alperbasarn/QNOB/ScreenBase_V2/Renders/side.png

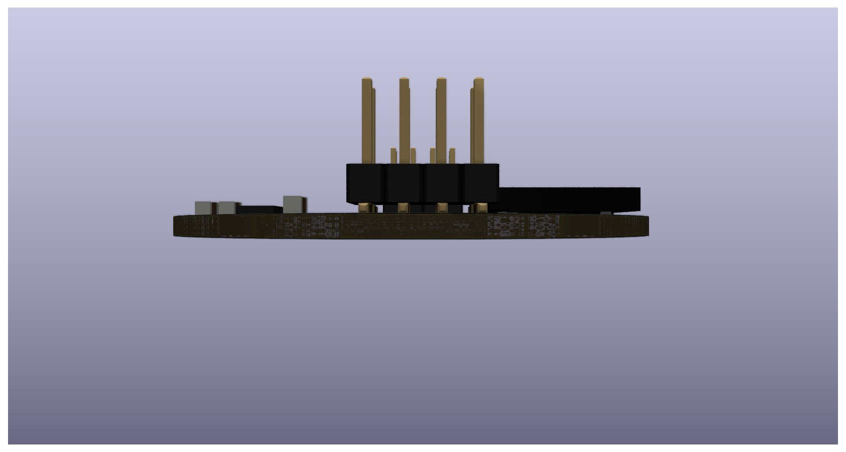
ScreenBase_V2/Renders/side.png
