alperbasarn/QNOB/DRV8313-breakout/V1/DRV8313-breakout/Doc/Top.png

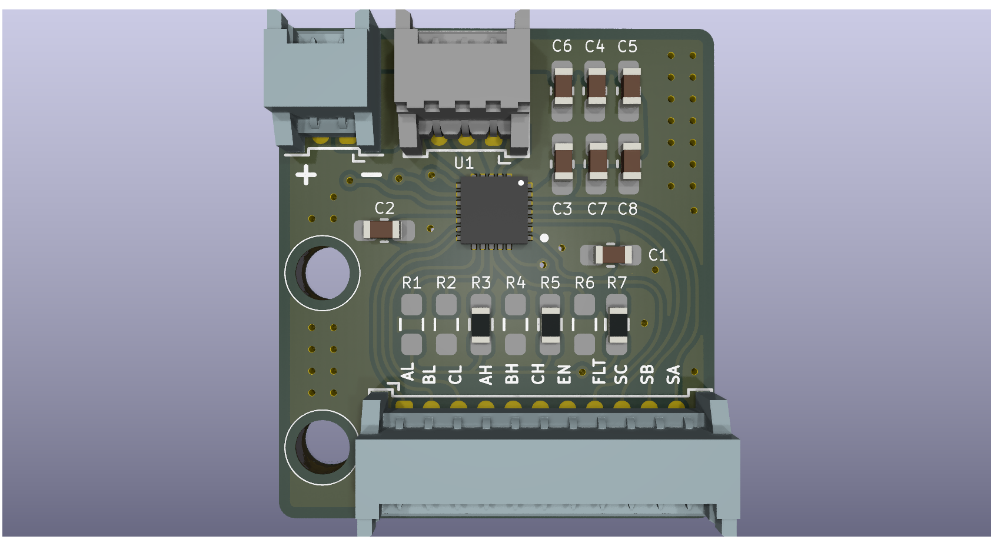
DRV8313-breakout/V1/DRV8313-breakout/Doc/Top.png
