alperbasarn/QNOB/V11/V11_report.txt

PCB statistics report
=====================
- Date: 14/01/2026 09:56:32
- Project: V11
- Board name: V11

Board
-----
- Width: 47,8708 mm
- Height: 47,4310 mm
- Area: 1745,9295 mm²

Pads
----
- Through hole: 36
- SMD: 88
- Connector: 0
- NPTH: 0

Vias
----
- Through vias: 74
- Blind/buried: 0
- Micro vias: 0

Components
----------

| | Front Side | Back Side | Total |
|---|---|---|---|
|THT: | 0 | 4 | 4 |
|SMD: | 24 | 0 | 24 |
|Unspecified:  | 4 | 0 | 4 |
|Total: | 28 | 4 | 32 |

Drill holes
-----------

| Count | Shape | X Size | Y Size | Plated | Via/Pad | Start Layer | Stop Layer |
|---|---|---|---|---|---|---|---|
| 74 | Round | 0,4000 mm | 0,4000 mm | PTH | Via | F.Cu | B.Cu |
| 16 | Round | 1,2700 mm | 1,2700 mm | PTH | Pad | F.Cu | B.Cu |
| 9 | Round | 0,2000 mm | 0,2000 mm | PTH | Pad | F.Cu | B.Cu |
| 7 | Round | 0,5000 mm | 0,5000 mm | PTH | Pad | F.Cu | B.Cu |
| 4 | Round | 1,0000 mm | 1,0000 mm | PTH | Pad | F.Cu | B.Cu |
