alperbasarn/QNOB/PCB/V6/QNOB_V6/Datasheets/LM66100-3v3.png

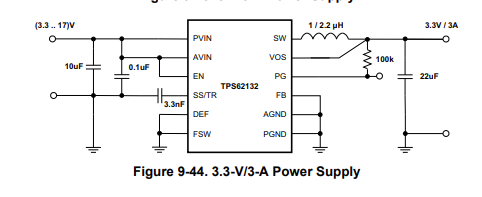
PCB/V6/QNOB_V6/Datasheets/LM66100-3v3.png
