alperbasarn/QNOB/ScreenBase_V2/Renders/bottom.png

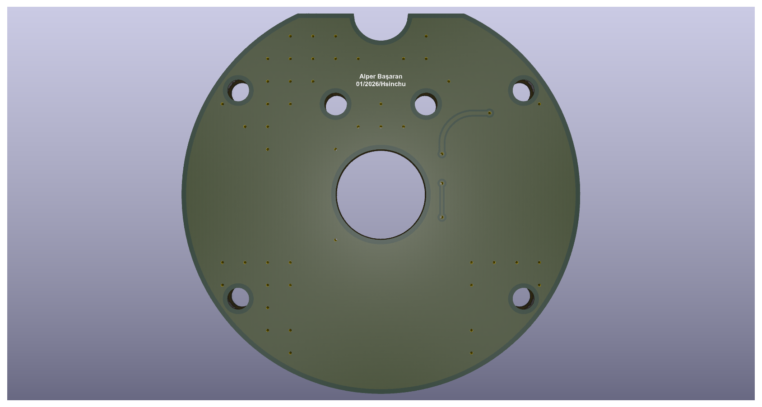
ScreenBase_V2/Renders/bottom.png
