alperbasarn/QNOB/ScreenBase_V2/Renders/iso.png

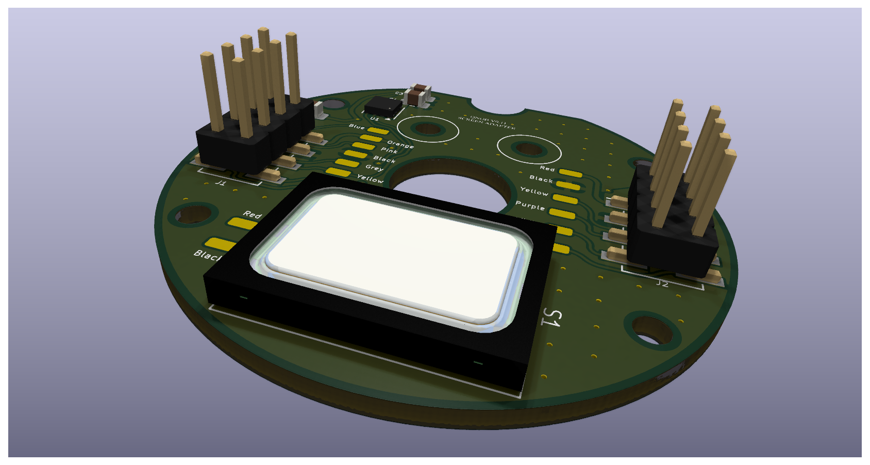
ScreenBase_V2/Renders/iso.png
