alperbasarn/QNOB/ScreenBase_V2/Renders/top.png

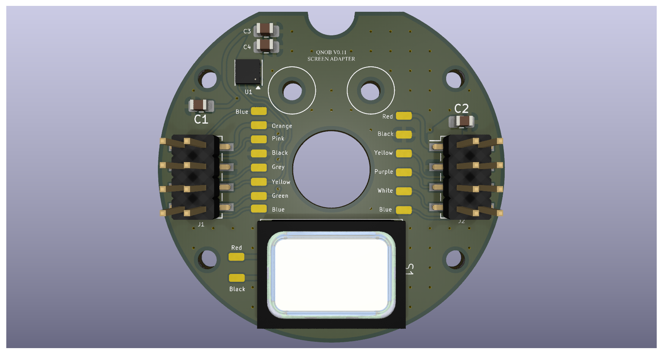
ScreenBase_V2/Renders/top.png
