alperbasarn/QNOB/V11/Fabrication/BOM.xlsx

Comment | Designator | Footprint | JLCPCB Part #（optional）
100n | C1,C3,C5,C7,C9 | 603 | C14663
4.7u | C2 | 603 | C19666
10u | C4,C6,C8 | 603 | C96446
0 | R3,R5 | 603 | C21189
4.7k | R7,R8,R9 | 603 | C23162
DRV8311HRWR | U1 | WQFN-24(3x3) | C5218862
MT6701QT | U3 | QFN-16-1EP_3x3mm_P0.5mm_EP1.7x1.7mm | C2913974
