alperbasarn/QNOB/PCB/V6/QNOB_V6/QNOB_V6/Fabrication/BOM.xlsx

Comment | Designator | Footprint | LCSC Part #（optional）
4.7u | C1 | 603 | C19666
10u | C2 | 603 | C96446
10u | C3 | 603 | C96446
100n | C4 | 603 | C14663
100n | C5 | 603 | C14663
100n | C6 | 603 | C14663
100n | C7 | 603 | C14663
100n/0402 | C8 | 402 | C1525
100n/0402 | C10 | 402 | C1525
100n/0402 | C11 | 402 | C1525
100n/0402 | C12 | 402 | C1525
100n/0402 | C13 | 402 | C1525
100n/0402 | C14 | 402 | C1525
100n/0402 | C15 | 402 | C1525
100n/0402 | C16 | 402 | C1525
100n/0402 | C17 | 402 | C1525
100n/0402 | C18 | 402 | C1525
100n/0402 | C19 | 402 | C1525
100n/0402 | C20 | 402 | C1525
100n/0402 | C21 | 402 | C1525
100n/0402 | C22 | 402 | C1525
100n/0402 | C23 | 402 | C1525
100n/0402 | C24 | 402 | C1525
100n/0402 | C25 | 402 | C1525
100n/0402 | C26 | 402 | C1525
100n/0402 | C27 | 402 | C1525
100n/0402 | C28 | 402 | C1525
100n/0402 | C29 | 402 | C1525
100n/0402 | C30 | 402 | C1525
100n/0402 | C31 | 402 | C1525
100n/0402 | C32 | 402 | C1525
100n/0402 | C33 | 402 | C1525
100n/0402 | C34 | 402 | C1525
100n/0402 | C35 | 402 | C1525
100n/0402 | C36 | 402 | C1525
100n/0402 | C37 | 402 | C1525
100n/0402 | C38 | 402 | C1525
100n/0402 | C39 | 402 | C1525
100n/0402 | C40 | 402 | C1525
100n/0402 | C41 | 402 | C1525
100n/0402 | C42 | 402 | C1525
100n/0402 | C43 | 402 | C1525
100n/0402 | C44 | 402 | C1525
100n/0402 | C45 | 402 | C1525
100n/0402 | C46 | 402 | C1525
100n/0402 | C47 | 402 | C1525
100n/0402 | C48 | 402 | C1525
100n/0402 | C49 | 402 | C1525
100n/0402 | C50 | 402 | C1525
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
Adressable RGB LED | U51 | 606 | C2890035
Adressable RGB LED | U52 | 606 | C2890035
Adressable RGB LED | U53 | 606 | C2890035
RTC | U54 | 606 | C26858
Environment sensor | U55 | SMT | C3664478
Lux sensor | U57 | SMT | C511034
32768 crystal | Y1 | 3215-2p | C32346
