alperbasarn/QNOB/3D/Design/Big/KNOB_Basic.stl

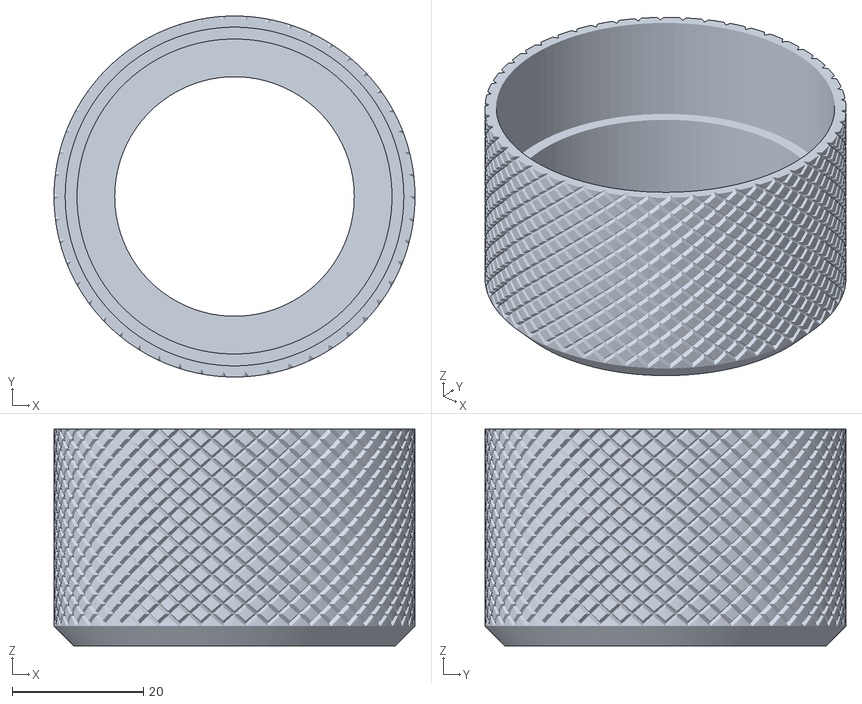
[picture p9: CAD file, 2026-02-01]
3D/Design/Big/KNOB_Basic.stl
55.0 x 55.0 x 33.0
