alperbasarn/QNOB/screen/CAD/ESP32-C6-Touch-AMOLED-1.43-3dFile/ESP32-C6-Touch-AMOLED-1.43-20250704/ESP32-C6-Touch-AMOLED-1_43-20250704.stp

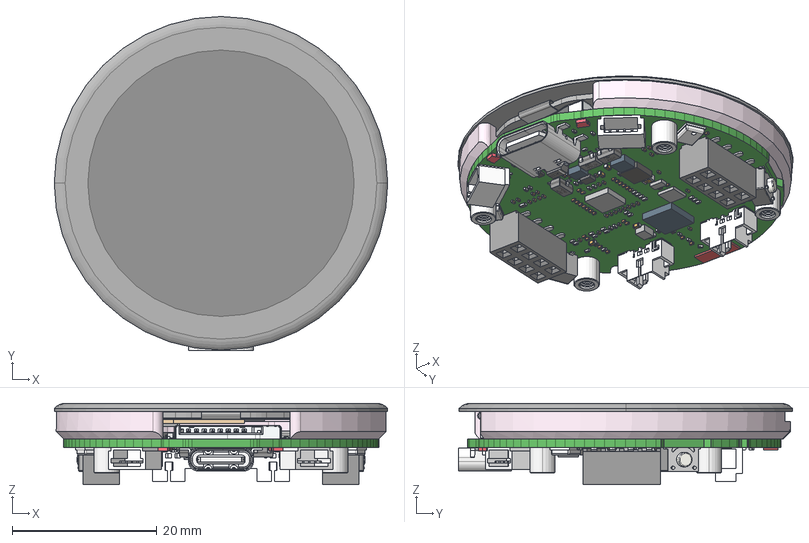
[picture p10: CAD file, 2026-02-01]
screen/CAD/ESP32-C6-Touch-AMOLED-1.43-3dFile/ESP32-C6-Touch-AMOLED-1.43-20250704/ESP32-C6-Touch-AMOLED-1_43-20250704.stp
46.0 x 46.1 x 11.2 mm
BOARD
USER_LIBRARY-0201_0603M__CAP_1 x 103
USER_LIBRARY-0201_0603M__CAP_2 x 103
USER_LIBRARY-0201_0603M__CAP_3 x 103
USER_LIBRARY-RES_0603-0201_1 x 66
USER_LIBRARY-RES_0603-0201_2 x 66
USER_LIBRARY-RES_0603-0201_3 x 66
USER_LIBRARY-RES_0603-0201_4 x 66
EXTRUDED-33499
EXTRUDED-49664
EXTRUDED-50059
EXTRUDED-50454
USER_LIBRARY-WQFN-20
EXTRUDED-70543
EXTRUDED-70938
PIN5TO8_SOP8 x 8
SOP8_BODY
EXTRUDED-76596
EXTRUDED-77015 x 6
EXTRUDED-77412
EXTRUDED-77807
SSOP-16-0_635
5_1_2_A x 7
_7_AF0 x 7
SOT-23 x 3
EXTRUDED-285074
EXTRUDED-285921
EXTRUDED-286316
SWITCHER-4_5X3_3XH3_4 x 2
PITCH1MM-4PIN-SMT-HORIZONTAL x 2
EXTRUDED-300107
EXTRUDED-300502
SOD123F
3_1_A x 7
3_1_2_A x 2
EXTRUDED-388418
TYPE-C_SMT-9X3X7_3
SOD523 x 2
SMTSO-M2-3_5ET x 4
HEADER-SMD-F-2_54-2X4P-H5 x 2
HP1_25MM-2P-SMT-VERTICAL x 2
MIC-4X3X1MM
MIC_2
DO0143FMST02_TP
DO0143FMST14-00
ESP32-C6-TOUCH-1_43-PMMA
