alperbasarn/QNOB/CAD/.STEP/bracketWithScrew v17.step

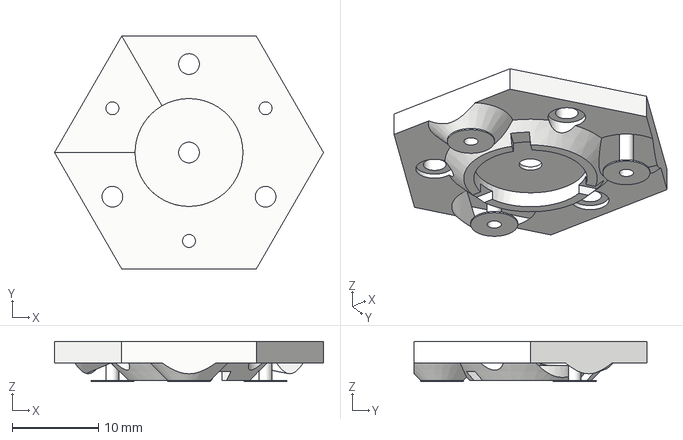
[picture p12: CAD file, 2025-05-01]
CAD/.STEP/bracketWithScrew v17.step
31.2 x 27.0 x 4.65 mm
