alperbasarn/QNOB/PCB/V3/QNOB_V5/3D printed parts/3mf/spacer_new v15.3mf

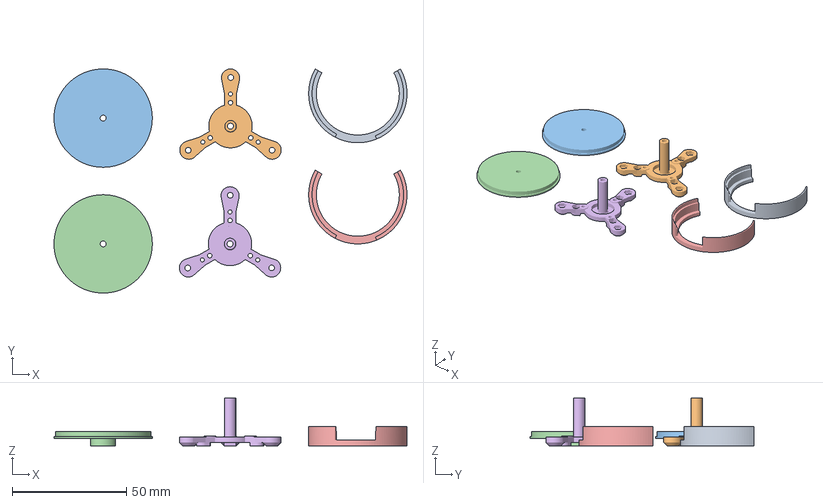
[picture p13: CAD file, 2025-05-01, an earlier design]
PCB/V3/QNOB_V5/3D printed parts/3mf/spacer_new v15.3mf
154.4 x 98.0 x 20.9 mm
screenInterface v17.stl x 2
spacer_new v18.stl x 2
screenHolder v3.stl x 2
