alperbasarn/QNOB/PCB/V3/QNOB_V5/3D printed parts/BaseCap v17.stl

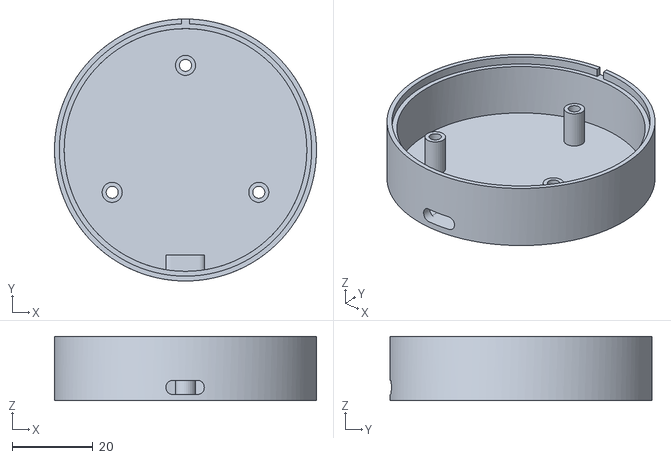
[picture p14: CAD file, 2025-05-01, an earlier design]
PCB/V3/QNOB_V5/3D printed parts/BaseCap v17.stl
65.0 x 65.0 x 16.0
