alperbasarn/QNOB/ScreenBase_V2/Documents/ScreenBase_V2.step

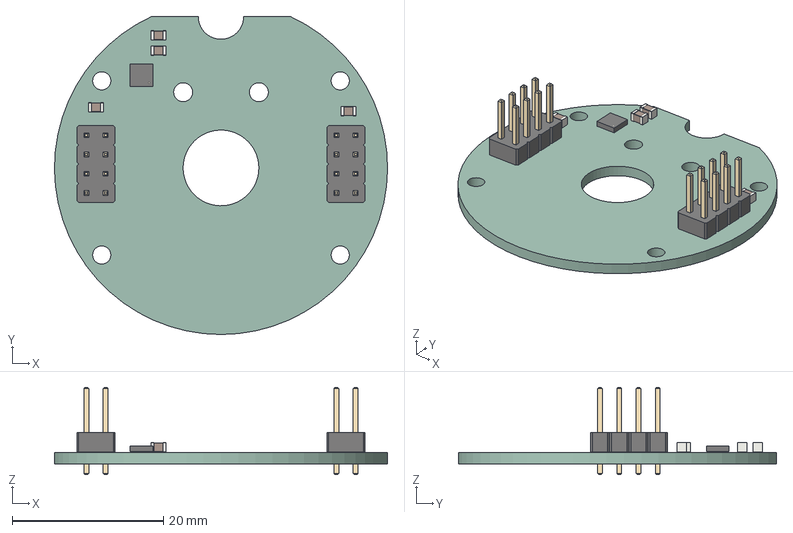
[picture p15: CAD file, 2026-02-01, an earlier design]
ScreenBase_V2/Documents/ScreenBase_V2.step
44.0 x 42.0 x 11.5 mm
C_0805_2012Metric x 4
Bosch_LGA-8_3x3mm_P0.8mm_ClockwisePinNumbering
PinHeader_2x04_P2.54mm_Vertical x 2
ScreenBase_V2_PCB
