alperbasarn/QNOB/PCB/V3/QNOB_V5/3D printed parts/base_cover v7.stl

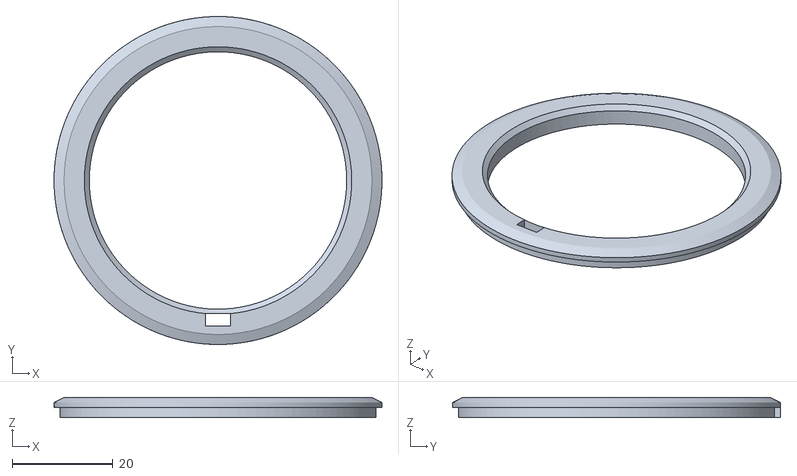
[picture p16: CAD file, 2025-05-01, an earlier design]
PCB/V3/QNOB_V5/3D printed parts/base_cover v7.stl
65.0 x 65.0 x 4.00
