alperbasarn/QNOB/PCB/V3/QNOB_V5/3D printed parts/knob_rev.stl

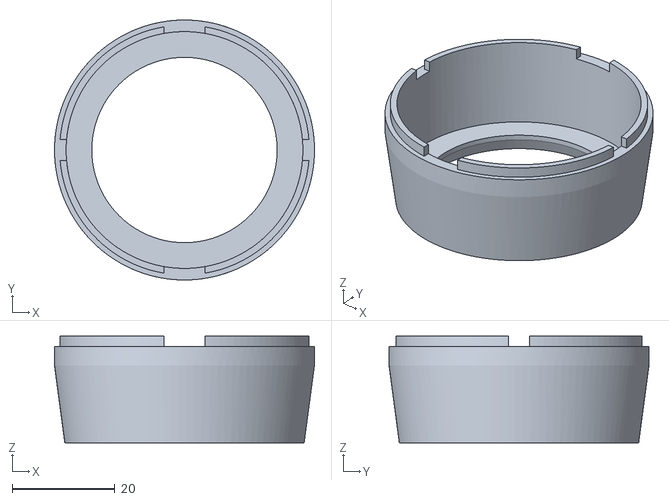
[picture p17: CAD file, 2025-05-01, an earlier design]
PCB/V3/QNOB_V5/3D printed parts/knob_rev.stl
50.5 x 50.5 x 20.8
