alperbasarn/QNOB/PCB/V3/QNOB_V5/3D printed parts/knobFlangeRev v5.3mf

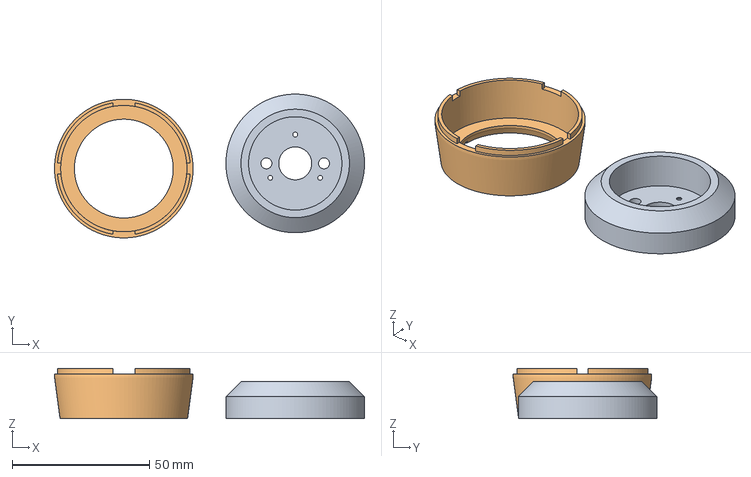
[picture p18: CAD file, 2025-05-01, an earlier design]
PCB/V3/QNOB_V5/3D printed parts/knobFlangeRev v5.3mf
112.9 x 52.4 x 18.2 mm
knobFlangeRev v5.stl
knob_rev v26.stl
