alperbasarn/QNOB/PCB/V3/QNOB_V5/3D printed parts/screenInterface v17.stl

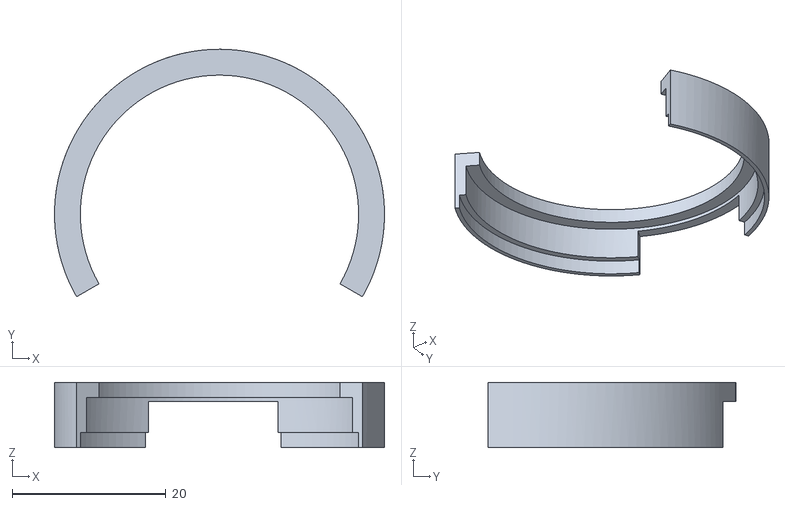
[picture p19: CAD file, 2025-05-01, an earlier design]
PCB/V3/QNOB_V5/3D printed parts/screenInterface v17.stl
43.0 x 32.2 x 8.50
