alperbasarn/QNOB/PCB/V3/QNOB_V5/3D printed parts/knob_flange.stl

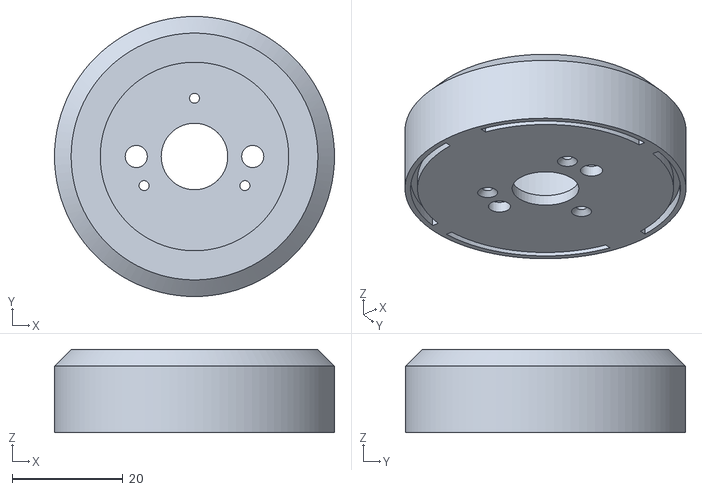
[picture p20: CAD file, 2025-05-01, an earlier design]
PCB/V3/QNOB_V5/3D printed parts/knob_flange.stl
50.5 x 50.5 x 15.0
