alperbasarn/QNOB/PCB/V3/QNOB_V5/3D printed parts/screenHolder v3.stl

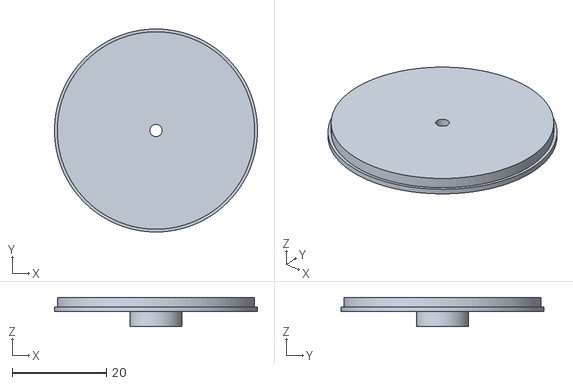
[picture p21: CAD file, 2025-05-01, an earlier design]
PCB/V3/QNOB_V5/3D printed parts/screenHolder v3.stl
43.0 x 43.0 x 6.20
