alperbasarn/QNOB/PCB/V3/QNOB_V5/3D printed parts/base_enclosure.3mf

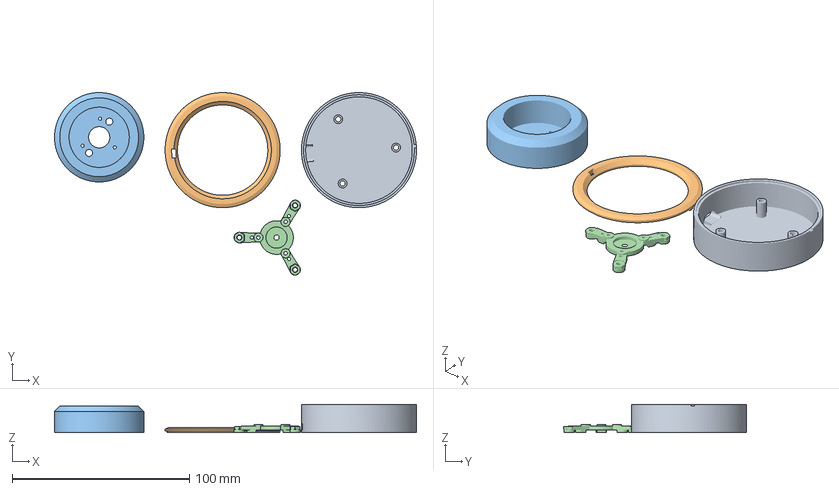
[picture p22: CAD file, 2025-05-01, an earlier design]
PCB/V3/QNOB_V5/3D printed parts/base_enclosure.3mf
204.5 x 103.3 x 16.0 mm
base_enclosure.stl
base_cover.stl
knob_flange.stl
spacer.stl
