alperbasarn/QNOB/PCB/V3/QNOB_V5/3D printed parts/base_cover.stl

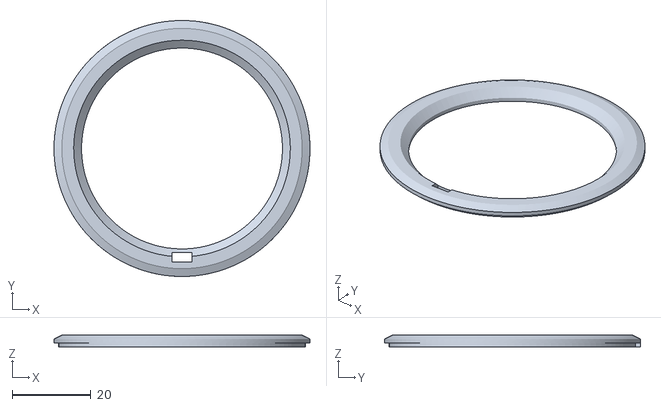
[picture p23: CAD file, 2025-05-01, an earlier design]
PCB/V3/QNOB_V5/3D printed parts/base_cover.stl
65.0 x 65.0 x 3.00
