alperbasarn/QNOB/PCB/V3/QNOB_V5/3D printed parts/spacer_new v17.stl

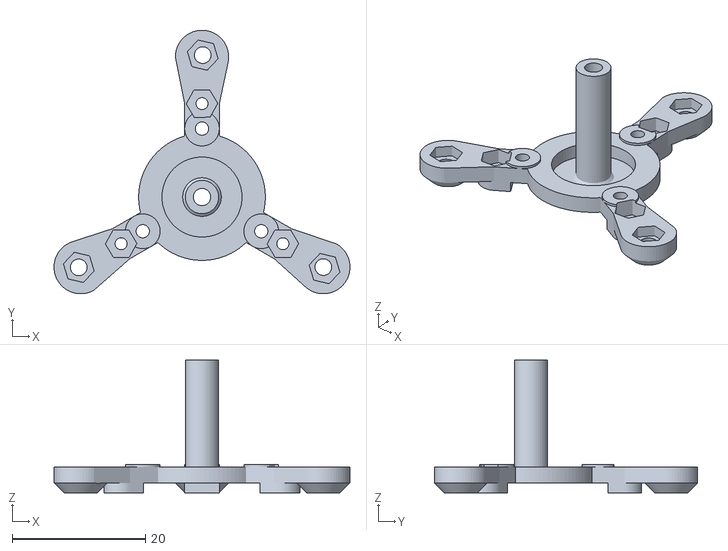
[picture p24: CAD file, 2025-05-01, an earlier design]
PCB/V3/QNOB_V5/3D printed parts/spacer_new v17.stl
44.4 x 39.5 x 19.9
