alperbasarn/QNOB/(list of files, cad)

Other CAD files:
screen/CAD/ESP32-C6-Touch-AMOLED-1.43-3dFile/ESP32-C6-Touch-AMOLED-1.43-20250704/ESP32-C6-Touch-AMOLED-1.43-20250704.dwg
ScreenBase_V2/Documents/ScreenBase_V4.step
PCB/V3/QNOB_V5/3D printed parts/base_enclosure.stl
PCB/V3/QNOB_V5/3D printed parts/knobFlangeRev v5.f3d
PCB/V3/QNOB_V5/3D printed parts/knobFlangeRev v5.stl
PCB/V3/QNOB_V5/3D printed parts/knob_rev v26.stl
PCB/V3/QNOB_V5/3D printed parts/spacer_new v15.stl
PCB/V3/QNOB_V5/3D printed parts/spacer_new v17.f3d
PCB/V3/QNOB_V5/3D printed parts/spacer_new v18.stl
