alperbasarn/QNOB/ScreenBase_V2/Documents/Schematic.pdf

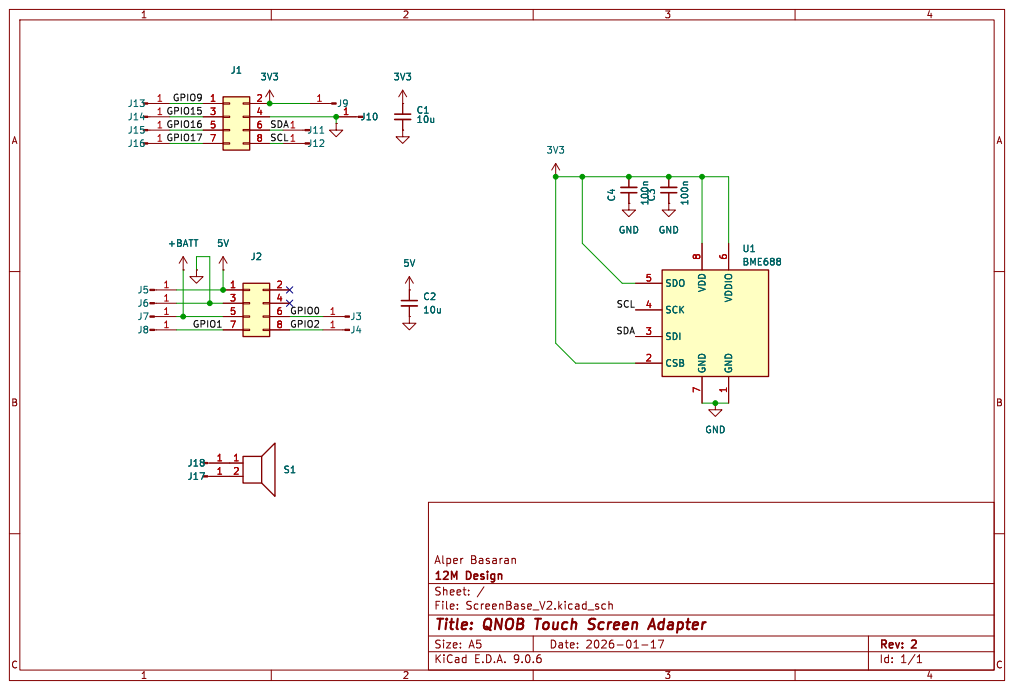
[picture p25: page 1]

7 SDO 5 SCK 4 SDI 3 CSB 2 U1BME688 GND

7 SDO 5 SCK 4 SDI 3 CSB 2
