alperbasarn/QNOB/PCB/V6/QNOB_V6/Documentation/Schematics.pdf

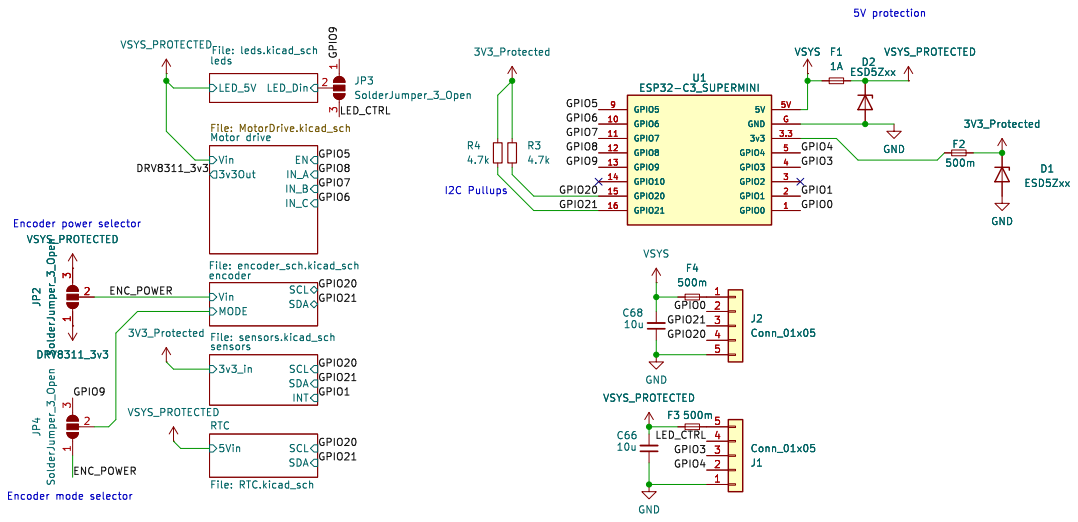
[picture p26: page 1]

3v3Out Motor drive File: MotorDrive.kicad_sch

I2C Pullups Encoder mode selector

SCL Vin MODE
sensors File: sensors.kicad_sch SDA

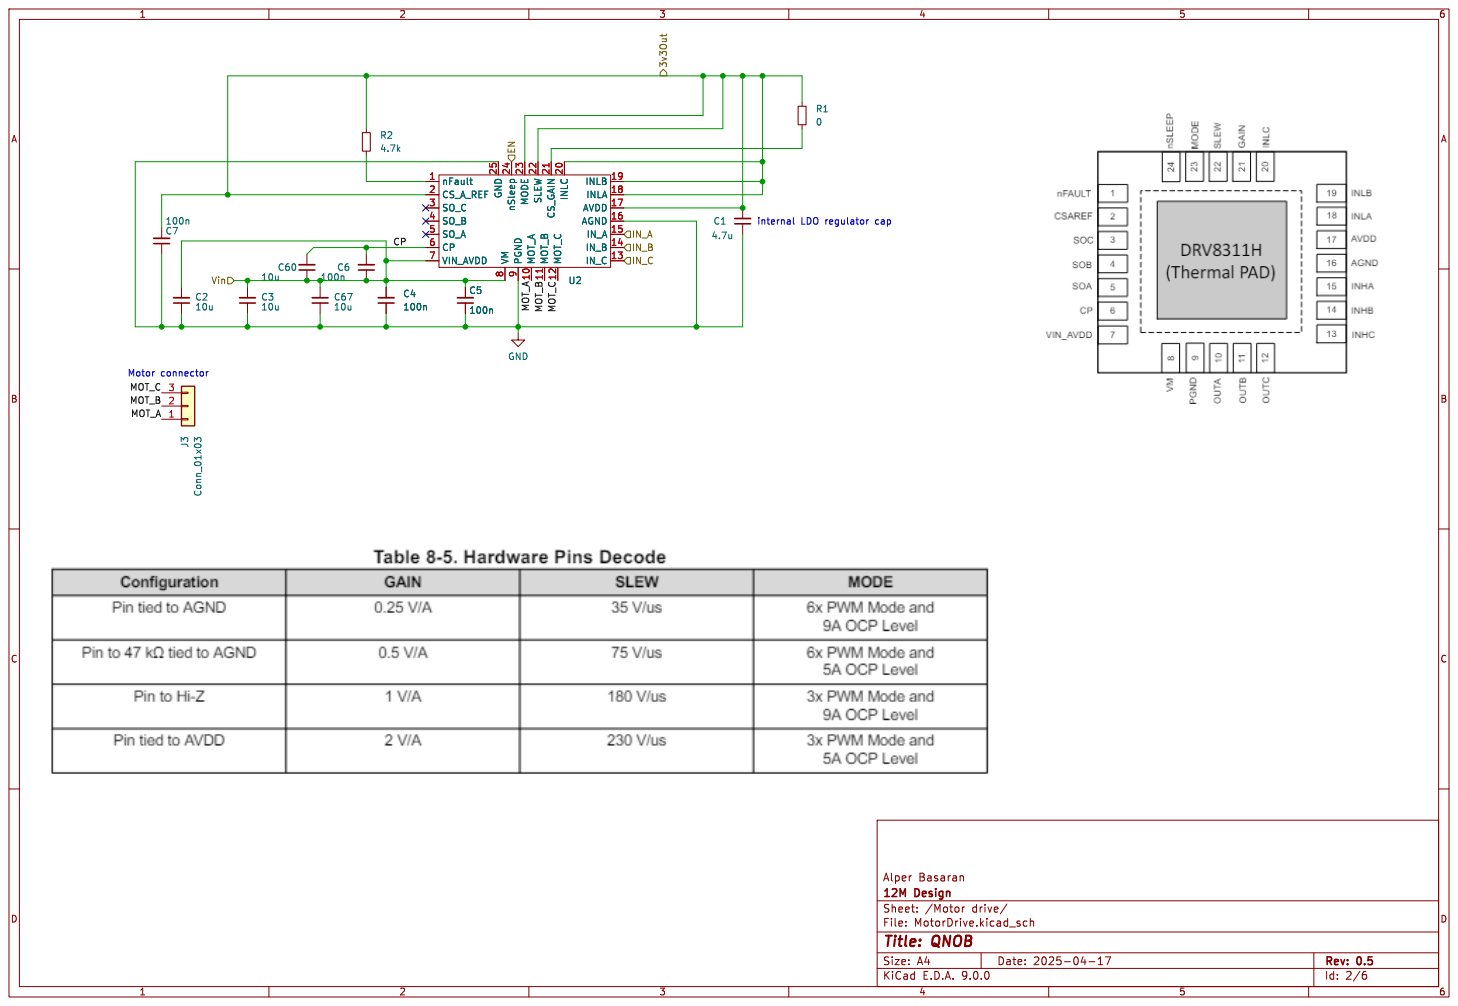
[picture p27: page 2]

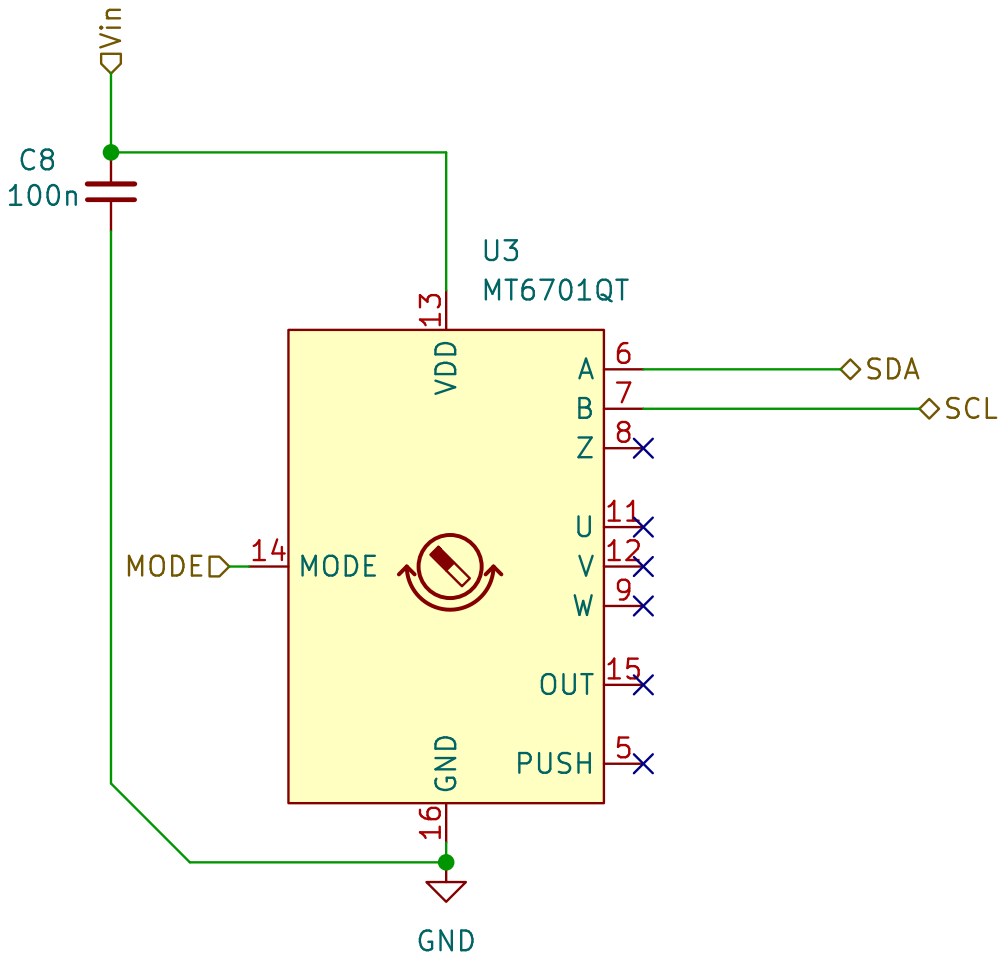
[picture p28: page 3]

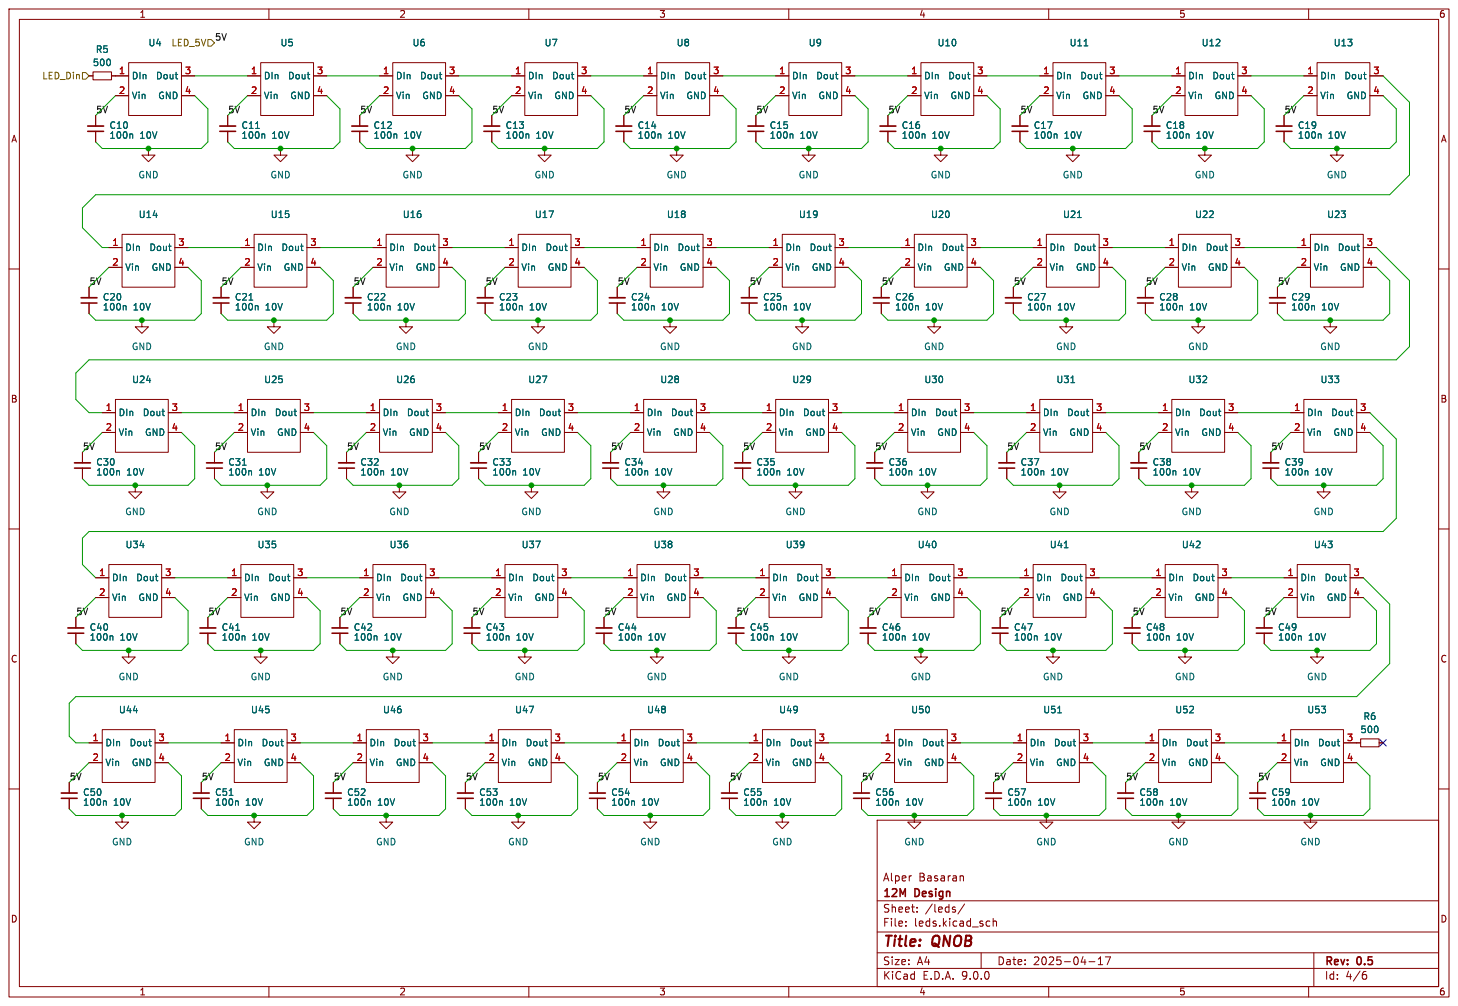
[picture p29: page 4]

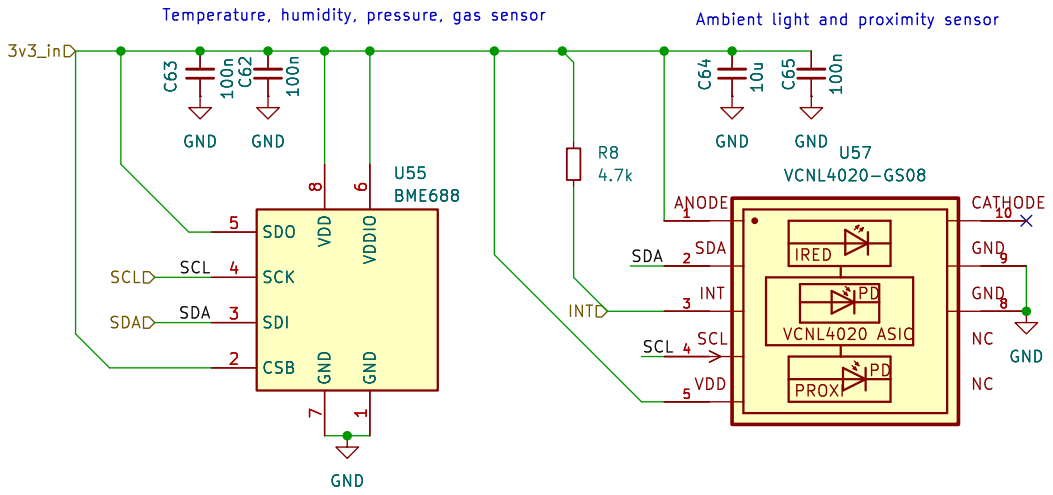
[picture p30: page 5]

7 SDO 5 SCK 4 SDI 3 CSB 2 GND GND C63 100n C62 100n

7 SDO 5 SCK 4 SDI 3 CSB 2 U55 BME688 R8

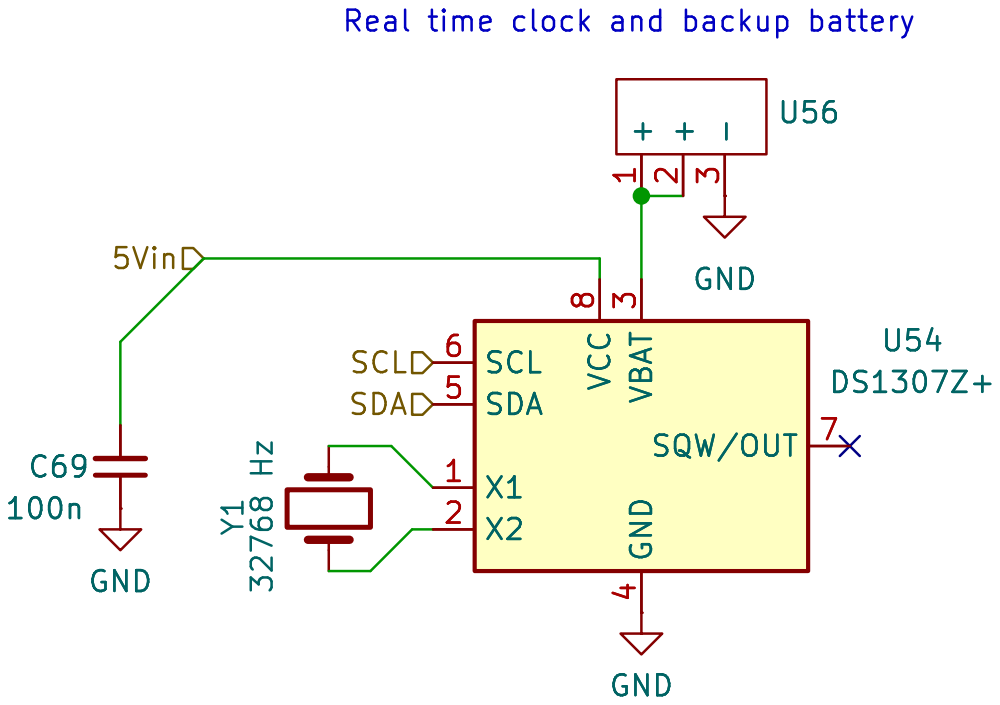
[picture p31: page 6]
