alperbasarn/QNOB/ScreenBase_V2/Documents/PCB_Layers.pdf

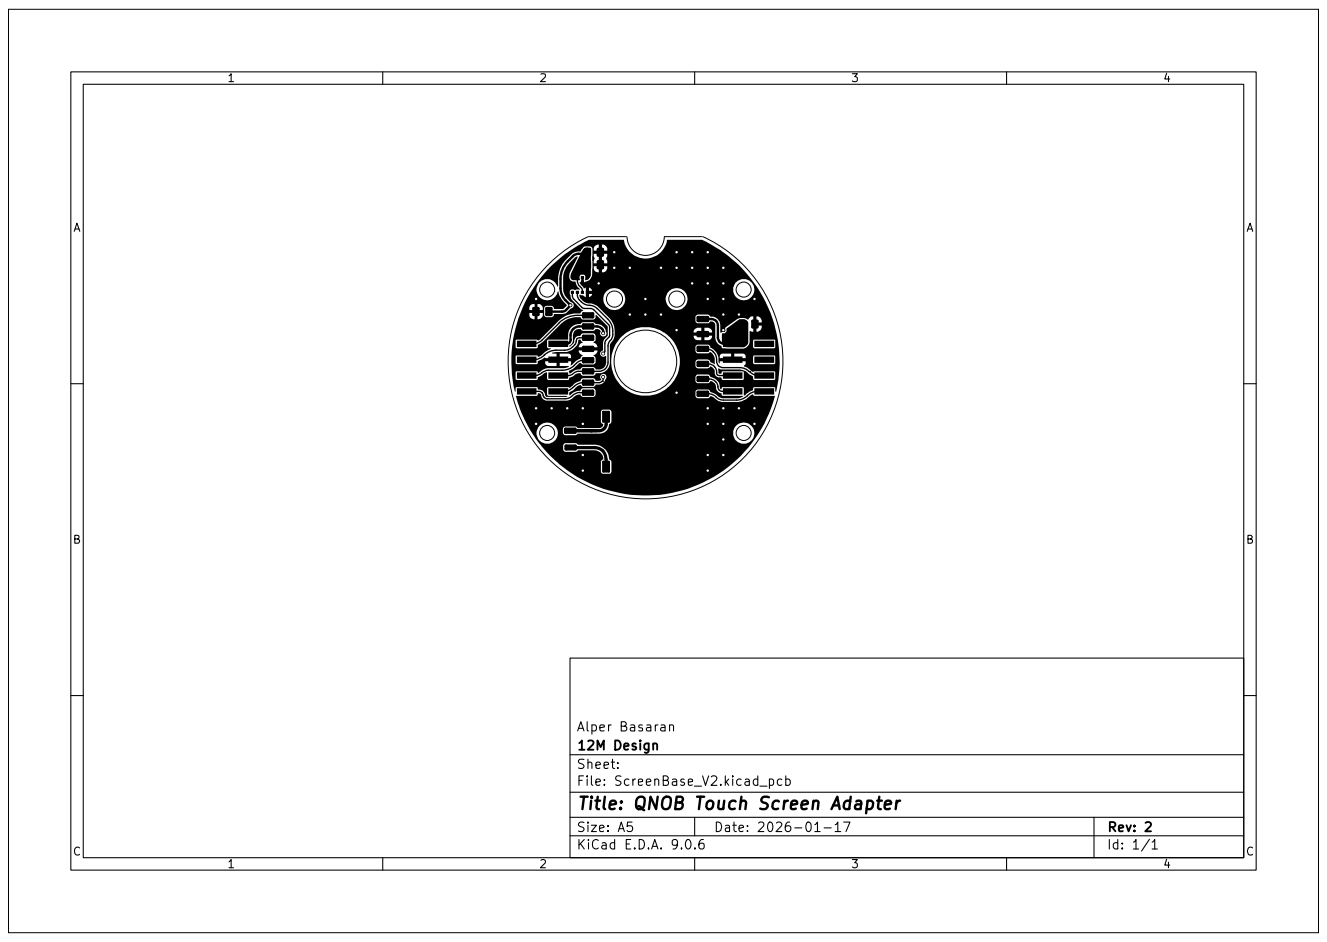
[picture p32: page 1]

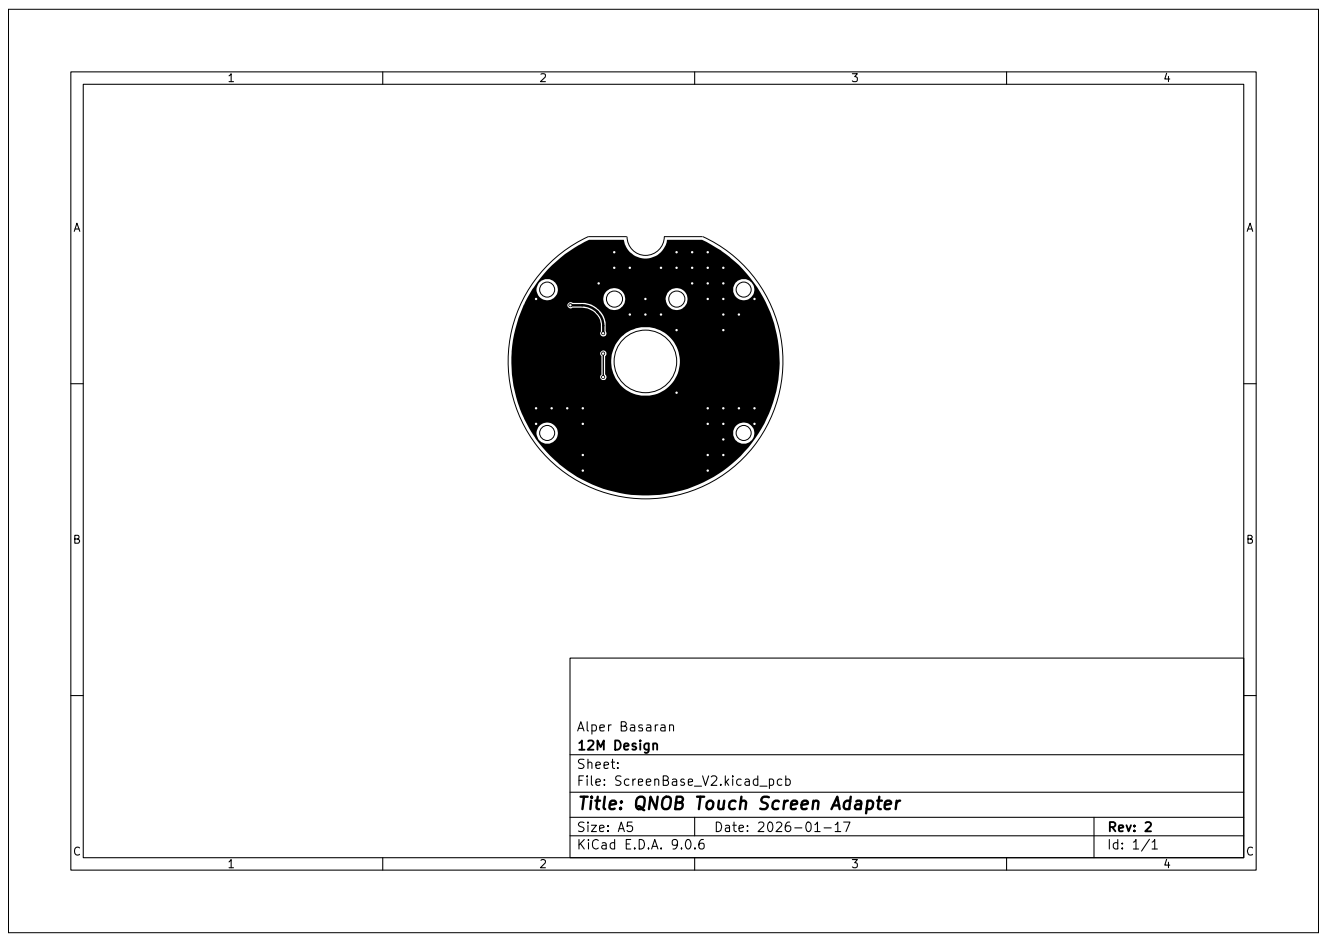
[picture p33: page 2]

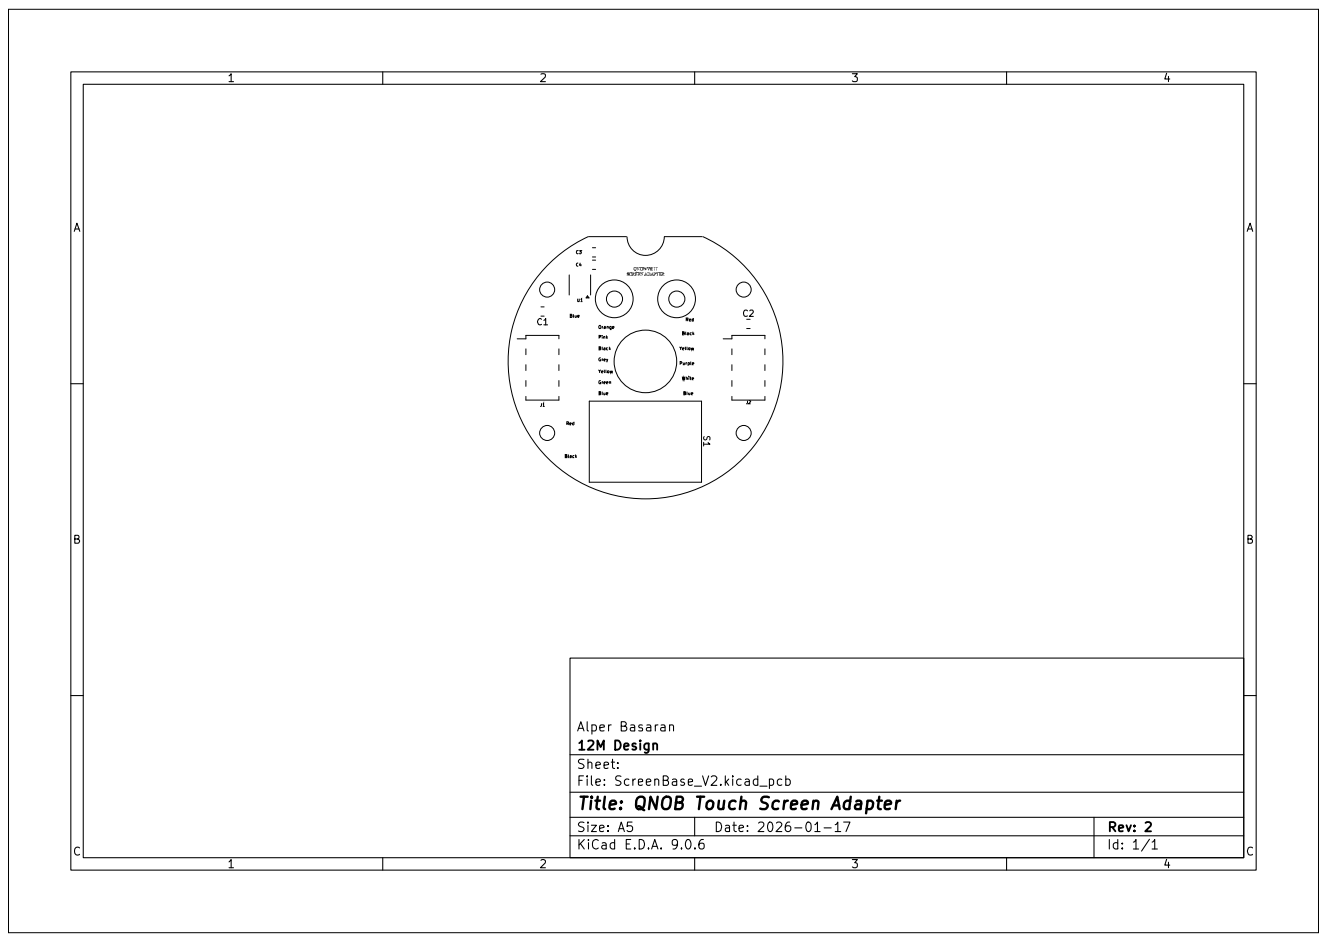
[picture p34: page 3]

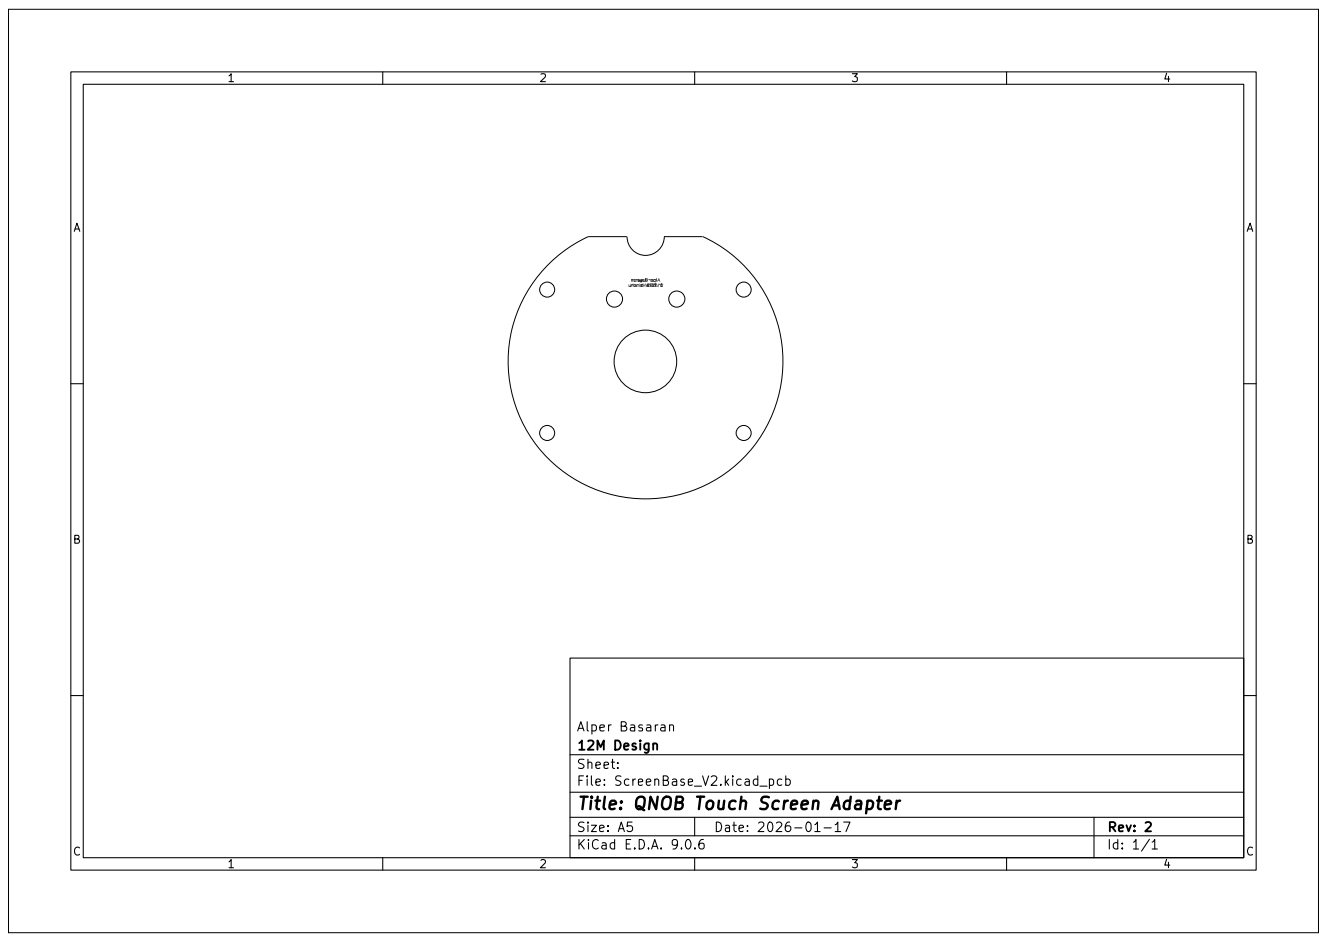
[picture p35: page 4]

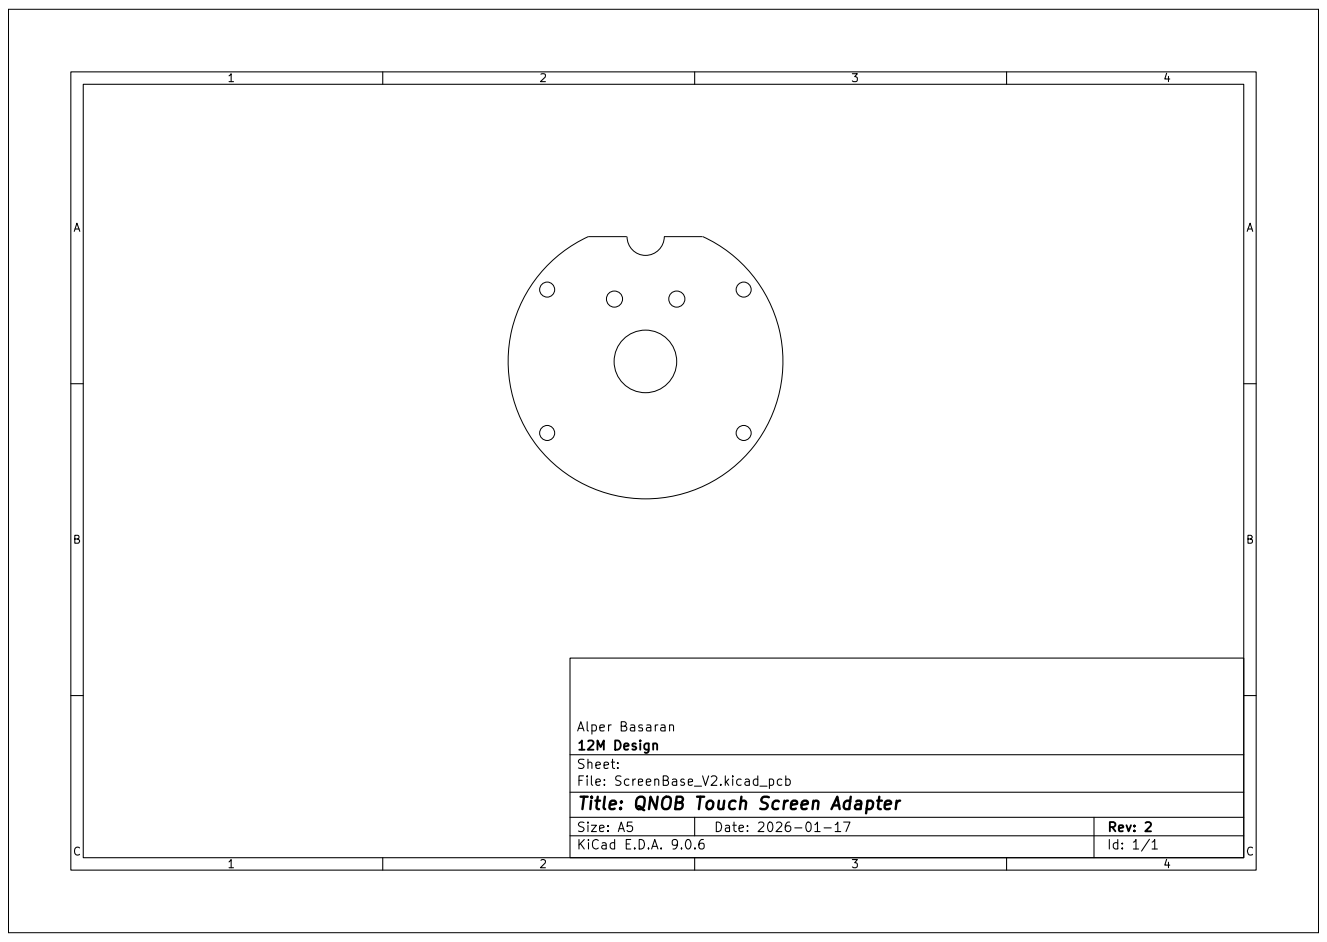
[picture p36: page 5]
