alperbasarn/QNOB/screen/CAD/ESP32-C6-Touch-AMOLED-1.43-3dFile/ESP32-C6-Touch-AMOLED-1.43-20250704/ESP32-C6-Touch-AMOLED-1.43-20250704.pdf

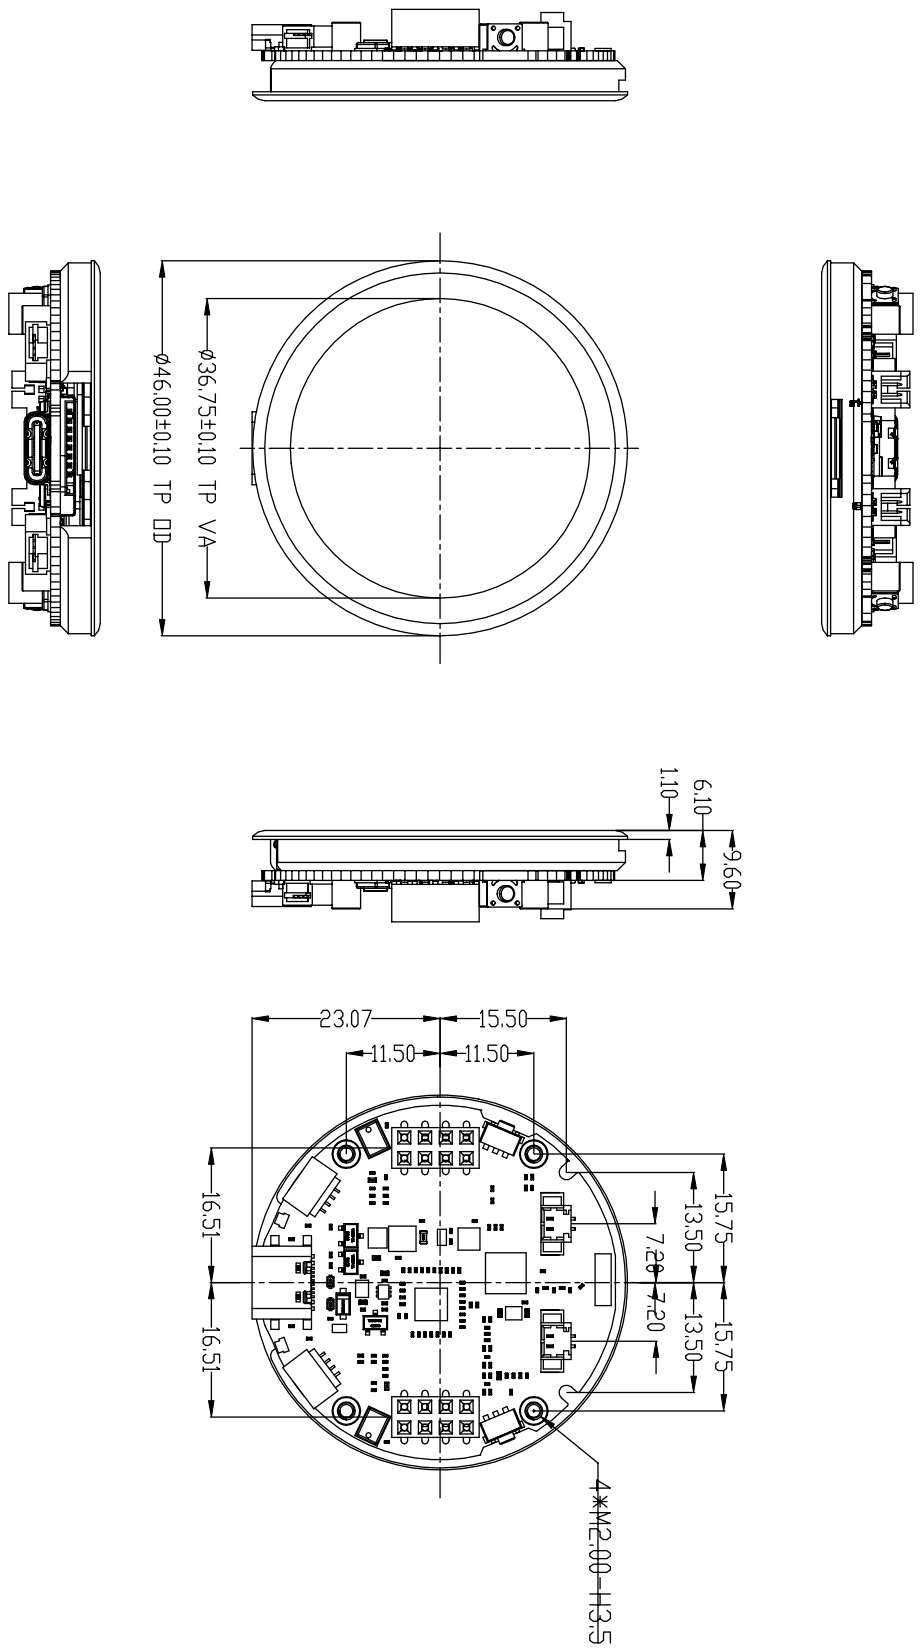
[picture p37: page 1]
