alperbasarn/QNOB/DRV8313-breakout/V1/DRV8313-breakout/Doc/DRV8313-breakout.pdf

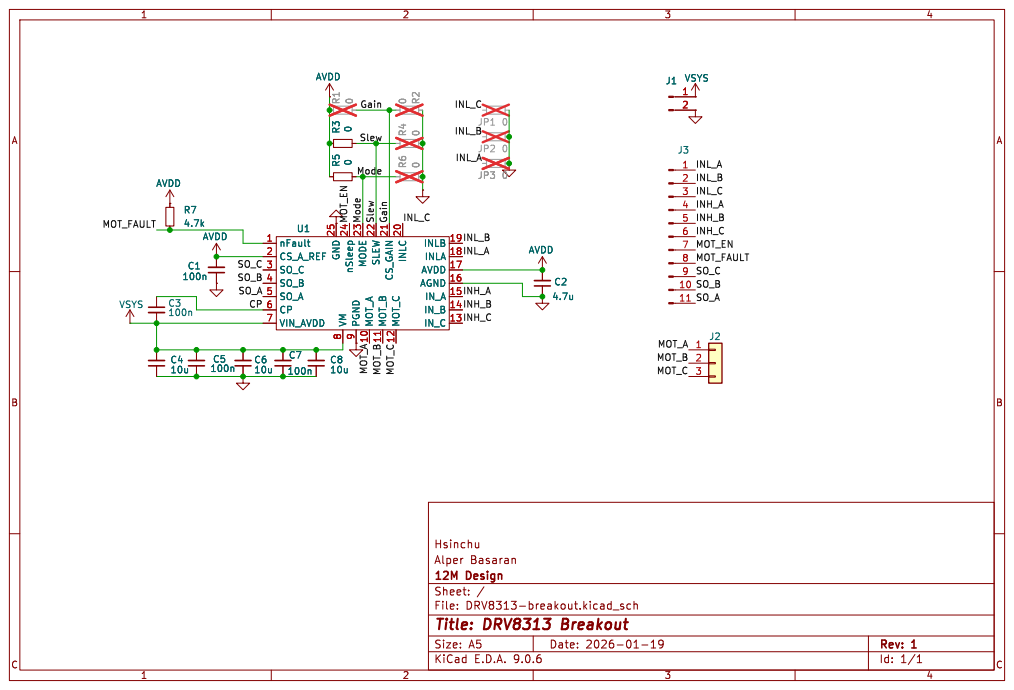
[picture p38: page 1]

Alper Basaran Hsinchu AVDD
