alperbasarn/QNOB/DRV8313-breakout/V1/DRV8313-breakout/Doc/PCB Layers.pdf

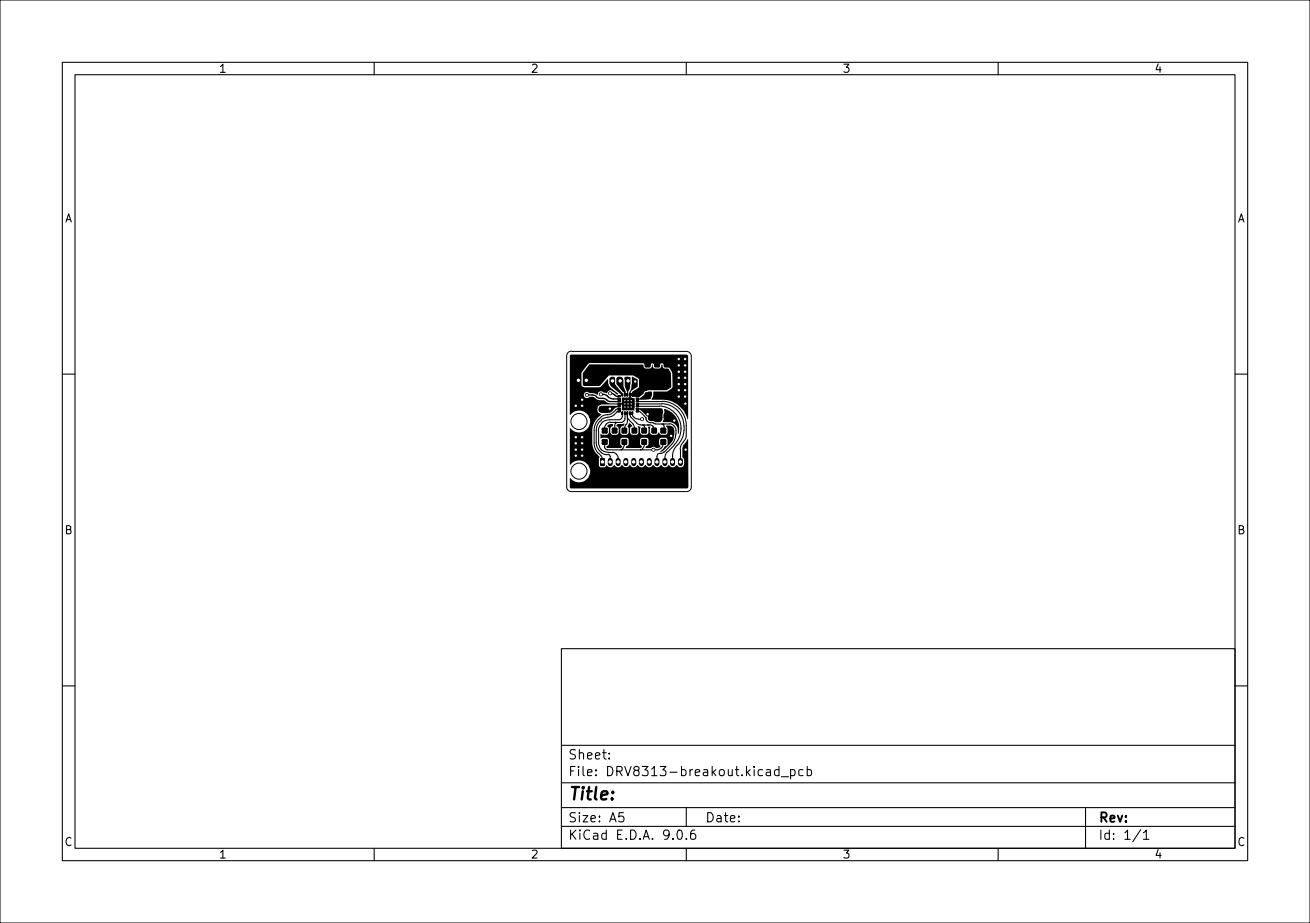
[picture p39: page 1]

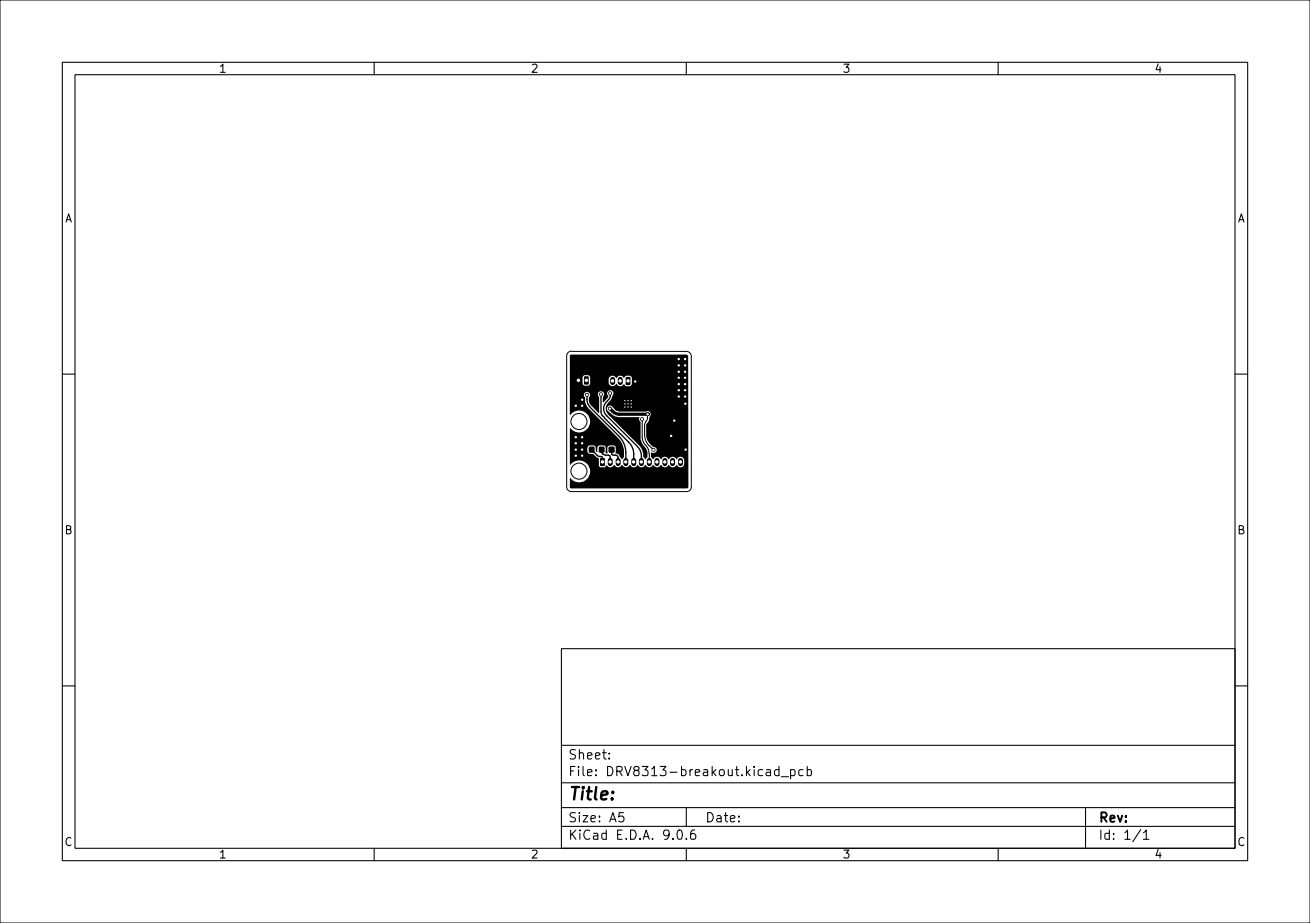
[picture p40: page 2]

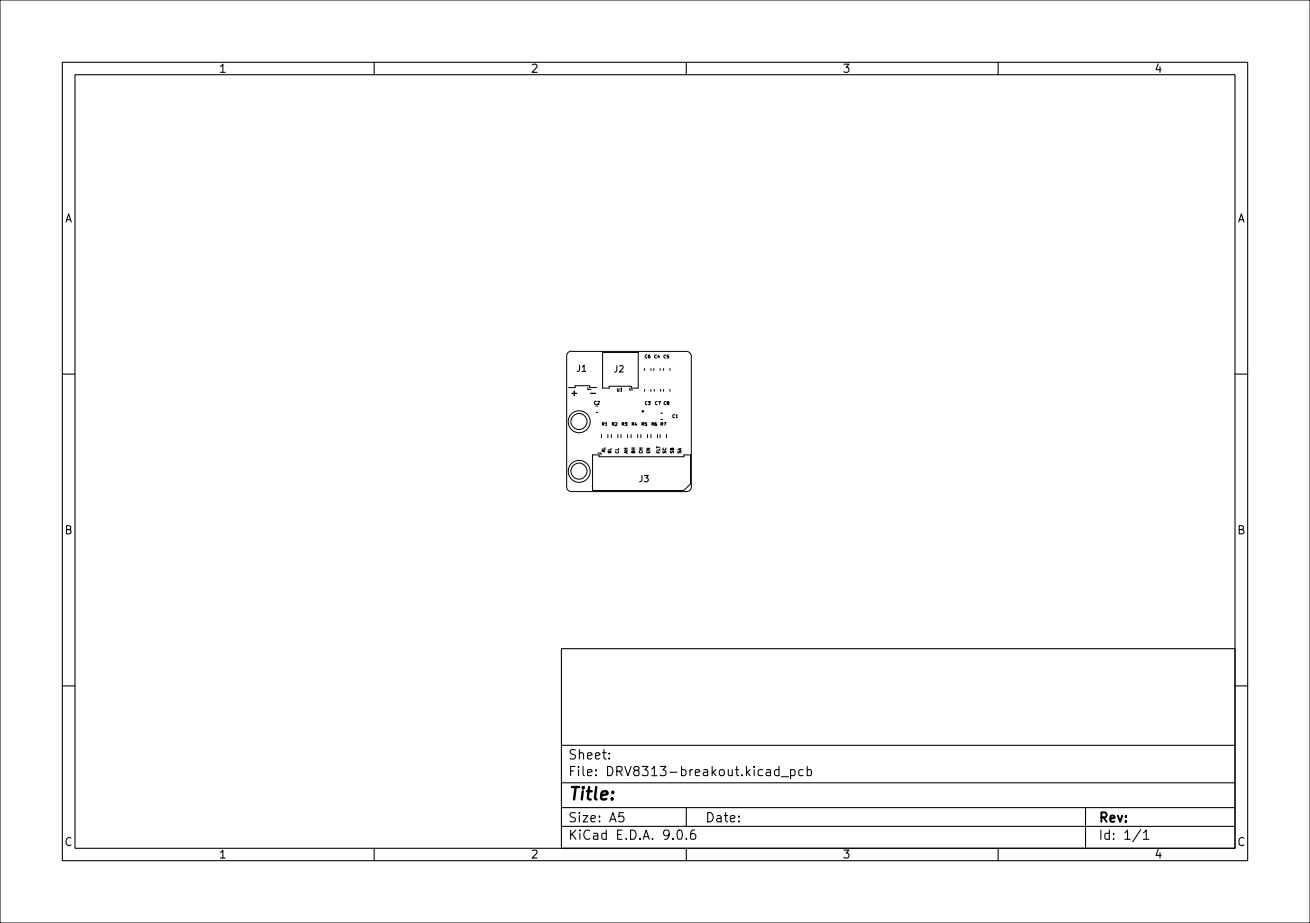
[picture p41: page 3]

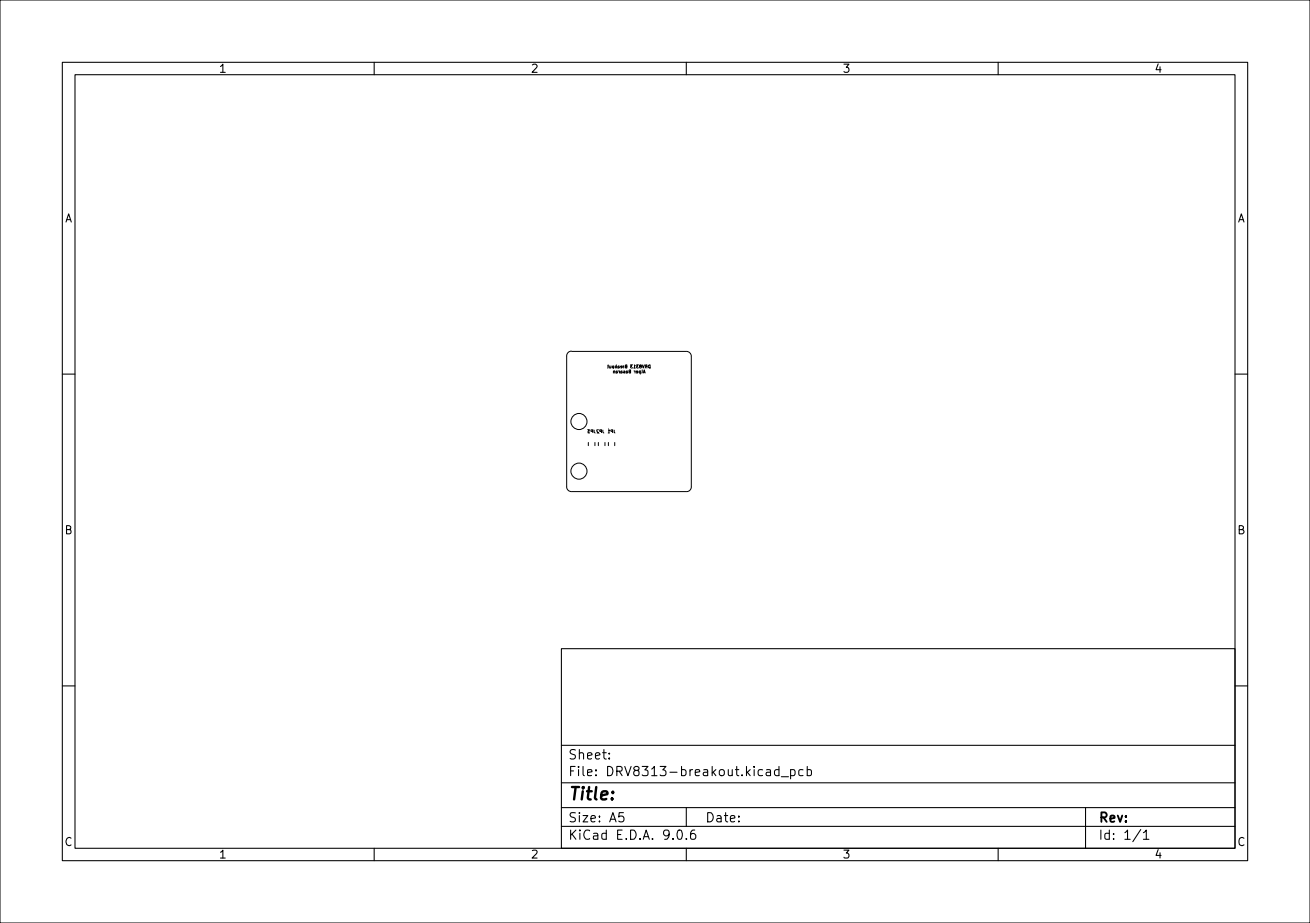
[picture p42: page 4]

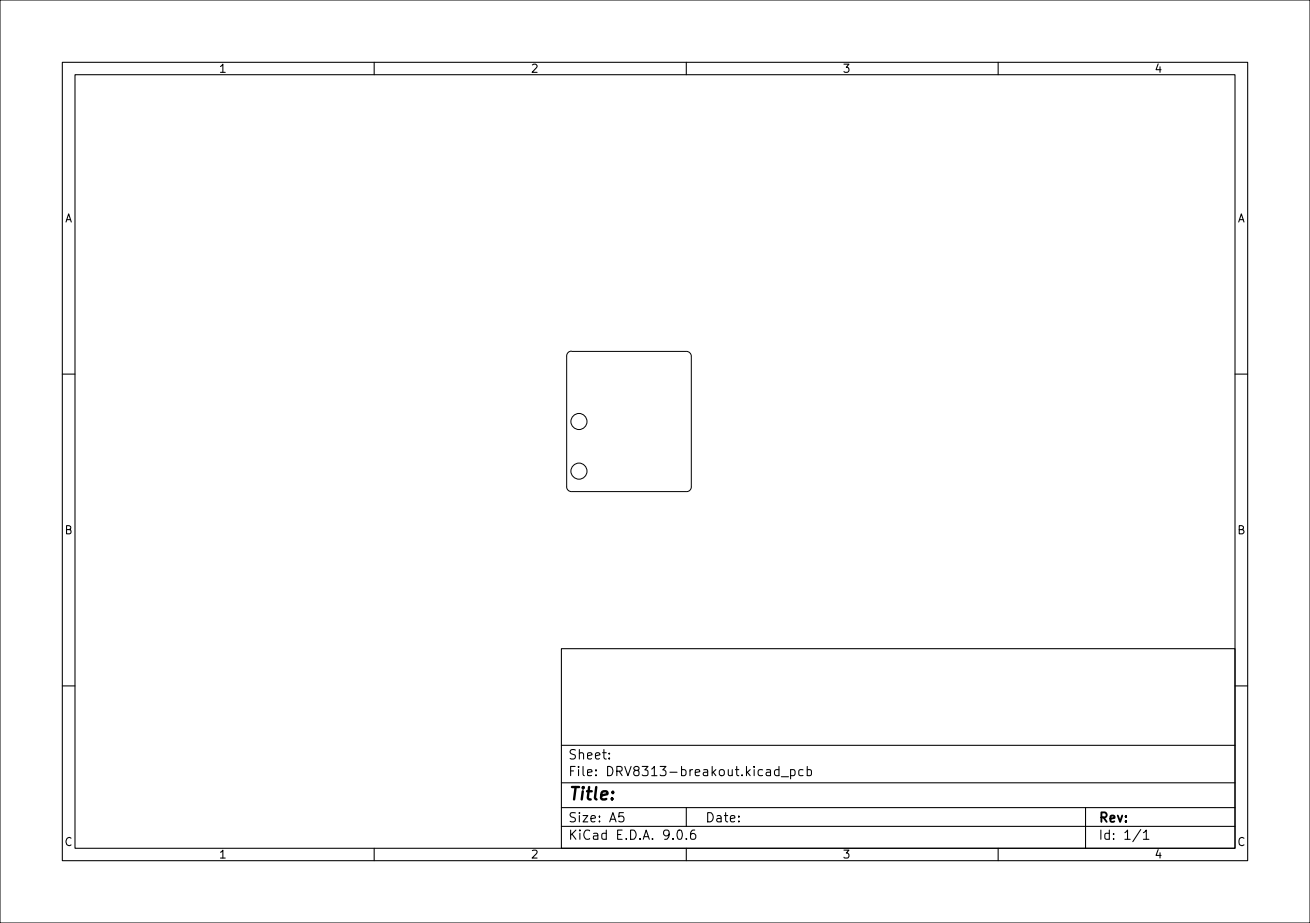
[picture p43: page 5]
