alperbasarn/QNOB/PCB/V3/QNOB_V5/Documentation/Gerber_print.pdf

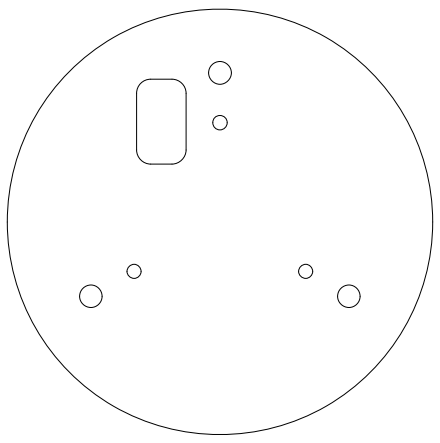
[picture p44: figure]
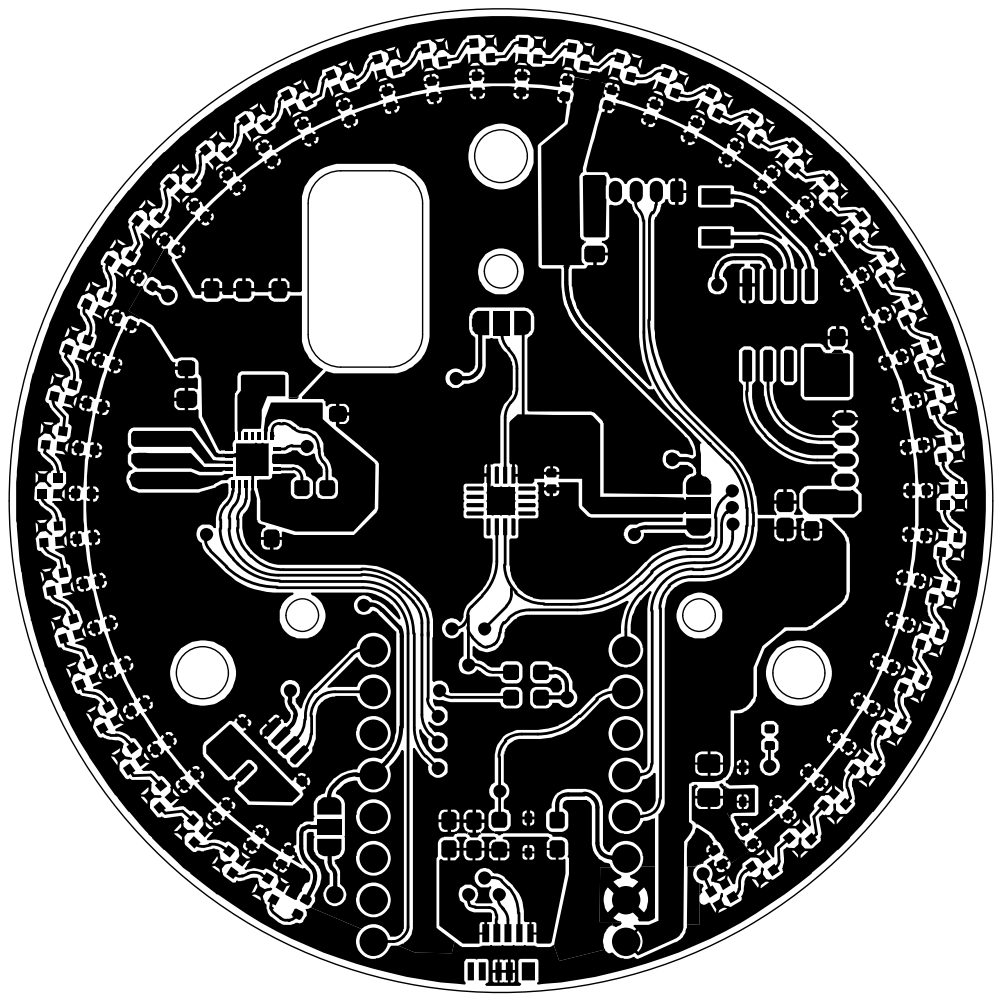
[picture p45: page 2]

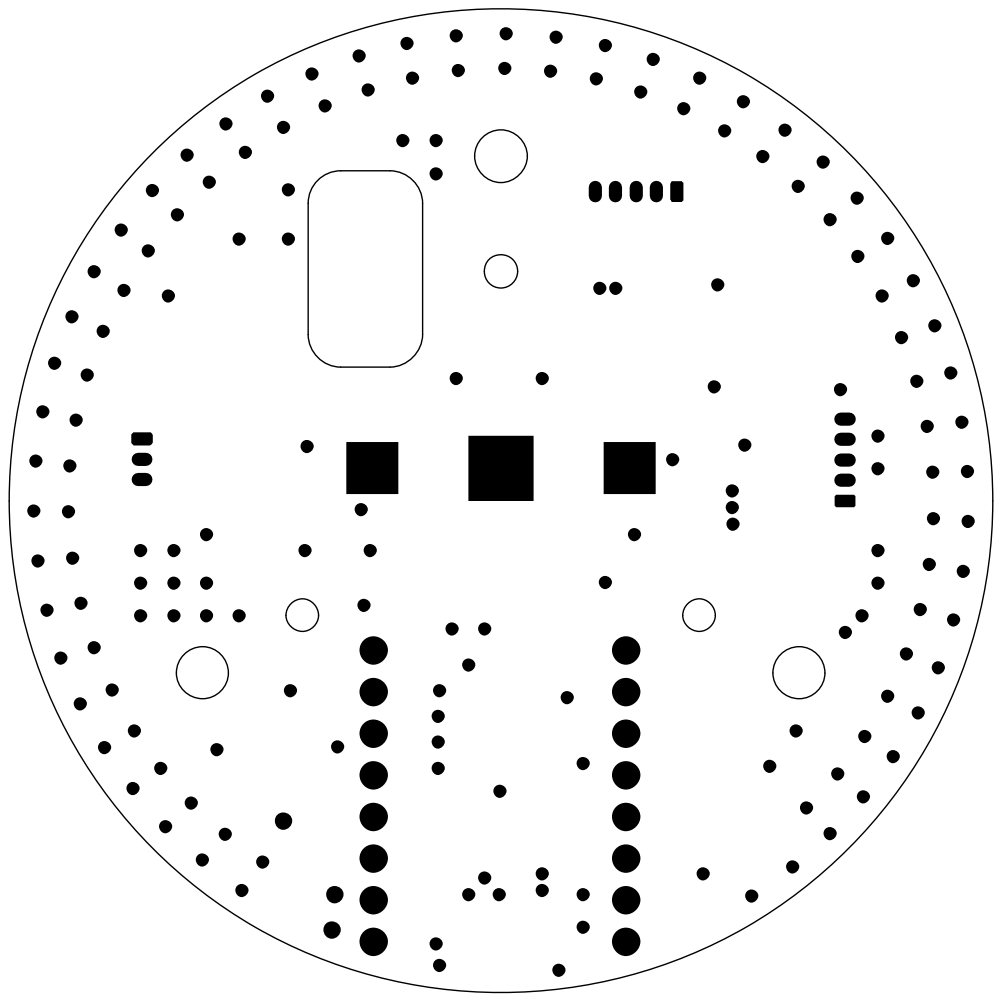
[picture p46: page 3]

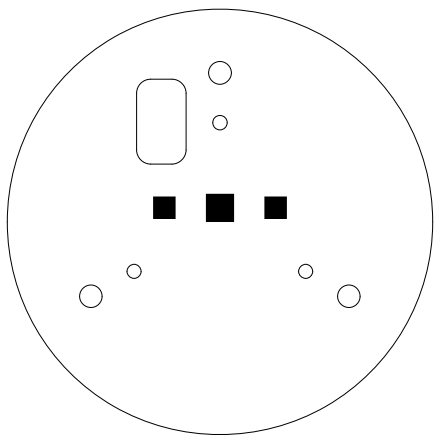
[picture p47: figure]

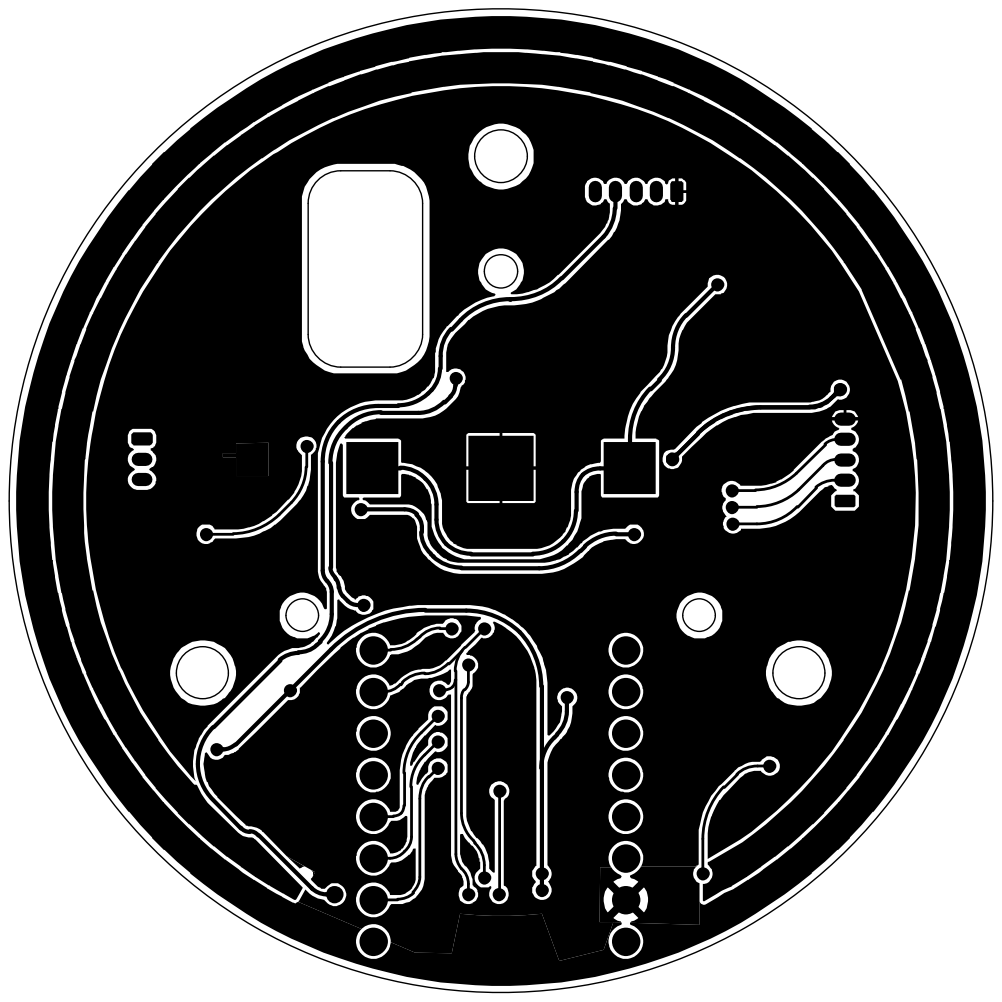
[picture p48: page 6]

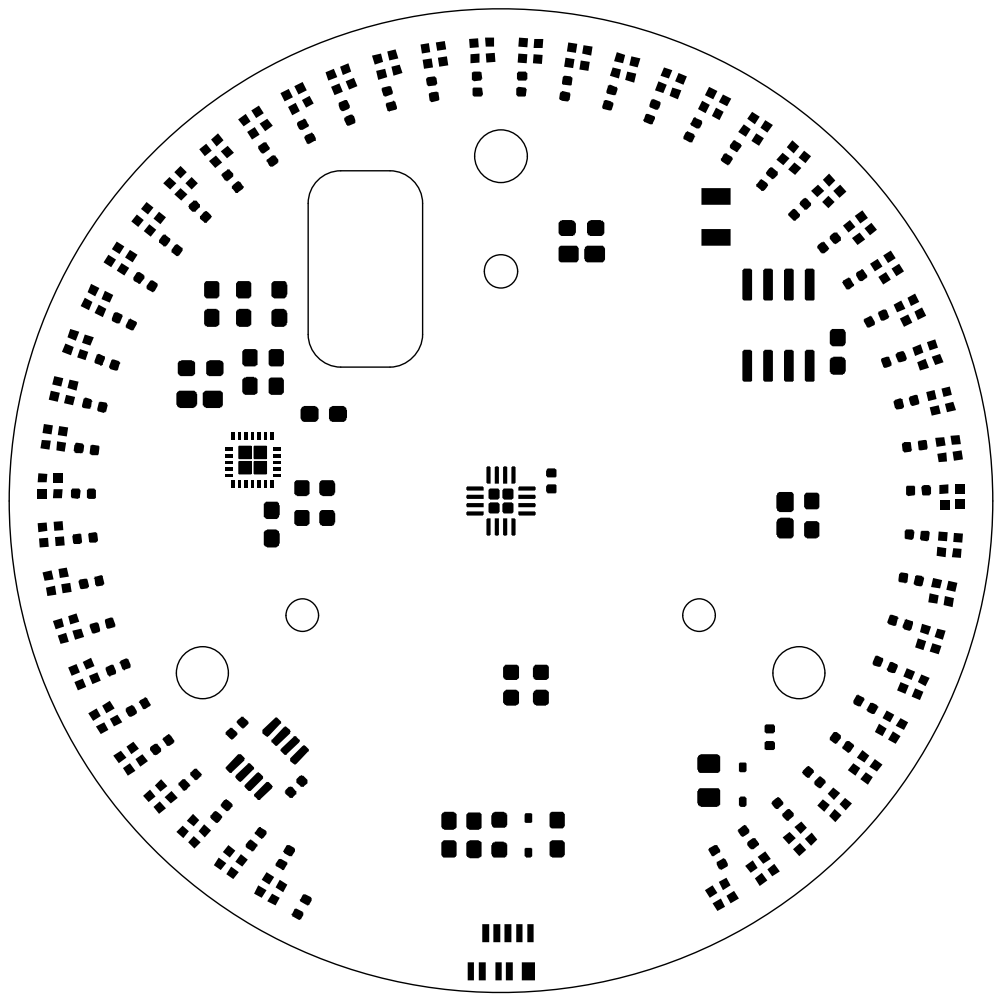
[picture p49: page 8]

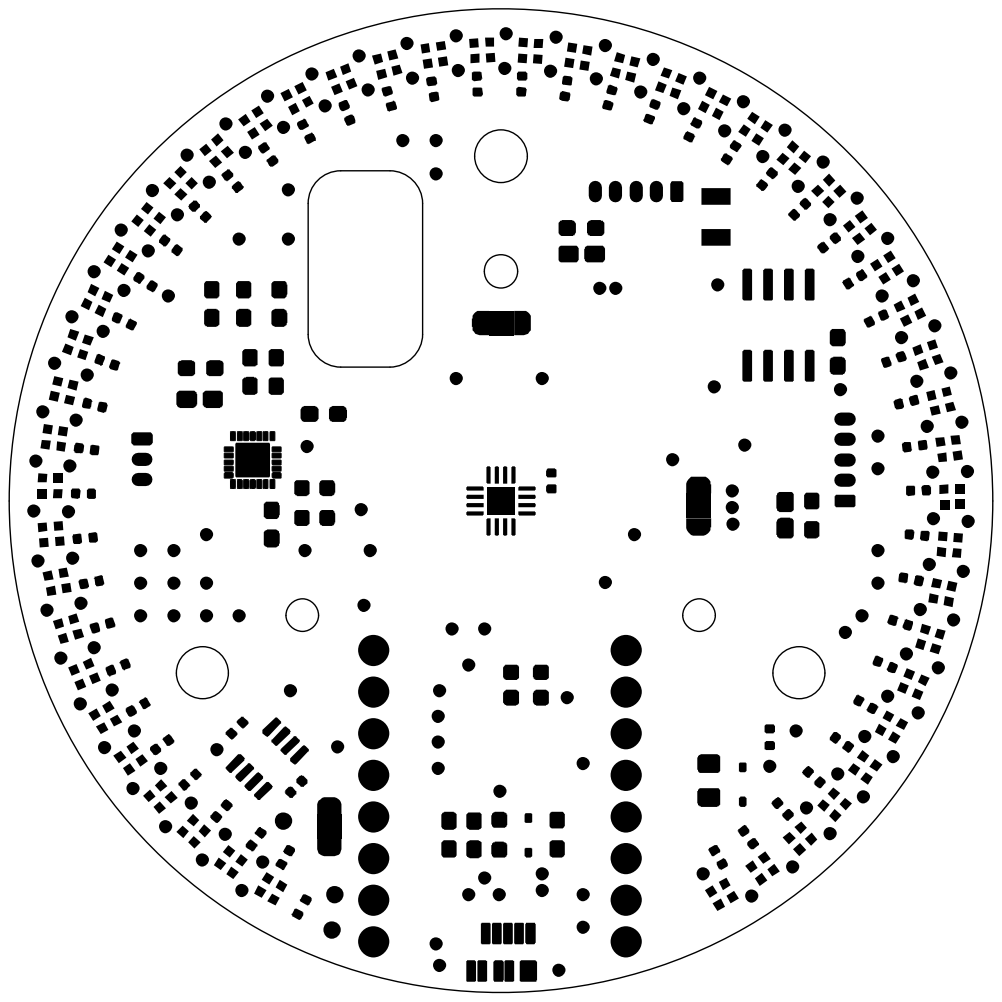
[picture p50: page 9]
