alperbasarn/QNOB/ScreenBase_V2/ScreenBase_V2.kicad_pcb

## KiCad design ScreenBase_V2/ScreenBase_V2.kicad_pcb (2026-02-01)

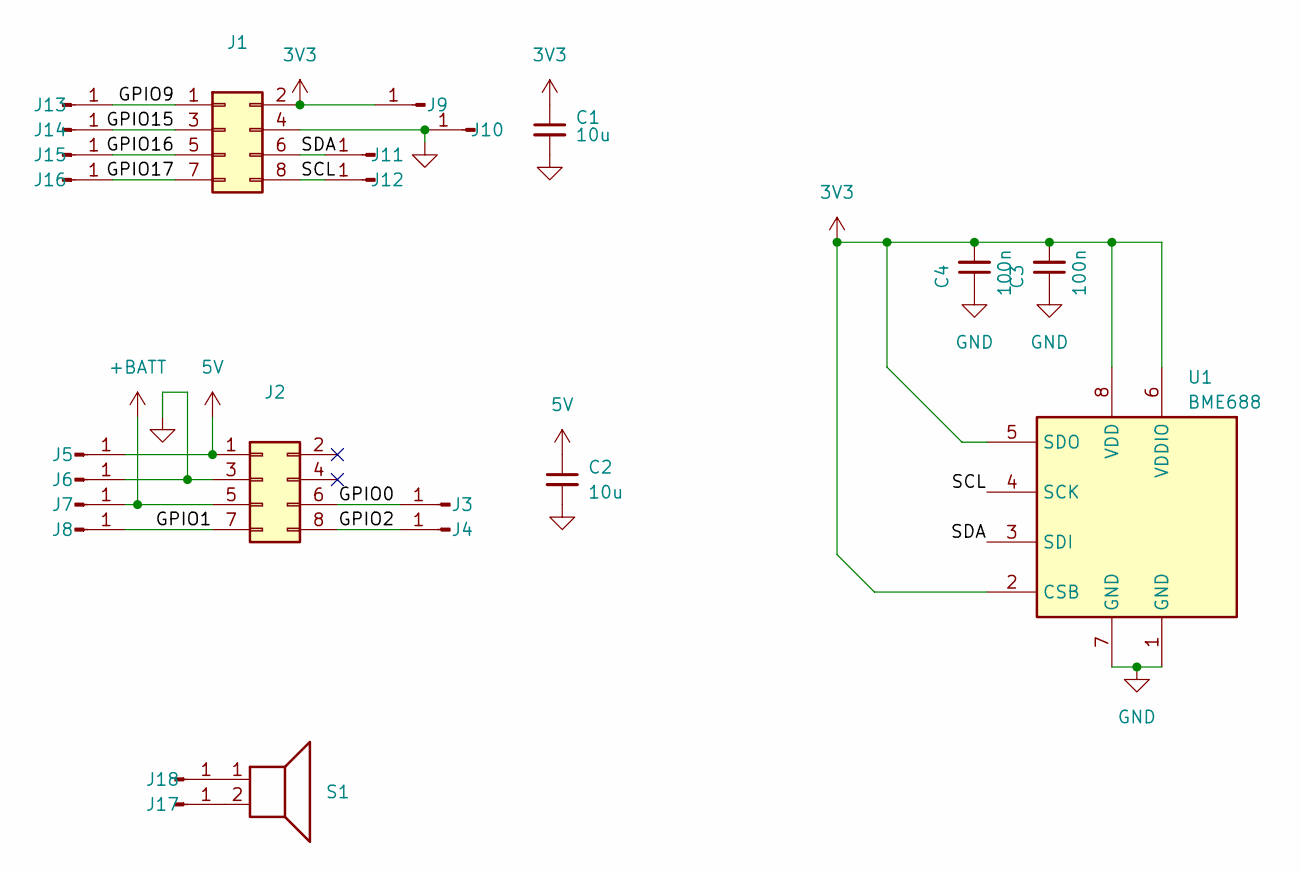
[picture p51: schematic ScreenBase_V2.kicad_sch, QNOB Touch Screen Adapter]

Parts:
C1, C2: 10u; C_0805_2012Metric_Pad1.18x1.45mm_HandSolder
C3, C4: 100n; C_0805_2012Metric_Pad1.18x1.45mm_HandSolder
J1, J2: Connector_PinHeader_2.54mm:PinHeader_2x04_P2.54mm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; PinHeader_2x04_P2.54mm_Vertical
J3, J4, J5, J6, J7, J8, J9, J10, J11, J12, J13, J14, J15, J16, J17, J18: Conn_01x01_Pin; SolderWirePad_1x01_SMD_1x2mm
S1: Speaker; speaker_custom
U1: BME688; Bosch_LGA-8_3x3mm_P0.8mm_ClockwisePinNumbering

Connections:
3V3: C1.1, C3.2, C4.2, J1.2, J9.1, U1.2 (CSB), U1.5 (SDO), U1.6 (VDDIO), U1.8 (VDD)
5V: C2.1, J2.1, J5.1
+BATT: J2.5, J7.1
/GPIO0: J2.6, J3.1
/GPIO1: J2.7, J8.1
/GPIO2: J2.8, J4.1
/GPIO9: J1.1, J13.1
/GPIO15: J1.3, J14.1
/GPIO16: J1.5, J15.1
/GPIO17: J1.7, J16.1
/SCL: J1.8, J12.1, U1.4 (SCK)
/SDA: J1.6, J11.1, U1.3 (SDI)
GND: C1.2, C2.2, C3.1, C4.1, J1.4, J2.3, J6.1, J10.1, U1.1 (GND), U1.7 (GND)
unnamed: J17.1, S1.2
unnamed: J18.1, S1.1

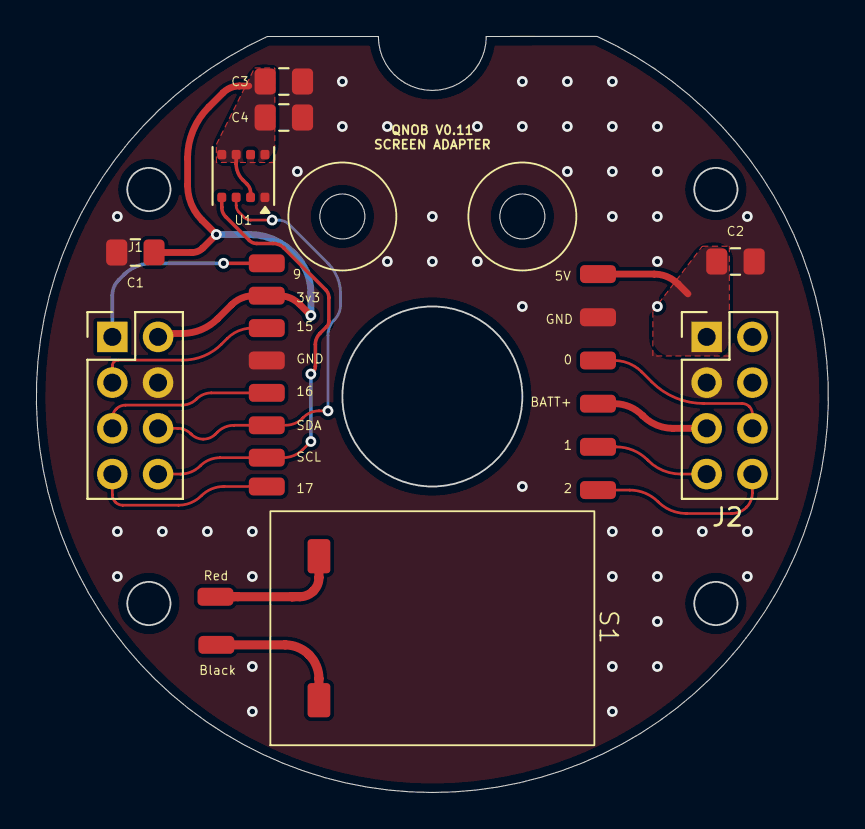
[picture p52: board ScreenBase_V2.kicad_pcb from above]

Board: 2 copper layers, 44.0 x 42.0 mm, 24 parts (0 on the bottom side), 15 nets.
