alperbasarn/QNOB/V11/V11.kicad_pcb

## KiCad design V11/V11.kicad_pcb (2026-02-01)

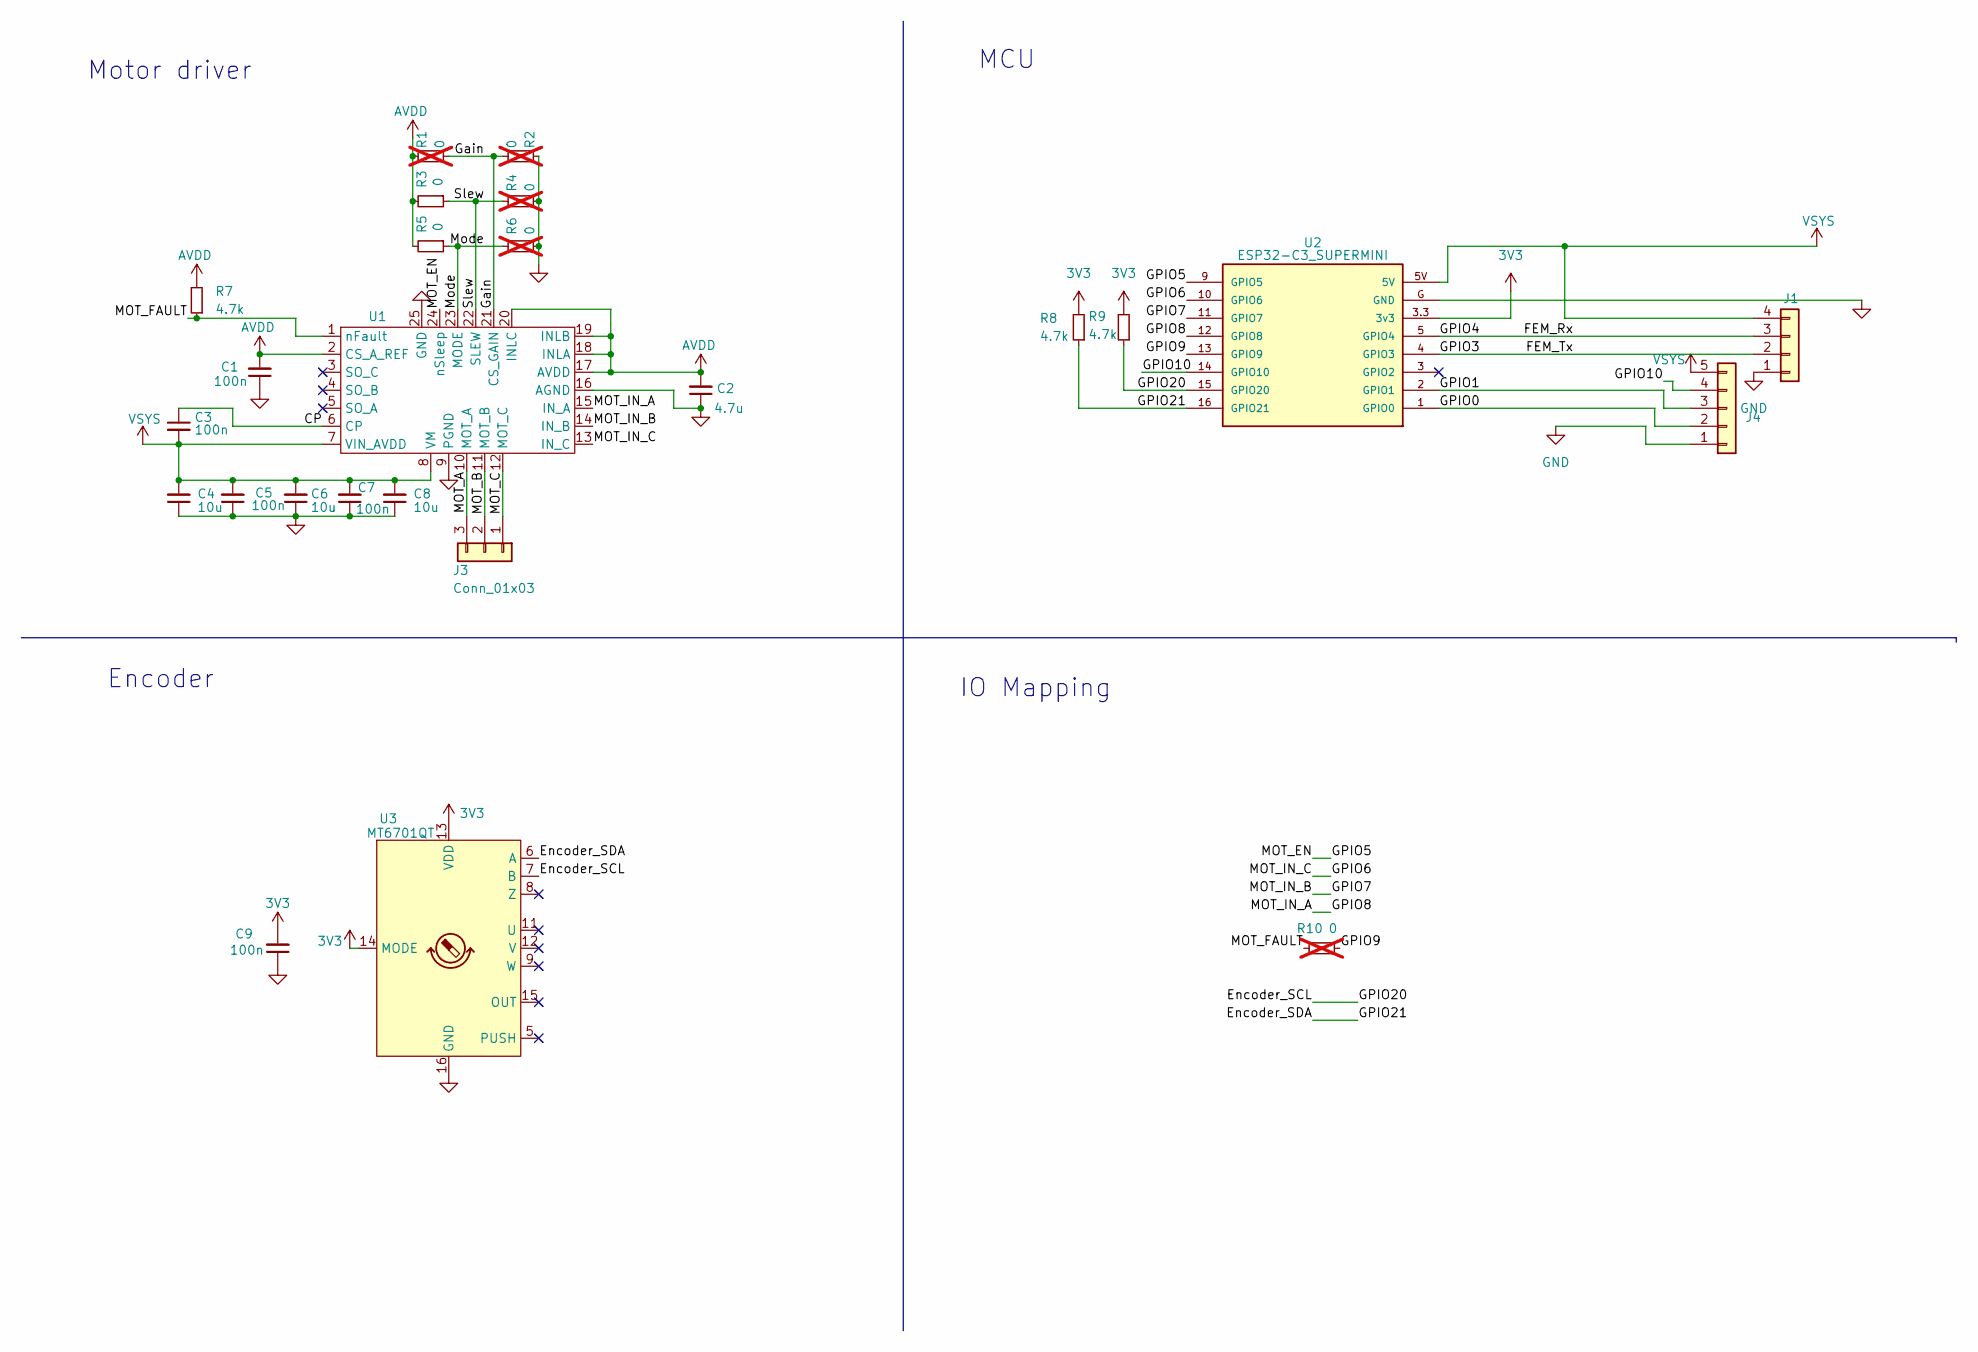
[picture p53: schematic V11.kicad_sch, QNOB]

Parts:
C1, C3, C5, C7, C9: 100n; C_0603_1608Metric_Pad1.08x0.95mm_HandSolder
C2: 4.7u; C_0603_1608Metric_Pad1.08x0.95mm_HandSolder
C4, C6, C8: 10u; C_0603_1608Metric_Pad1.08x0.95mm_HandSolder
J1: Conn_01x04; Molex_PicoBlade_53048-0410_1x04_P1.25mm_Horizontal
J3: Conn_01x03; Molex_PicoBlade_53048-0310_1x03_P1.25mm_Horizontal
J4: Conn_01x05; PinHeader_1x05_P2.54mm_Vertical
R1, R2, R4, R6, R10: 0; R_0603_1608Metric_Pad0.98x0.95mm_HandSolder; not fitted
R3, R5: 0; R_0603_1608Metric_Pad0.98x0.95mm_HandSolder
R7, R8, R9: 4.7k; R_0603_1608Metric_Pad0.98x0.95mm_HandSolder
U1: IC_DRV8311HRRWR
U2: ESP32-C3_SUPERMINI; MODULE_ESP32-C3_SUPERMINI
U3: MT6701QT; QFN-16-1EP_3x3mm_P0.5mm_EP1.7x1.7mm

Connections:
3V3: C9.2, R8.2, R9.2, U2.3.3 (3v3), U3.13 (VDD), U3.14 (MODE); also elsewhere on the board
/CP: C3.1, U1.6 (CP)
/CS_A: U1.5 (SO_A)
/CS_B: U1.4 (SO_B)
/CS_C: U1.3 (SO_C)
/Encoder_SCL: R9.1, U2.15 (GPIO20), U3.7 (B)
/Encoder_SDA: R8.1, U2.16 (GPIO21), U3.6 (A)
/FEM_Rx: J1.3, U2.5 (GPIO4)
/FEM_Tx: J1.2, U2.4 (GPIO3)
/GPIO0: J4.2, U2.1 (GPIO0)
/GPIO1: J4.3, U2.2 (GPIO1)
/GPIO5: U1.24 (nSleep), U2.9 (GPIO5)
/GPIO6: U1.13 (IN_C), U2.10 (GPIO6)
/GPIO7: U1.14 (IN_B), U2.11 (GPIO7)
/GPIO8: U1.15 (IN_A), U2.12 (GPIO8)
/GPIO9: R10.1, U2.13 (GPIO9)
/GPIO10: J4.4, U2.14 (GPIO10)
/Gain: R1.1, R2.1, U1.21 (CS_GAIN)
/MOT_A: J3.3, U1.10 (MOT_A)
/MOT_B: J3.2, U1.11 (MOT_B)
/MOT_C: J3.1, U1.12 (MOT_C)
/MOT_FAULT: R7.1, R10.2, U1.1 (nFault)
/Mode: R5.1, R6.2, U1.23 (MODE)
/Slew: R3.1, R4.2, U1.22 (SLEW)
AVDD: C1.2, C2.2, R1.2, R3.2, R5.2, R7.2, U1.2 (CS_A_REF), U1.17 (AVDD), U1.18 (INLA), U1.19 (INLB), U1.20 (INLC)
GND: C1.1, C2.1, C4.1, C5.1, C6.1, C7.1, C8.1, C9.1, J1.1, J4.1, R2.2, R4.1, R6.1, U1.9 (PGND), U1.16 (AGND), U1.25 (GND), U2.G (GND), U3.16 (GND), U3.17 (GND); also elsewhere on the board
VSYS: C3.2, C4.2, C5.2, C6.2, C7.2, C8.2, J1.4, J4.5, U1.7 (VIN_AVDD), U1.8 (VM), U2.5V; also elsewhere on the board

Notes on the sheet:
Encoder
Motor driver
IO Mapping
MCU

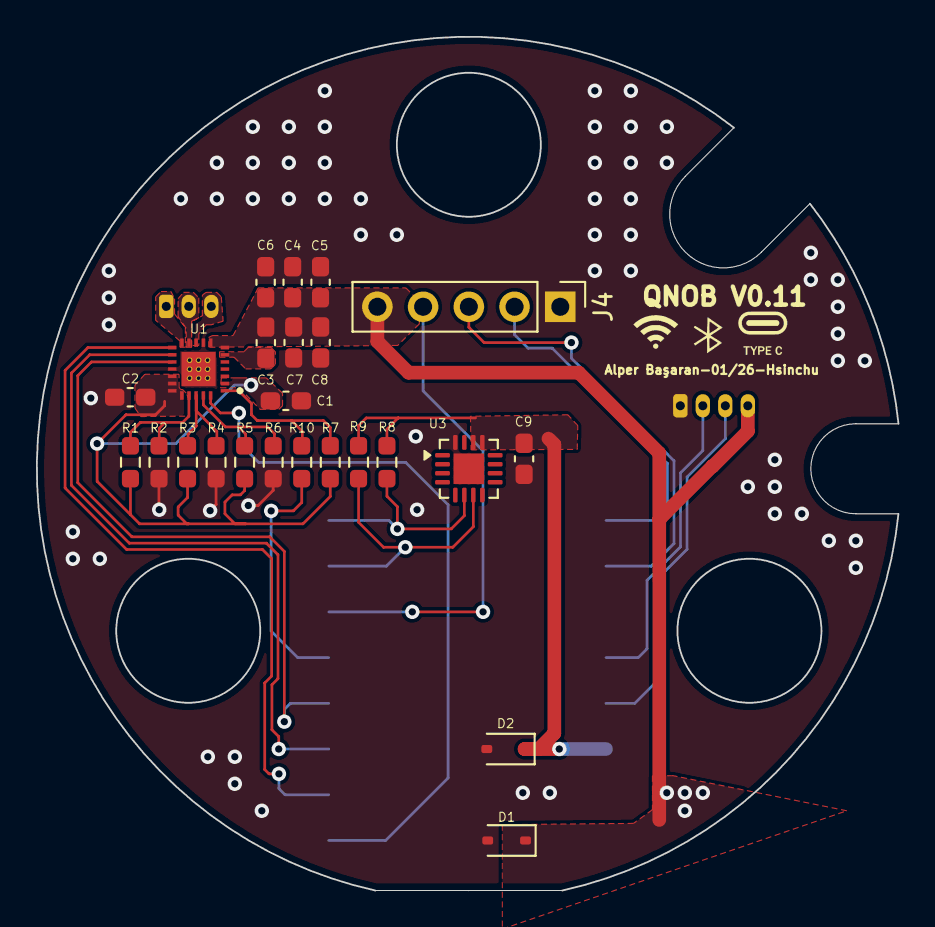
[picture p54: board V11.kicad_pcb from above]

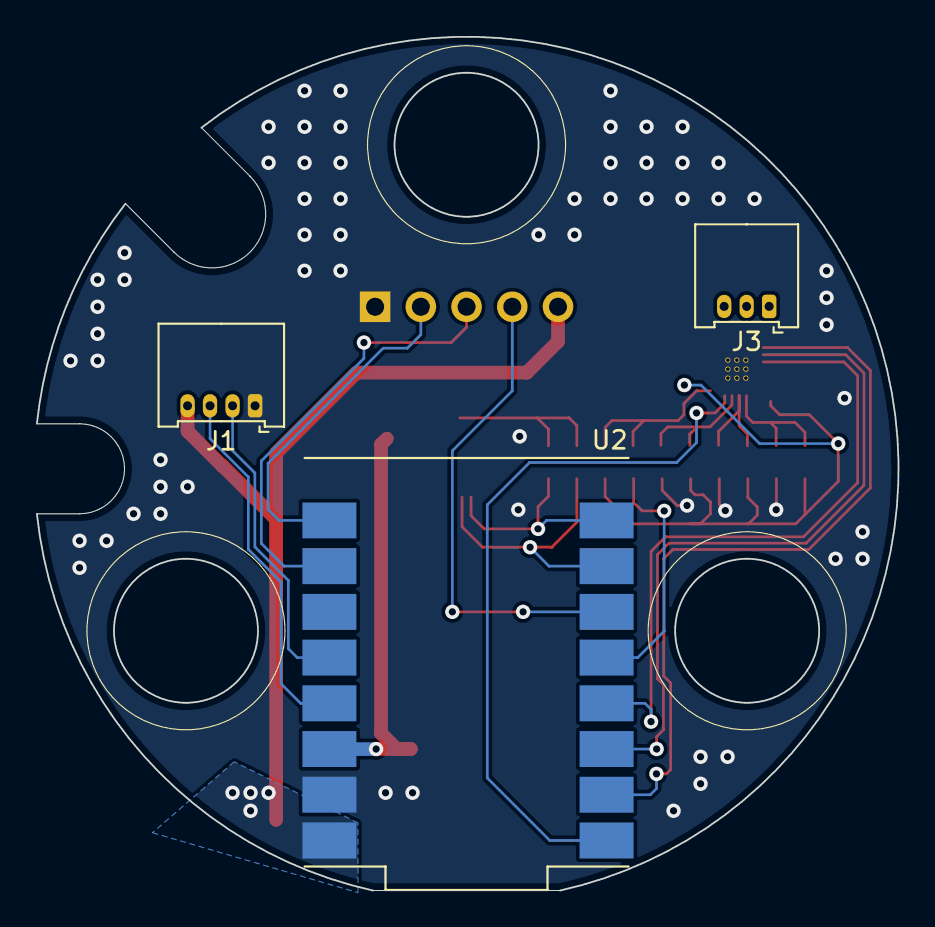
[picture p55: board V11.kicad_pcb from below]

Board: 2 copper layers, 47.9 x 47.4 mm, 27 parts (3 on the bottom side), 24 nets.

Other parts of the board:
D1, D2: ESD5Zxx; D_SOD-323

Their connections:
3V3: D2.1 (K); also elsewhere on the board
GND: D1.2 (A), D2.2 (A); also elsewhere on the board
VSYS: D1.1 (K); also elsewhere on the board
