alperbasarn/QNOB/MA732-breakout/MA732-Breakout/MA732-Breakout.kicad_pcb

## KiCad design MA732-breakout/MA732-Breakout/MA732-Breakout.kicad_pcb (2026-01-24)

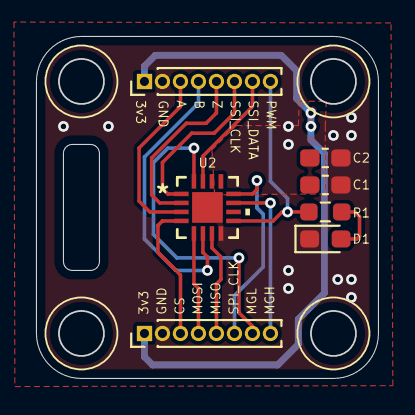
[picture p56: board MA732-Breakout.kicad_pcb from above]

Board: 2 copper layers, 19.0 x 19.0 mm, 7 parts (0 on the bottom side), 15 nets.

Parts:
C1: 10u; C_0603_1608Metric_Pad1.08x0.95mm_HandSolder
C2: 100n; C_0603_1608Metric_Pad1.08x0.95mm_HandSolder
D1: white; LED_0603_1608Metric_Pad1.05x0.95mm_HandSolder
J1, J2: Conn_01x08_Pin; PinHeader_1x08_P1.00mm_Vertical
R1: 1k; R_0603_1608Metric_Pad0.98x0.95mm_HandSolder
U2: MA732GQ-Z; QFN-16_MA732

Connections:
3v3: C1.2, C2.2, J1.1, J2.1, U2.13 (VDD)
/A: J2.5, U2.2 (A)
/B: J2.4, U2.6 (B)
/CS: J1.4, U2.5 (CS)
/MGH: J1.7, U2.16 (MGH)
/MGL: J1.8, U2.11 (MGL)
/MISO: J1.5, U2.7 (MISO)
/MOSI: J1.3, U2.4 (MOSI)
/PWM: J2.8, R1.1, U2.9 (PWM)
/SPI_CLK: J1.6, U2.12 (SCLK)
/SSI_CLK: J2.7, U2.15 (SSCK)
/SSI_Data: J2.6, U2.1 (SSD)
/Z: J2.3, U2.3 (Z)
GND: C1.1, C2.1, D1.1 (K), J1.2, J2.2, U2.8 (GND), U2.17 (PAD)
unnamed: D1.2 (A), R1.2
