alperbasarn/QNOB/DRV8313-breakout/V1/DRV8313-breakout/DRV8313-breakout.kicad_pcb

## KiCad design DRV8313-breakout/V1/DRV8313-breakout/DRV8313-breakout.kicad_pcb (2026-01-24)

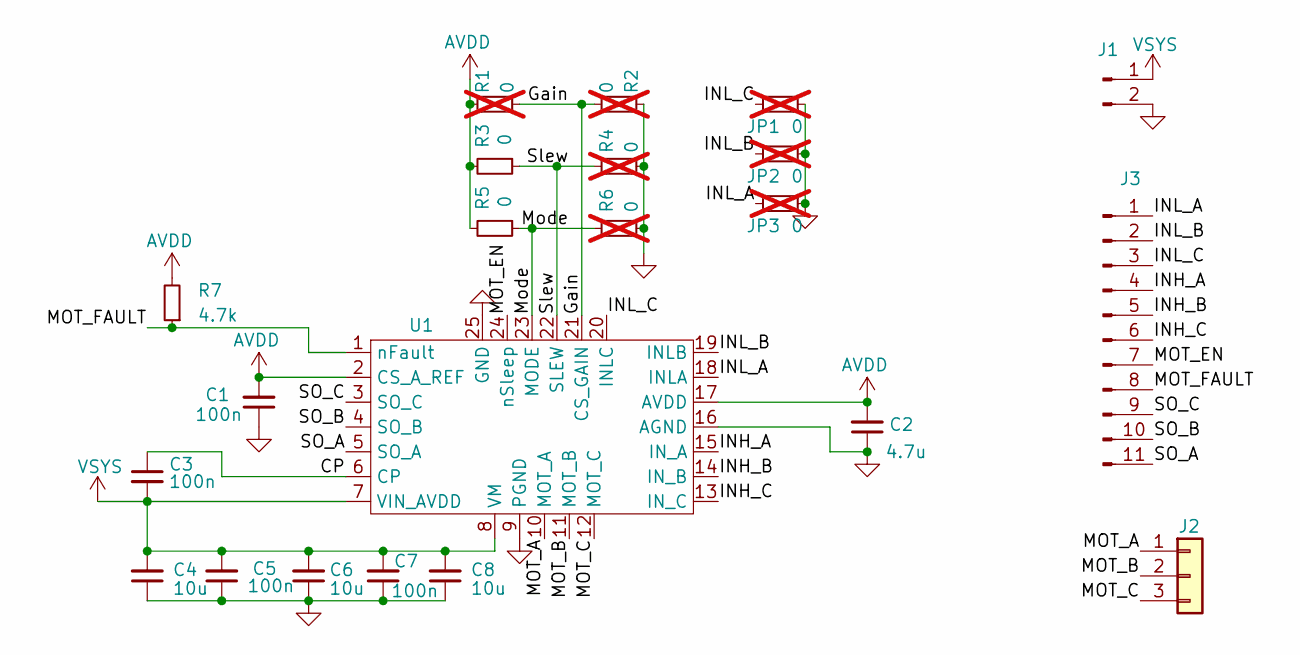
[picture p57: schematic DRV8313-breakout.kicad_sch, DRV8313 Breakout]

Parts:
C1, C3, C5, C7: 100n; C_0603_1608Metric_Pad1.08x0.95mm_HandSolder
C2: 4.7u; C_0603_1608Metric_Pad1.08x0.95mm_HandSolder
C4, C6, C8: 10u; C_0603_1608Metric_Pad1.08x0.95mm_HandSolder
J1: Conn_01x02_Pin; Molex_PicoBlade_53048-0210_1x02_P1.25mm_Horizontal
J2: Conn_01x03; Molex_PicoBlade_53048-0310_1x03_P1.25mm_Horizontal
J3: Conn_01x11_Pin; Molex_PicoBlade_53048-1110_1x11_P1.25mm_Horizontal
JP1, JP2, JP3: 0; R_0603_1608Metric_Pad0.98x0.95mm_HandSolder; not fitted
R1, R2, R4, R6: 0; R_0603_1608Metric_Pad0.98x0.95mm_HandSolder; not fitted
R3, R5: 0; R_0603_1608Metric_Pad0.98x0.95mm_HandSolder
R7: 4.7k; R_0603_1608Metric_Pad0.98x0.95mm_HandSolder
U1: IC_DRV8311HRRWR

Connections:
/CP: C3.1, U1.6 (CP)
/Gain: R1.1, R2.1, U1.21 (CS_GAIN)
/INH_A: J3.4, U1.15 (IN_A)
/INH_B: J3.5, U1.14 (IN_B)
/INH_C: J3.6, U1.13 (IN_C)
/INL_A: J3.1, JP3.1, U1.18 (INLA)
/INL_B: J3.2, JP2.1, U1.19 (INLB)
/INL_C: J3.3, JP1.1, U1.20 (INLC)
/MOT_A: J2.1, U1.10 (MOT_A)
/MOT_B: J2.2, U1.11 (MOT_B)
/MOT_C: J2.3, U1.12 (MOT_C)
/MOT_EN: J3.7, U1.24 (nSleep)
/MOT_FAULT: J3.8, R7.1, U1.1 (nFault)
/Mode: R5.1, R6.2, U1.23 (MODE)
/SO_A: J3.11, U1.5 (SO_A)
/SO_B: J3.10, U1.4 (SO_B)
/SO_C: J3.9, U1.3 (SO_C)
/Slew: R3.1, R4.2, U1.22 (SLEW)
AVDD: C1.2, C2.2, R1.2, R3.2, R5.2, R7.2, U1.2 (CS_A_REF), U1.17 (AVDD)
GND: C1.1, C2.1, C4.1, C5.1, C6.1, C7.1, C8.1, J1.2, JP1.2, JP2.2, JP3.2, R2.2, R4.1, R6.1, U1.9 (PGND), U1.16 (AGND), U1.25 (GND)
VSYS: C3.2, C4.2, C5.2, C6.2, C7.2, C8.2, J1.1, U1.7 (VIN_AVDD), U1.8 (VM)

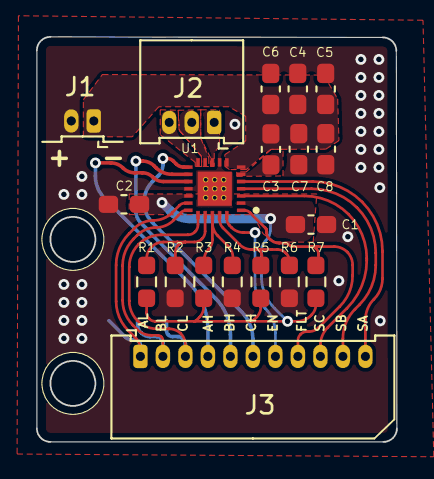
[picture p58: board DRV8313-breakout.kicad_pcb from above]

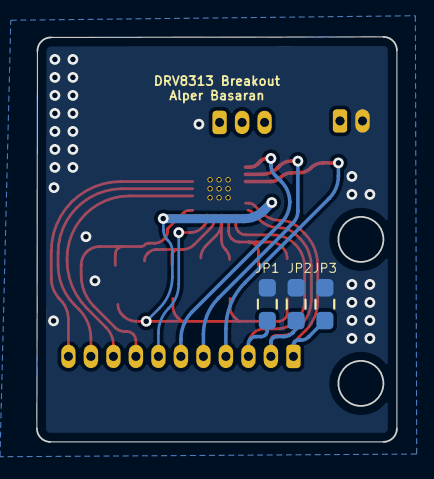
[picture p59: board DRV8313-breakout.kicad_pcb from below]

Board: 2 copper layers, 20.0 x 22.5 mm, 22 parts (3 on the bottom side), 21 nets.
