alperbasarn/QNOB/PCB/V6/QNOB_V6/QNOB_V6/QNOB_V6.kicad_pcb

## KiCad design PCB/V6/QNOB_V6/QNOB_V6/QNOB_V6.kicad_pcb (2025-05-13)

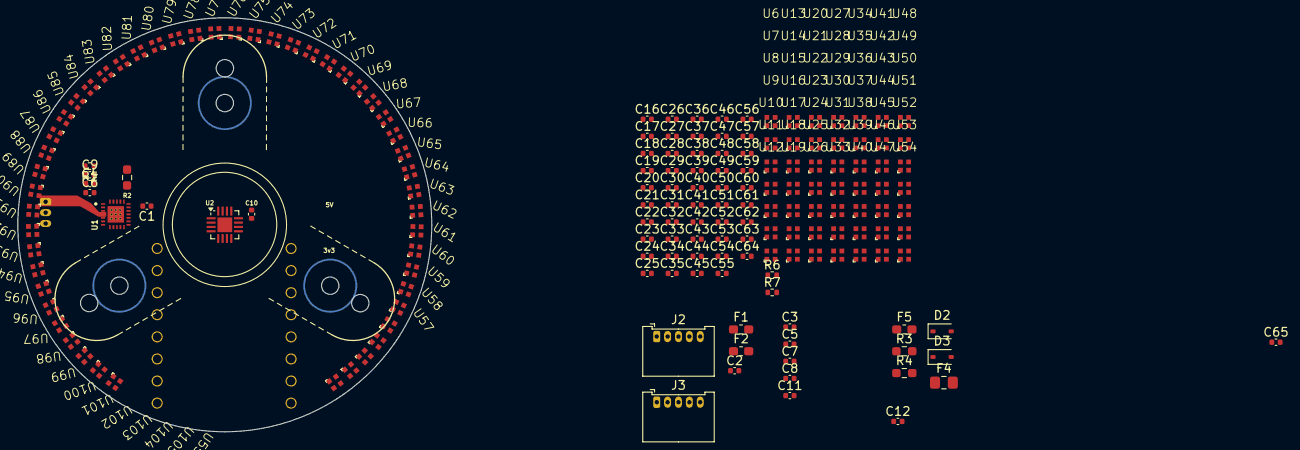
[picture p60: board QNOB_V6.kicad_pcb from above]

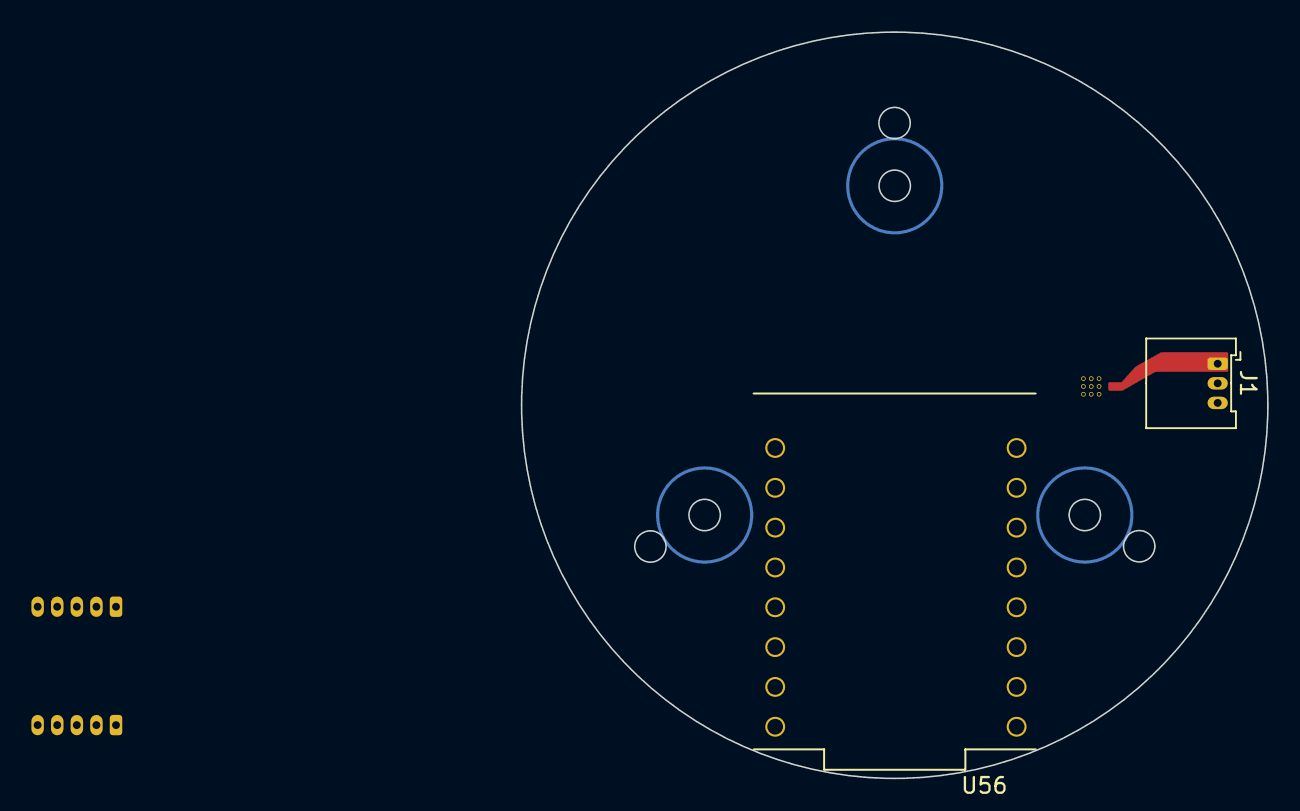
[picture p61: board QNOB_V6.kicad_pcb from below]

Board: 2 copper layers, 47.6 x 47.6 mm, 179 parts (2 on the bottom side), 70 nets, no tracks yet.

Parts:
C1, C2, C4, C5, C6, C7: 10u; C_0402_1005Metric
C3, C8, C9, C10, C12: 100n; C_0402_1005Metric
C11: 4.7u; C_0402_1005Metric
C16, C17, C18, C19, C20, C21, C22, C23, C24, C25, C26, C27, C28, C29, C30, C31, C32, C33, C34, C35, C36, C37, C38, C39, C40, C41, C42, C43, C44, C45, C46, C47, C48, C49, C50, C51, C52, C53, C54, C55, C56, C57, C58, C59, C60, C61, C62, C63, C64, C65: 100n 10V; C_0402_1005Metric
D2, D3: ESD5Zxx; D_SOD-323
F1, F2, F5: 500m; Fuse_0603_1608Metric_Pad1.05x0.95mm_HandSolder
F4: 1A; Fuse_0805_2012Metric_Pad1.15x1.40mm_HandSolder
J1: Conn_01x03; Molex_PicoBlade_53048-0310_1x03_P1.25mm_Horizontal
J2, J3: Conn_01x05; Molex_PicoBlade_53048-0510_1x05_P1.25mm_Horizontal
R1: 4.7k; R_0402_1005Metric
R2: 0; R_0603_1608Metric_Pad0.98x0.95mm_HandSolder
R3, R4: 4.7k; R_0603_1608Metric_Pad0.98x0.95mm_HandSolder
R6, R7: 500; R_0402_1005Metric
U1: IC_DRV8311HRRWR
U2: MT6701QT; QFN-16-1EP_3x3mm_P0.5mm_EP1.7x1.7mm
U6, U7, U8, U9, U10, U11, U12, U13, U14, U15, U16, U17, U18, U19, U20, U21, U22, U23, U24, U25, U26, U27, U28, U29, U30, U31, U32, U33, U34, U35, U36, U37, U38, U39, U40, U41, U42, U43, U44, U45, U46, U47, U48, U49, U50, U51, U52, U53, U54, U55, U57, U58, U59, U60, U61, U62, U63, U64, U65, U66, U67, U68, U69, U70, U71, U72, U73, U74, U75, U76, U77, U78, U79, U80, U81, U82, U83, U84, U85, U86, U87, U88, U89, U90, U91, U92, U93, U94, U95, U96, U97, U98, U99, U100, U101, U102, U103, U104, U105: SK6805-EC15
U56: ESP32-C3_SUPERMINI; MODULE_ESP32-C3_SUPERMINI

Connections:
3.3V: F5.1, U56.3.3 (3V3)
3.3V_Protected: C12.2, D3.1 (K), F5.2, R3.2, R4.2, U2.13 (VDD), U2.14 (MODE)
5V: C1.2, C2.2, F1.1, F2.1, F4.1, U56.5V
5V_Protected: C4.2, C5.2, C6.1, C7.2, C8.1, C9.2, C10.2, C16.2, C17.2, C18.2, C19.2, C20.2, C21.2, C22.2, C23.2, C24.2, C25.2, C26.2, C27.2, C28.2, C29.2, C30.2, C31.2, C32.2, C33.2, C34.2, C35.2, C36.2, C37.2, C38.2, C39.2, C40.2, C41.2, C42.2, C43.2, C44.2, C45.2, C46.2, C47.2, C48.2, C49.2, C50.2, C51.2, C52.2, C53.2, C54.2, C55.2, C56.2, C57.2, C58.2, C59.2, C60.2, C61.2, C62.2, C63.2, C64.2, C65.2, D2.1 (K), F4.2, U1.7 (VIN_AVDD), U1.8 (VM), U6.2 (Vin), U7.2 (Vin), U8.2 (Vin), U9.2 (Vin), U10.2 (Vin), U11.2 (Vin), U12.2 (Vin), U13.2 (Vin), U14.2 (Vin), U15.2 (Vin), U16.2 (Vin), U17.2 (Vin), U18.2 (Vin), U19.2 (Vin), U20.2 (Vin), U21.2 (Vin), U22.2 (Vin), U23.2 (Vin), U24.2 (Vin), U25.2 (Vin), U26.2 (Vin), U27.2 (Vin), U28.2 (Vin), U29.2 (Vin), U30.2 (Vin), U31.2 (Vin), U32.2 (Vin), U33.2 (Vin), U34.2 (Vin), U35.2 (Vin), U36.2 (Vin), U37.2 (Vin), U38.2 (Vin), U39.2 (Vin), U40.2 (Vin), U41.2 (Vin), U42.2 (Vin), U43.2 (Vin), U44.2 (Vin), U45.2 (Vin), U46.2 (Vin), U47.2 (Vin), U48.2 (Vin), U49.2 (Vin), U50.2 (Vin), U51.2 (Vin), U52.2 (Vin), U53.2 (Vin), U54.2 (Vin), U55.2 (Vin), U57.2 (Vin), U58.2 (Vin), U59.2 (Vin), U60.2 (Vin), U61.2 (Vin), U62.2 (Vin), U63.2 (Vin), U64.2 (Vin), U65.2 (Vin), U66.2 (Vin), U67.2 (Vin), U68.2 (Vin), U69.2 (Vin), U70.2 (Vin), U71.2 (Vin), U72.2 (Vin), U73.2 (Vin), U74.2 (Vin), U75.2 (Vin), U76.2 (Vin), U77.2 (Vin), U78.2 (Vin), U79.2 (Vin), U80.2 (Vin), U81.2 (Vin), U82.2 (Vin), U83.2 (Vin), U84.2 (Vin), U85.2 (Vin), U86.2 (Vin), U87.2 (Vin), U88.2 (Vin), U89.2 (Vin), U90.2 (Vin), U91.2 (Vin), U92.2 (Vin), U93.2 (Vin), U94.2 (Vin), U95.2 (Vin), U96.2 (Vin), U97.2 (Vin), U98.2 (Vin), U99.2 (Vin), U100.2 (Vin), U101.2 (Vin), U102.2 (Vin), U103.2 (Vin), U104.2 (Vin), U105.2 (Vin)
/GPIO3: J3.3, U56.4 (GPIO4)
/GPIO4: J3.2, U56.3 (GPIO3)
/GPIO5: U1.24 (nSleep), U56.5 (GPIO5)
/GPIO20: J2.4, R3.1, U2.7 (B)
/GPIO21: J2.3, R4.1, U2.6 (A)
/Motor drive/CP: C6.2, C8.2, U1.6 (CP)
/Motor drive/MOT_A: J1.1, U1.10 (MOT_A)
/Motor drive/MOT_B: J1.2, U1.11 (MOT_B)
/Motor drive/MOT_C: J1.3, U1.12 (MOT_C)
GND: C1.1, C2.1, C3.1, C4.1, C5.1, C7.1, C9.1, C10.1, C11.1, C12.1, C16.1, C17.1, C18.1, C19.1, C20.1, C21.1, C22.1, C23.1, C24.1, C25.1, C26.1, C27.1, C28.1, C29.1, C30.1, C31.1, C32.1, C33.1, C34.1, C35.1, C36.1, C37.1, C38.1, C39.1, C40.1, C41.1, C42.1, C43.1, C44.1, C45.1, C46.1, C47.1, C48.1, C49.1, C50.1, C51.1, C52.1, C53.1, C54.1, C55.1, C56.1, C57.1, C58.1, C59.1, C60.1, C61.1, C62.1, C63.1, C64.1, C65.1, D2.2 (A), D3.2 (A), J2.5, J3.1, U1.9 (PGND), U1.16 (AGND), U1.25 (GND), U2.16 (GND), U2.17 (GND), U6.4 (GND), U7.4 (GND), U8.4 (GND), U9.4 (GND), U10.4 (GND), U11.4 (GND), U12.4 (GND), U13.4 (GND), U14.4 (GND), U15.4 (GND), U16.4 (GND), U17.4 (GND), U18.4 (GND), U19.4 (GND), U20.4 (GND), U21.4 (GND), U22.4 (GND), U23.4 (GND), U24.4 (GND), U25.4 (GND), U26.4 (GND), U27.4 (GND), U28.4 (GND), U29.4 (GND), U30.4 (GND), U31.4 (GND), U32.4 (GND), U33.4 (GND), U34.4 (GND), U35.4 (GND), U36.4 (GND), U37.4 (GND), U38.4 (GND), U39.4 (GND), U40.4 (GND), U41.4 (GND), U42.4 (GND), U43.4 (GND), U44.4 (GND), U45.4 (GND), U46.4 (GND), U47.4 (GND), U48.4 (GND), U49.4 (GND), U50.4 (GND), U51.4 (GND), U52.4 (GND), U53.4 (GND), U54.4 (GND), U55.4 (GND), U56.G (GND), U57.4 (GND), U58.4 (GND), U59.4 (GND), U60.4 (GND), U61.4 (GND), U62.4 (GND), U63.4 (GND), U64.4 (GND), U65.4 (GND), U66.4 (GND), U67.4 (GND), U68.4 (GND), U69.4 (GND), U70.4 (GND), U71.4 (GND), U72.4 (GND), U73.4 (GND), U74.4 (GND), U75.4 (GND), U76.4 (GND), U77.4 (GND), U78.4 (GND), U79.4 (GND), U80.4 (GND), U81.4 (GND), U82.4 (GND), U83.4 (GND), U84.4 (GND), U85.4 (GND), U86.4 (GND), U87.4 (GND), U88.4 (GND), U89.4 (GND), U90.4 (GND), U91.4 (GND), U92.4 (GND), U93.4 (GND), U94.4 (GND), U95.4 (GND), U96.4 (GND), U97.4 (GND), U98.4 (GND), U99.4 (GND), U100.4 (GND), U101.4 (GND), U102.4 (GND), U103.4 (GND), U104.4 (GND), U105.4 (GND)
unnamed: F1.2, J2.1
unnamed: F2.2, J3.5
unnamed: C3.2, C11.2, R1.2, R2.2, U1.2 (CS_A_REF), U1.17 (AVDD), U1.18 (INLA), U1.19 (INLB), U1.20 (INLC), U1.22 (SLEW), U1.23 (MODE)
unnamed: R2.1, U1.21 (CS_GAIN)
unnamed: R1.1, U1.1 (nFault)
unnamed: R6.1, U10.1 (DIn)
unnamed: U10.3 (Dout), U15.1 (DIn)
unnamed: U6.3 (Dout), U11.1 (DIn)
unnamed: U11.3 (Dout), U16.1 (DIn)
unnamed: U7.3 (Dout), U12.1 (DIn)
unnamed: U12.3 (Dout), U17.1 (DIn)
unnamed: U8.3 (Dout), U13.1 (DIn)
unnamed: U13.3 (Dout), U18.1 (DIn)
unnamed: U9.3 (Dout), U14.1 (DIn)
unnamed: U14.3 (Dout), U19.1 (DIn)
unnamed: U15.3 (Dout), U20.1 (DIn)
unnamed: U16.3 (Dout), U21.1 (DIn)
unnamed: U17.3 (Dout), U22.1 (DIn)
unnamed: U18.3 (Dout), U23.1 (DIn)
unnamed: U19.3 (Dout), U24.1 (DIn)
unnamed: U20.3 (Dout), U25.1 (DIn)
unnamed: U21.3 (Dout), U26.1 (DIn)
unnamed: U22.3 (Dout), U27.1 (DIn)
unnamed: U23.3 (Dout), U28.1 (DIn)
unnamed: U24.3 (Dout), U29.1 (DIn)
unnamed: U25.3 (Dout), U30.1 (DIn)
unnamed: U26.3 (Dout), U31.1 (DIn)
unnamed: U27.3 (Dout), U32.1 (DIn)
unnamed: U28.3 (Dout), U33.1 (DIn)
unnamed: U29.3 (Dout), U34.1 (DIn)
unnamed: U30.3 (Dout), U35.1 (DIn)
unnamed: U31.3 (Dout), U36.1 (DIn)
unnamed: U32.3 (Dout), U37.1 (DIn)
unnamed: U33.3 (Dout), U38.1 (DIn)
unnamed: U34.3 (Dout), U39.1 (DIn)
unnamed: U35.3 (Dout), U40.1 (DIn)
unnamed: U36.3 (Dout), U41.1 (DIn)
unnamed: U37.3 (Dout), U42.1 (DIn)
unnamed: U38.3 (Dout), U43.1 (DIn)
unnamed: U39.3 (Dout), U44.1 (DIn)
unnamed: U40.3 (Dout), U45.1 (DIn)
unnamed: U41.3 (Dout), U46.1 (DIn)
unnamed: U42.3 (Dout), U47.1 (DIn)
unnamed: U43.3 (Dout), U48.1 (DIn)
unnamed: U44.3 (Dout), U49.1 (DIn)
unnamed: U45.3 (Dout), U50.1 (DIn)
unnamed: U46.3 (Dout), U51.1 (DIn)
unnamed: U47.3 (Dout), U52.1 (DIn)
unnamed: U48.3 (Dout), U53.1 (DIn)
unnamed: U49.3 (Dout), U54.1 (DIn)
unnamed: U50.3 (Dout), U55.1 (DIn), U57.1 (DIn), U58.1 (DIn), U59.1 (DIn), U60.1 (DIn), U61.1 (DIn), U62.1 (DIn), U63.1 (DIn), U64.1 (DIn), U65.1 (DIn), U66.1 (DIn), U67.1 (DIn), U68.1 (DIn), U69.1 (DIn), U70.1 (DIn), U71.1 (DIn), U72.1 (DIn), U73.1 (DIn), U74.1 (DIn), U75.1 (DIn), U76.1 (DIn), U77.1 (DIn), U78.1 (DIn), U79.1 (DIn), U80.1 (DIn), U81.1 (DIn), U82.1 (DIn), U83.1 (DIn), U84.1 (DIn), U85.1 (DIn), U86.1 (DIn), U87.1 (DIn), U88.1 (DIn), U89.1 (DIn), U90.1 (DIn), U91.1 (DIn), U92.1 (DIn), U93.1 (DIn), U94.1 (DIn), U95.1 (DIn), U96.1 (DIn), U97.1 (DIn), U98.1 (DIn), U99.1 (DIn), U100.1 (DIn), U101.1 (DIn), U102.1 (DIn), U103.1 (DIn), U104.1 (DIn), U105.1 (DIn)
unnamed: R7.2, U51.3 (Dout)
unnamed: U6.1 (DIn), U52.3 (Dout)
unnamed: U7.1 (DIn), U53.3 (Dout)
unnamed: U8.1 (DIn), U54.3 (Dout)
unnamed: U9.1 (DIn), U55.3 (Dout), U57.3 (Dout), U58.3 (Dout), U59.3 (Dout), U60.3 (Dout), U61.3 (Dout), U62.3 (Dout), U63.3 (Dout), U64.3 (Dout), U65.3 (Dout), U66.3 (Dout), U67.3 (Dout), U68.3 (Dout), U69.3 (Dout), U70.3 (Dout), U71.3 (Dout), U72.3 (Dout), U73.3 (Dout), U74.3 (Dout), U75.3 (Dout), U76.3 (Dout), U77.3 (Dout), U78.3 (Dout), U79.3 (Dout), U80.3 (Dout), U81.3 (Dout), U82.3 (Dout), U83.3 (Dout), U84.3 (Dout), U85.3 (Dout), U86.3 (Dout), U87.3 (Dout), U88.3 (Dout), U89.3 (Dout), U90.3 (Dout), U91.3 (Dout), U92.3 (Dout), U93.3 (Dout), U94.3 (Dout), U95.3 (Dout), U96.3 (Dout), U97.3 (Dout), U98.3 (Dout), U99.3 (Dout), U100.3 (Dout), U101.3 (Dout), U102.3 (Dout), U103.3 (Dout), U104.3 (Dout), U105.3 (Dout)
