alperbasarn/QNOB/PCB/V3/QNOB_V5/QNOB_V5.kicad_pcb

## KiCad design PCB/V3/QNOB_V5/QNOB_V5.kicad_pcb (2025-05-01, an earlier design)

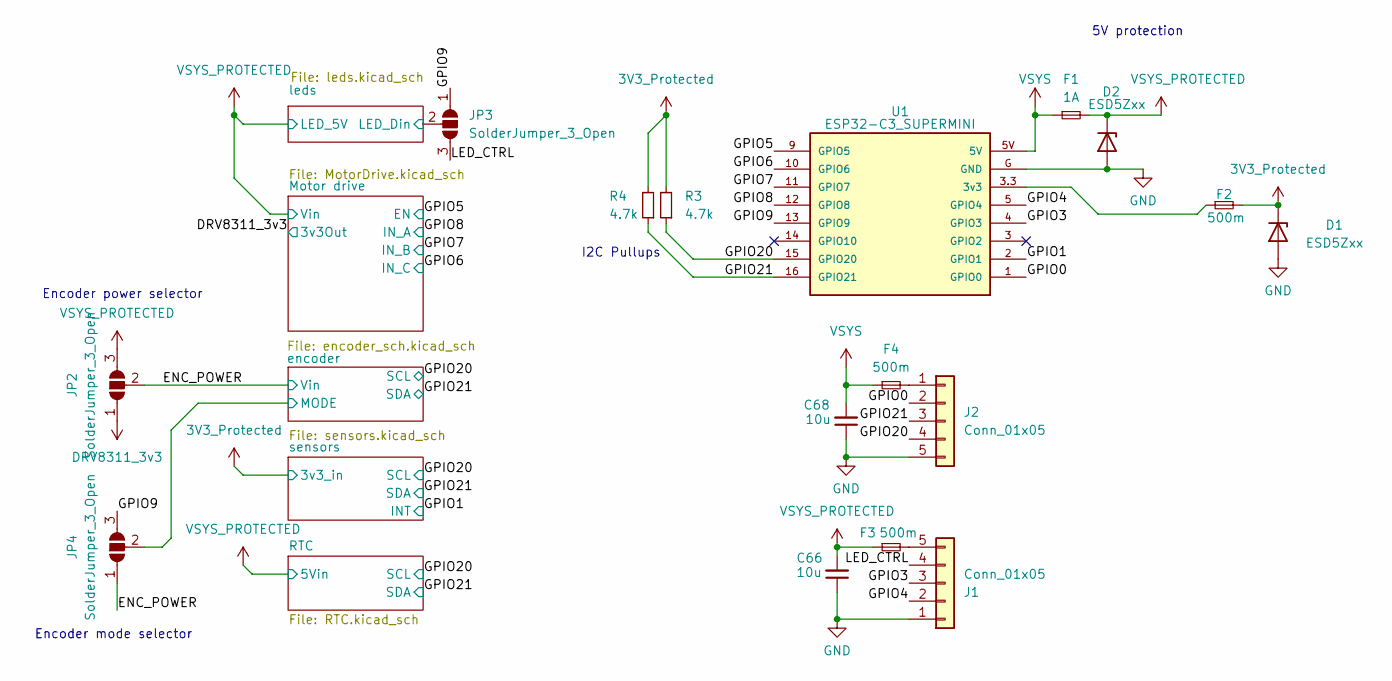
[picture p62: schematic QNOB_V5.kicad_sch, QNOB]

Parts:
C66, C68: 10u; CP_EIA-1608-08_AVX-J_Pad1.25x1.05mm_HandSolder
D1, D2: ESD5Zxx; D_SOD-323
F1: 1A; Fuse_0805_2012Metric_Pad1.15x1.40mm_HandSolder
F2, F3, F4: 500m; Fuse_0603_1608Metric_Pad1.05x0.95mm_HandSolder
J1, J2: Conn_01x05; Molex_PicoBlade_53048-0510_1x05_P1.25mm_Horizontal
JP2, JP3, JP4: SolderJumper_3_Open; SolderJumper-3_P1.3mm_Open_RoundedPad1.0x1.5mm
R3, R4: 4.7k; R_0603_1608Metric_Pad0.98x0.95mm_HandSolder
U1: ESP32-C3_SUPERMINI; MODULE_ESP32-C3_SUPERMINI

Connections:
3V3_Protected: D1.1 (K), F2.2, R3.2, R4.2; also elsewhere on the board
/ENC_POWER: JP2.2 (C), JP4.1 (A); also elsewhere on the board
/GPIO0: J2.2, U1.1 (GPIO0)
/GPIO1: U1.2 (GPIO1); also elsewhere on the board
/GPIO3: J1.3, U1.4 (GPIO3)
/GPIO4: J1.2, U1.5 (GPIO4)
/GPIO5: U1.9 (GPIO5); also elsewhere on the board
/GPIO6: U1.10 (GPIO6); also elsewhere on the board
/GPIO7: U1.11 (GPIO7); also elsewhere on the board
/GPIO8: U1.12 (GPIO8); also elsewhere on the board
/GPIO9: JP3.1 (A), JP4.3 (B), U1.13 (GPIO9)
/GPIO20: J2.4, R3.1, U1.15 (GPIO20); also elsewhere on the board
/GPIO21: J2.3, R4.1, U1.16 (GPIO21); also elsewhere on the board
/LED_CTRL: J1.4, JP3.3 (B)
/encoder/MODE: JP4.2 (C); also elsewhere on the board
/leds/LED_Din: JP3.2 (C); also elsewhere on the board
DRV8311_3v3: JP2.1 (A); also elsewhere on the board
GND: C66.1, C68.1, D1.2 (A), D2.2 (A), J1.1, J2.5, U1.G (GND); also elsewhere on the board
unnamed: F3.2, J1.5
unnamed: F4.2, J2.1
unnamed: F2.1, U1.3.3 (3v3)
VSYS: C68.2, F1.1, F4.1, U1.5V
VSYS_PROTECTED: C66.2, D2.1 (K), F1.2, F3.1, JP2.3 (B); also elsewhere on the board

Notes on the sheet:
I2C Pullups
Encoder power selector
5V protection
Encoder mode selector

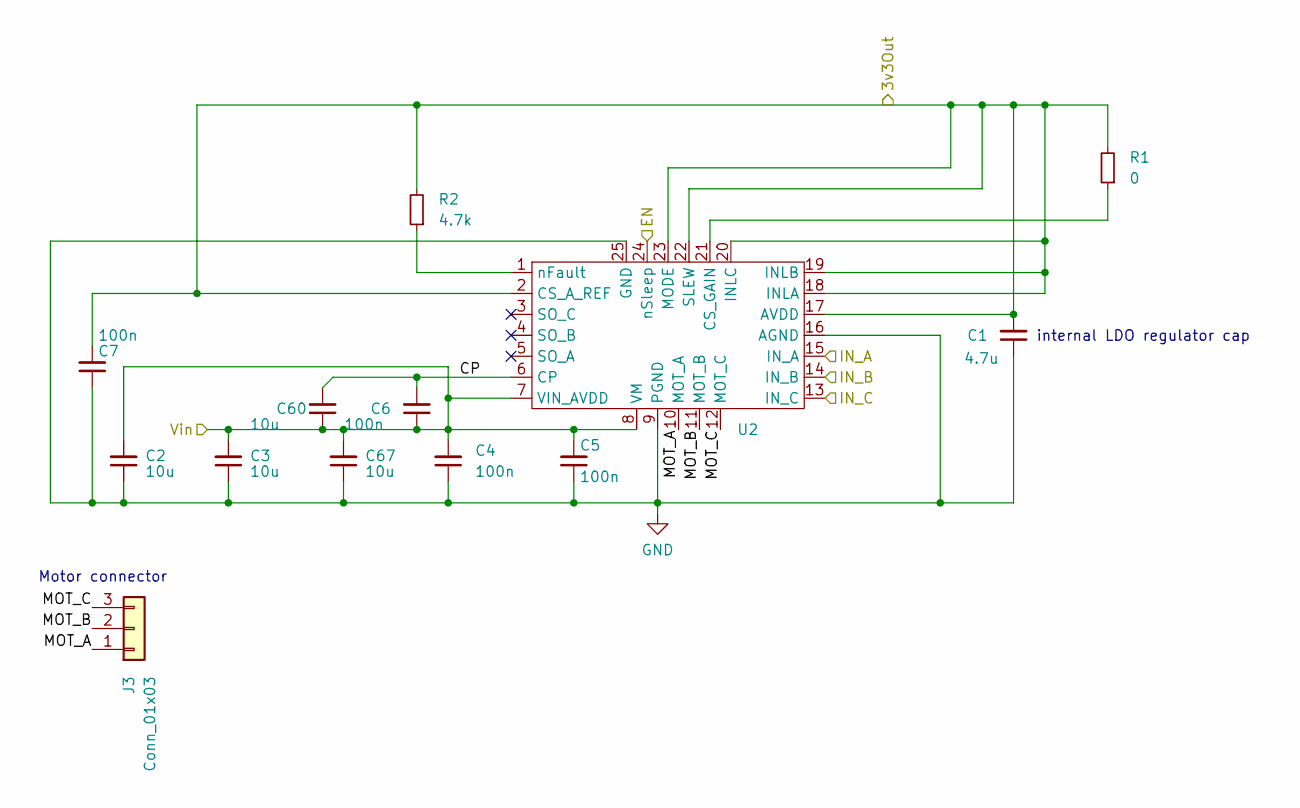
[picture p63: schematic MotorDrive.kicad_sch, QNOB]

Parts:
C1: 4.7u; C_0603_1608Metric_Pad1.08x0.95mm_HandSolder
C2, C3, C60: 10u; C_0603_1608Metric_Pad1.08x0.95mm_HandSolder
C4, C5, C6, C7: 100n; C_0603_1608Metric_Pad1.08x0.95mm_HandSolder
C67: 10u; CP_EIA-1608-08_AVX-J_Pad1.25x1.05mm_HandSolder
J3: Conn_01x03; Molex_PicoBlade_53048-0310_1x03_P1.25mm_Horizontal
R1: 0; R_0603_1608Metric_Pad0.98x0.95mm_HandSolder
R2: 4.7k; R_0603_1608Metric_Pad0.98x0.95mm_HandSolder
U2: IC_DRV8311HRRWR

Connections:
/GPIO5: U2.24 (nSleep); also elsewhere on the board
/GPIO6: U2.13 (IN_C); also elsewhere on the board
/GPIO7: U2.14 (IN_B); also elsewhere on the board
/GPIO8: U2.15 (IN_A); also elsewhere on the board
/Motor drive/CP: C6.2, C60.2, U2.6 (CP)
/Motor drive/MOT_A: J3.1, U2.10 (MOT_A)
/Motor drive/MOT_B: J3.2, U2.11 (MOT_B)
/Motor drive/MOT_C: J3.3, U2.12 (MOT_C)
DRV8311_3v3: C1.2, C7.2, R1.2, R2.2, U2.2 (CS_A_REF), U2.17 (AVDD), U2.18 (INLA), U2.19 (INLB), U2.20 (INLC), U2.22 (SLEW), U2.23 (MODE); also elsewhere on the board
GND: C1.1, C2.1, C3.1, C4.1, C5.1, C7.1, C67.1, U2.9 (PGND), U2.16 (AGND), U2.25 (GND); also elsewhere on the board
unnamed: R1.1, U2.21 (CS_GAIN)
unnamed: R2.1, U2.1 (nFault)
VSYS_PROTECTED: C2.2, C3.2, C4.2, C5.2, C6.1, C60.1, C67.2, U2.7 (VIN_AVDD), U2.8 (VM); also elsewhere on the board

Notes on the sheet:
Motor connector
internal LDO regulator cap

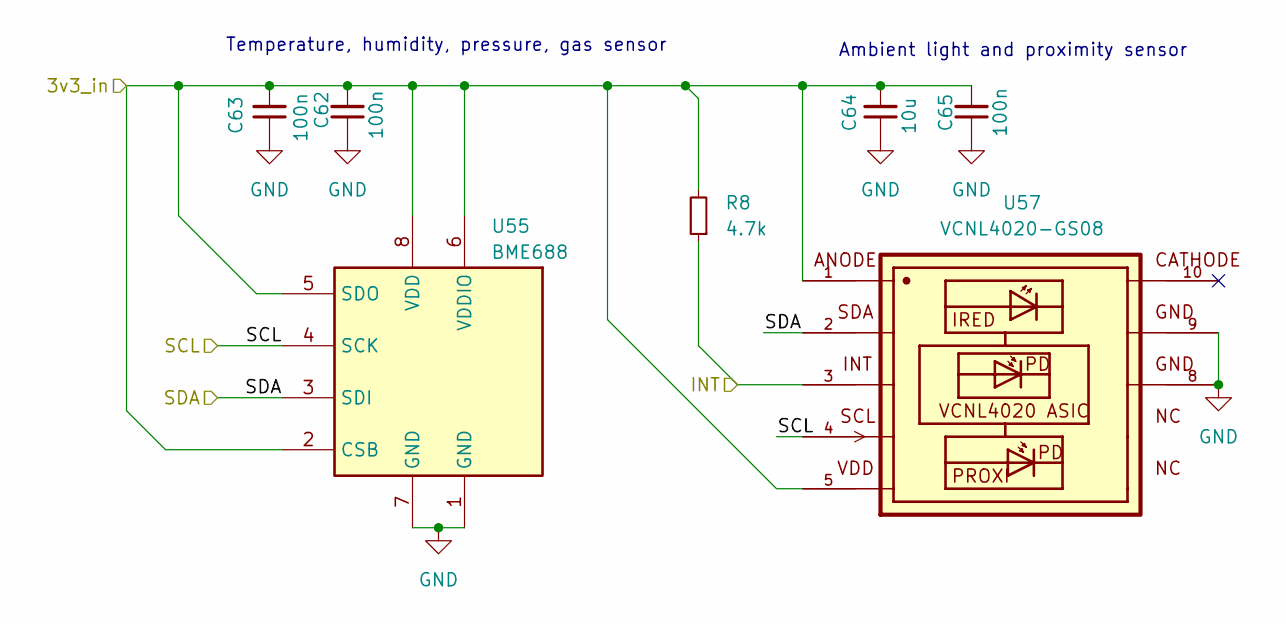
[picture p64: schematic sensors.kicad_sch, QNOB]

Parts:
C62, C63: 100n; C_0402_1005Metric
C64: 10u; C_0603_1608Metric_Pad1.08x0.95mm_HandSolder
C65: 100n; C_0603_1608Metric_Pad1.08x0.95mm_HandSolder
R8: 4.7k; R_0603_1608Metric_Pad0.98x0.95mm_HandSolder
U55: BME688; Bosch_LGA-8_3x3mm_P0.8mm_ClockwisePinNumbering
U57: VCNL4020-GS08; PHODET_VCNL4020

Connections:
3V3_Protected: C62.2, C63.2, C64.2, C65.2, R8.2, U55.2 (CSB), U55.5 (SDO), U55.6 (VDDIO), U55.8 (VDD), U57.1, U57.5; also elsewhere on the board
/GPIO1: R8.1, U57.3; also elsewhere on the board
/GPIO20: U55.4 (SCK), U57.4; also elsewhere on the board
/GPIO21: U55.3 (SDI), U57.2; also elsewhere on the board
GND: C62.1, C63.1, C64.1, C65.1, U55.1 (GND), U55.7 (GND), U57.8, U57.9; also elsewhere on the board

Notes on the sheet:
Ambient light and proximity sensor
Temperature, humidity, pressure, gas sensor
