alperbasarn/QNOB/PCB/V3/QNOB_V5/QNOB_V5.kicad_pcb

## KiCad design PCB/V3/QNOB_V5/QNOB_V5.kicad_pcb (continued)

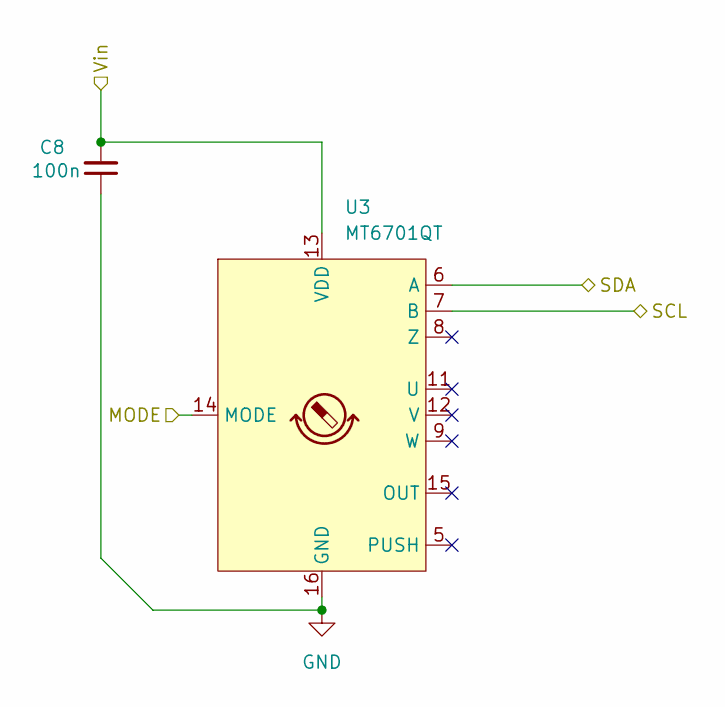
[picture p65: schematic encoder_sch.kicad_sch, QNOB]

Parts:
C8: 100n; C_0402_1005Metric
U3: MT6701QT; QFN-16-1EP_3x3mm_P0.5mm_EP1.7x1.7mm

Connections:
/ENC_POWER: C8.2, U3.13 (VDD); also elsewhere on the board
/GPIO20: U3.7 (B); also elsewhere on the board
/GPIO21: U3.6 (A); also elsewhere on the board
/encoder/MODE: U3.14 (MODE); also elsewhere on the board
GND: C8.1, U3.16 (GND), U3.17 (GND); also elsewhere on the board

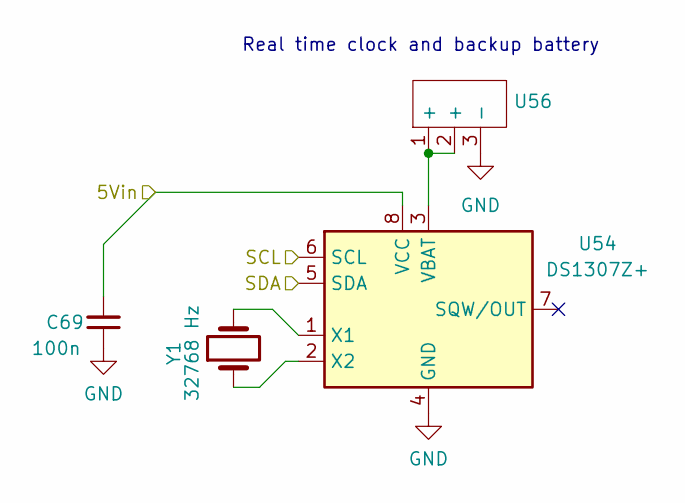
[picture p66: schematic RTC.kicad_sch, QNOB]

Parts:
C69: 100n; C_0603_1608Metric_Pad1.08x0.95mm_HandSolder
U54: DS1307Z+; SOIC-8_3.9x4.9mm_P1.27mm
U56: battery_holder_1225_SMD
Y1: 32768 Hz; XTAL_FC-135_EPS

Connections:
/GPIO20: U54.6 (SCL); also elsewhere on the board
/GPIO21: U54.5 (SDA); also elsewhere on the board
GND: C69.1, U54.4 (GND), U56.3 (-); also elsewhere on the board
unnamed: U54.3 (VBAT), U56.1 (+), U56.2 (+)
unnamed: U54.1 (X1), Y1.2
unnamed: U54.2 (X2), Y1.1
VSYS_PROTECTED: C69.2, U54.8 (VCC); also elsewhere on the board

Notes on the sheet:
Real time clock and backup battery

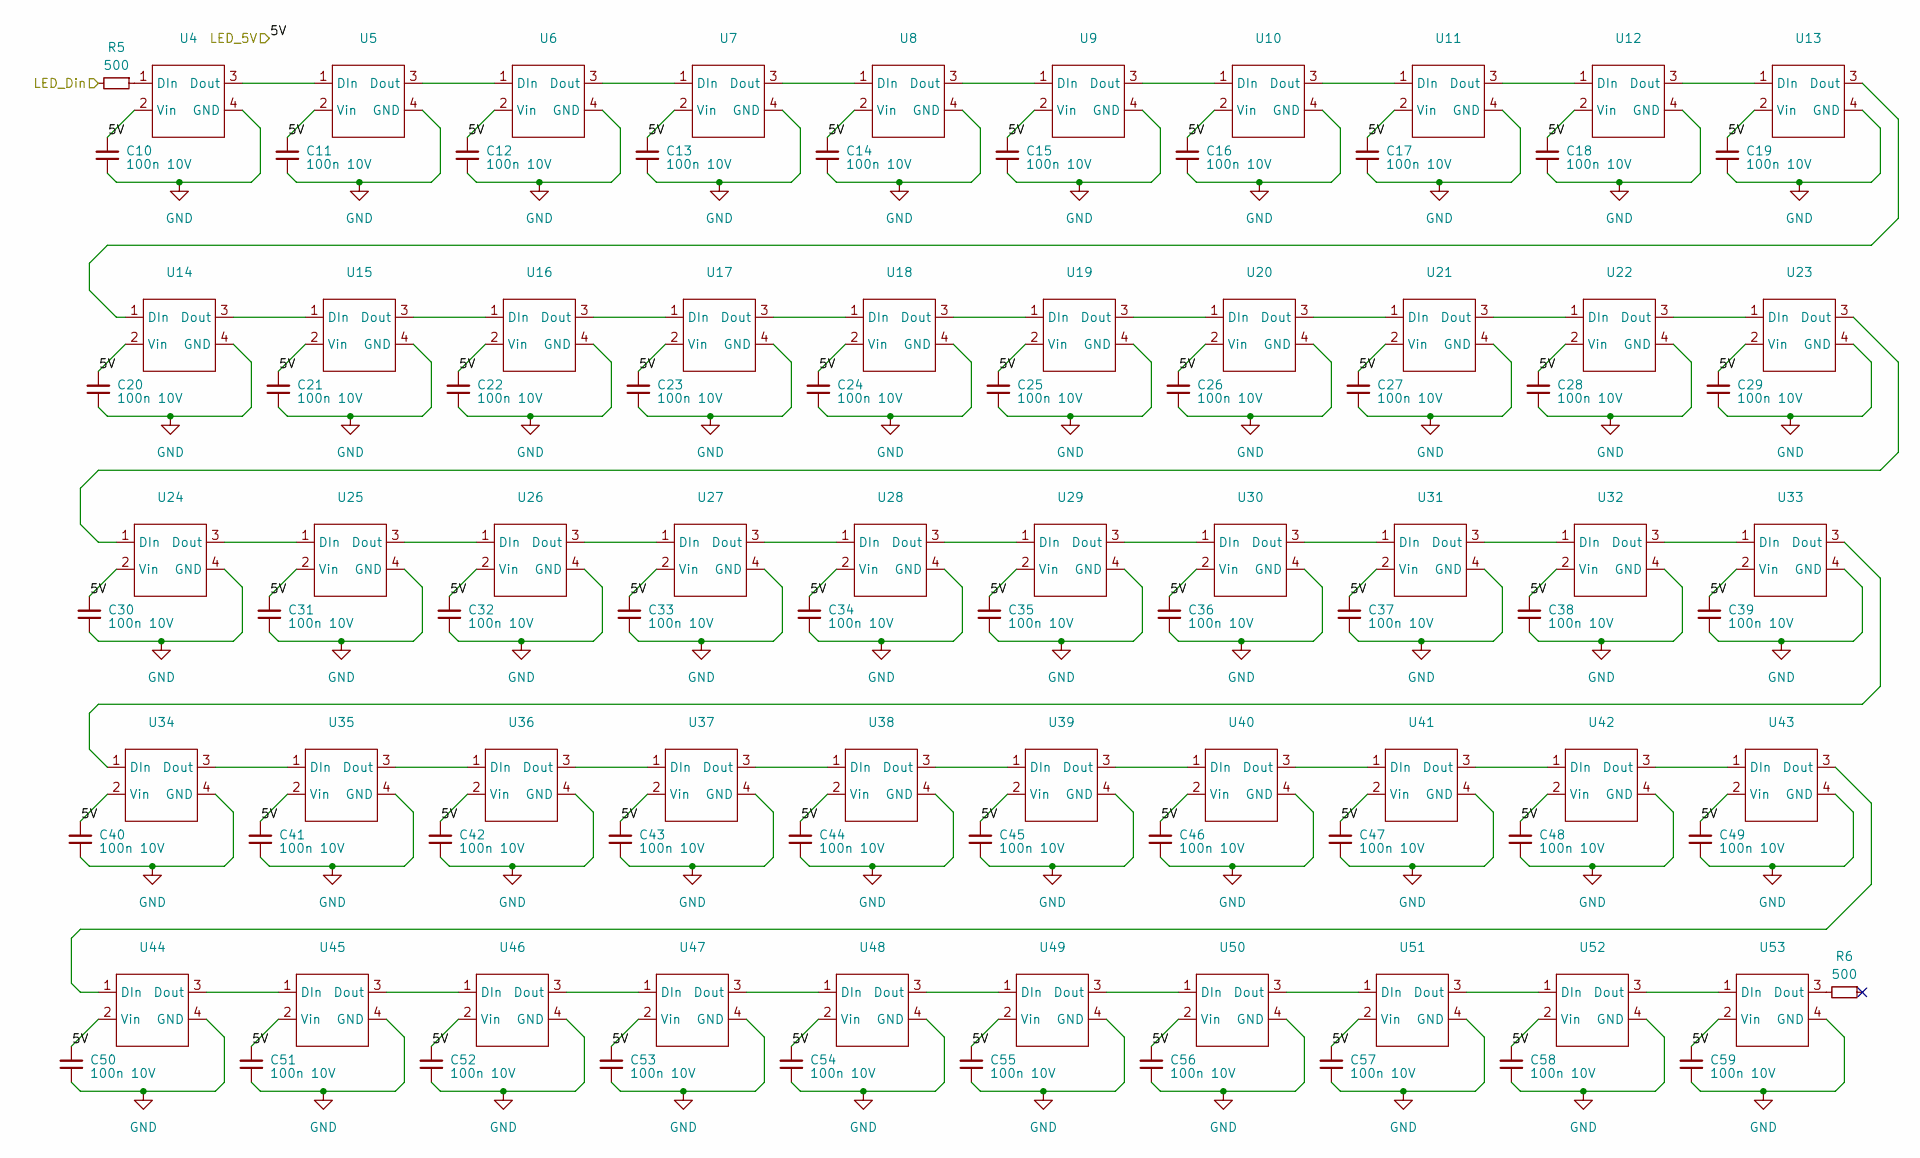
[picture p67: schematic leds.kicad_sch, QNOB]

Parts:
C10, C11, C12, C13, C14, C15, C16, C17, C18, C19, C20, C21, C22, C23, C24, C25, C26, C27, C28, C29, C30, C31, C32, C33, C34, C35, C36, C37, C38, C39, C40, C41, C42, C43, C44, C45, C46, C47, C48, C49, C50, C51, C52, C53, C54, C55, C56, C57, C58, C59: 100n 10V; C_0402_1005Metric
R5, R6: 500; R_0402_1005Metric
U4, U5, U6, U7, U8, U9, U10, U11, U12, U13, U14, U15, U16, U17, U18, U19, U20, U21, U22, U23, U24, U25, U26, U27, U28, U29, U30, U31, U32, U33, U34, U35, U36, U37, U38, U39, U40, U41, U42, U43, U44, U45, U46, U47, U48, U49, U50, U51, U52, U53: SK6805-EC15

Connections:
/leds/LED_Din: R5.2; also elsewhere on the board
GND: C10.1, C11.1, C12.1, C13.1, C14.1, C15.1, C16.1, C17.1, C18.1, C19.1, C20.1, C21.1, C22.1, C23.1, C24.1, C25.1, C26.1, C27.1, C28.1, C29.1, C30.1, C31.1, C32.1, C33.1, C34.1, C35.1, C36.1, C37.1, C38.1, C39.1, C40.1, C41.1, C42.1, C43.1, C44.1, C45.1, C46.1, C47.1, C48.1, C49.1, C50.1, C51.1, C52.1, C53.1, C54.1, C55.1, C56.1, C57.1, C58.1, C59.1, U4.4 (GND), U5.4 (GND), U6.4 (GND), U7.4 (GND), U8.4 (GND), U9.4 (GND), U10.4 (GND), U11.4 (GND), U12.4 (GND), U13.4 (GND), U14.4 (GND), U15.4 (GND), U16.4 (GND), U17.4 (GND), U18.4 (GND), U19.4 (GND), U20.4 (GND), U21.4 (GND), U22.4 (GND), U23.4 (GND), U24.4 (GND), U25.4 (GND), U26.4 (GND), U27.4 (GND), U28.4 (GND), U29.4 (GND), U30.4 (GND), U31.4 (GND), U32.4 (GND), U33.4 (GND), U34.4 (GND), U35.4 (GND), U36.4 (GND), U37.4 (GND), U38.4 (GND), U39.4 (GND), U40.4 (GND), U41.4 (GND), U42.4 (GND), U43.4 (GND), U44.4 (GND), U45.4 (GND), U46.4 (GND), U47.4 (GND), U48.4 (GND), U49.4 (GND), U50.4 (GND), U51.4 (GND), U52.4 (GND), U53.4 (GND); also elsewhere on the board
unnamed: R5.1, U4.1 (DIn)
unnamed: U4.3 (Dout), U5.1 (DIn)
unnamed: U5.3 (Dout), U6.1 (DIn)
unnamed: U6.3 (Dout), U7.1 (DIn)
unnamed: U7.3 (Dout), U8.1 (DIn)
unnamed: U8.3 (Dout), U9.1 (DIn)
unnamed: U9.3 (Dout), U10.1 (DIn)
unnamed: U10.3 (Dout), U11.1 (DIn)
unnamed: U11.3 (Dout), U12.1 (DIn)
unnamed: U12.3 (Dout), U13.1 (DIn)
unnamed: U13.3 (Dout), U14.1 (DIn)
unnamed: U14.3 (Dout), U15.1 (DIn)
unnamed: U15.3 (Dout), U16.1 (DIn)
unnamed: U16.3 (Dout), U17.1 (DIn)
unnamed: U17.3 (Dout), U18.1 (DIn)
unnamed: U18.3 (Dout), U19.1 (DIn)
unnamed: U19.3 (Dout), U20.1 (DIn)
unnamed: U20.3 (Dout), U21.1 (DIn)
unnamed: U21.3 (Dout), U22.1 (DIn)
unnamed: U22.3 (Dout), U23.1 (DIn)
unnamed: U23.3 (Dout), U24.1 (DIn)
unnamed: U24.3 (Dout), U25.1 (DIn)
unnamed: U25.3 (Dout), U26.1 (DIn)
unnamed: U26.3 (Dout), U27.1 (DIn)
unnamed: U27.3 (Dout), U28.1 (DIn)
unnamed: U28.3 (Dout), U29.1 (DIn)
unnamed: U29.3 (Dout), U30.1 (DIn)
unnamed: U30.3 (Dout), U31.1 (DIn)
unnamed: U31.3 (Dout), U32.1 (DIn)
unnamed: U32.3 (Dout), U33.1 (DIn)
unnamed: U33.3 (Dout), U34.1 (DIn)
unnamed: U34.3 (Dout), U35.1 (DIn)
unnamed: U35.3 (Dout), U36.1 (DIn)
unnamed: U36.3 (Dout), U37.1 (DIn)
unnamed: U37.3 (Dout), U38.1 (DIn)
unnamed: U38.3 (Dout), U39.1 (DIn)
unnamed: U39.3 (Dout), U40.1 (DIn)
unnamed: U40.3 (Dout), U41.1 (DIn)
unnamed: U41.3 (Dout), U42.1 (DIn)
unnamed: U42.3 (Dout), U43.1 (DIn)
unnamed: U43.3 (Dout), U44.1 (DIn)
unnamed: U44.3 (Dout), U45.1 (DIn)
unnamed: U45.3 (Dout), U46.1 (DIn)
unnamed: U46.3 (Dout), U47.1 (DIn)
unnamed: U47.3 (Dout), U48.1 (DIn)
unnamed: U48.3 (Dout), U49.1 (DIn)
unnamed: U49.3 (Dout), U50.1 (DIn)
unnamed: U50.3 (Dout), U51.1 (DIn)
unnamed: U51.3 (Dout), U52.1 (DIn)
unnamed: U52.3 (Dout), U53.1 (DIn)
unnamed: R6.2, U53.3 (Dout)
VSYS_PROTECTED: C10.2, C11.2, C12.2, C13.2, C14.2, C15.2, C16.2, C17.2, C18.2, C19.2, C20.2, C21.2, C22.2, C23.2, C24.2, C25.2, C26.2, C27.2, C28.2, C29.2, C30.2, C31.2, C32.2, C33.2, C34.2, C35.2, C36.2, C37.2, C38.2, C39.2, C40.2, C41.2, C42.2, C43.2, C44.2, C45.2, C46.2, C47.2, C48.2, C49.2, C50.2, C51.2, C52.2, C53.2, C54.2, C55.2, C56.2, C57.2, C58.2, C59.2, U4.2 (Vin), U5.2 (Vin), U6.2 (Vin), U7.2 (Vin), U8.2 (Vin), U9.2 (Vin), U10.2 (Vin), U11.2 (Vin), U12.2 (Vin), U13.2 (Vin), U14.2 (Vin), U15.2 (Vin), U16.2 (Vin), U17.2 (Vin), U18.2 (Vin), U19.2 (Vin), U20.2 (Vin), U21.2 (Vin), U22.2 (Vin), U23.2 (Vin), U24.2 (Vin), U25.2 (Vin), U26.2 (Vin), U27.2 (Vin), U28.2 (Vin), U29.2 (Vin), U30.2 (Vin), U31.2 (Vin), U32.2 (Vin), U33.2 (Vin), U34.2 (Vin), U35.2 (Vin), U36.2 (Vin), U37.2 (Vin), U38.2 (Vin), U39.2 (Vin), U40.2 (Vin), U41.2 (Vin), U42.2 (Vin), U43.2 (Vin), U44.2 (Vin), U45.2 (Vin), U46.2 (Vin), U47.2 (Vin), U48.2 (Vin), U49.2 (Vin), U50.2 (Vin), U51.2 (Vin), U52.2 (Vin), U53.2 (Vin); also elsewhere on the board

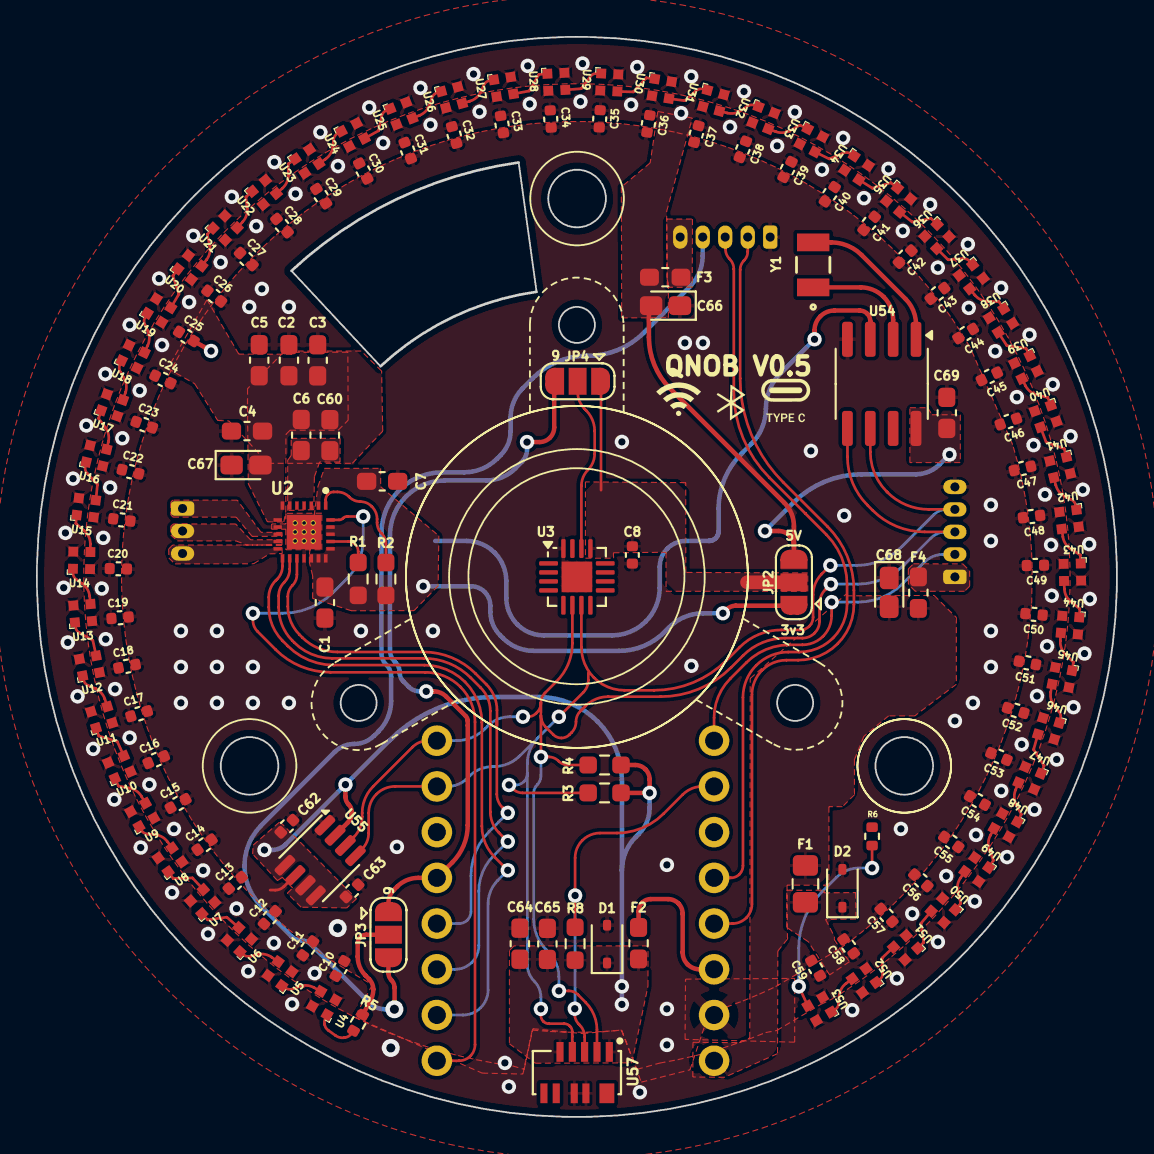
[picture p68: board PCB/V3/QNOB_V5/QNOB_V5.kicad_pcb from above]

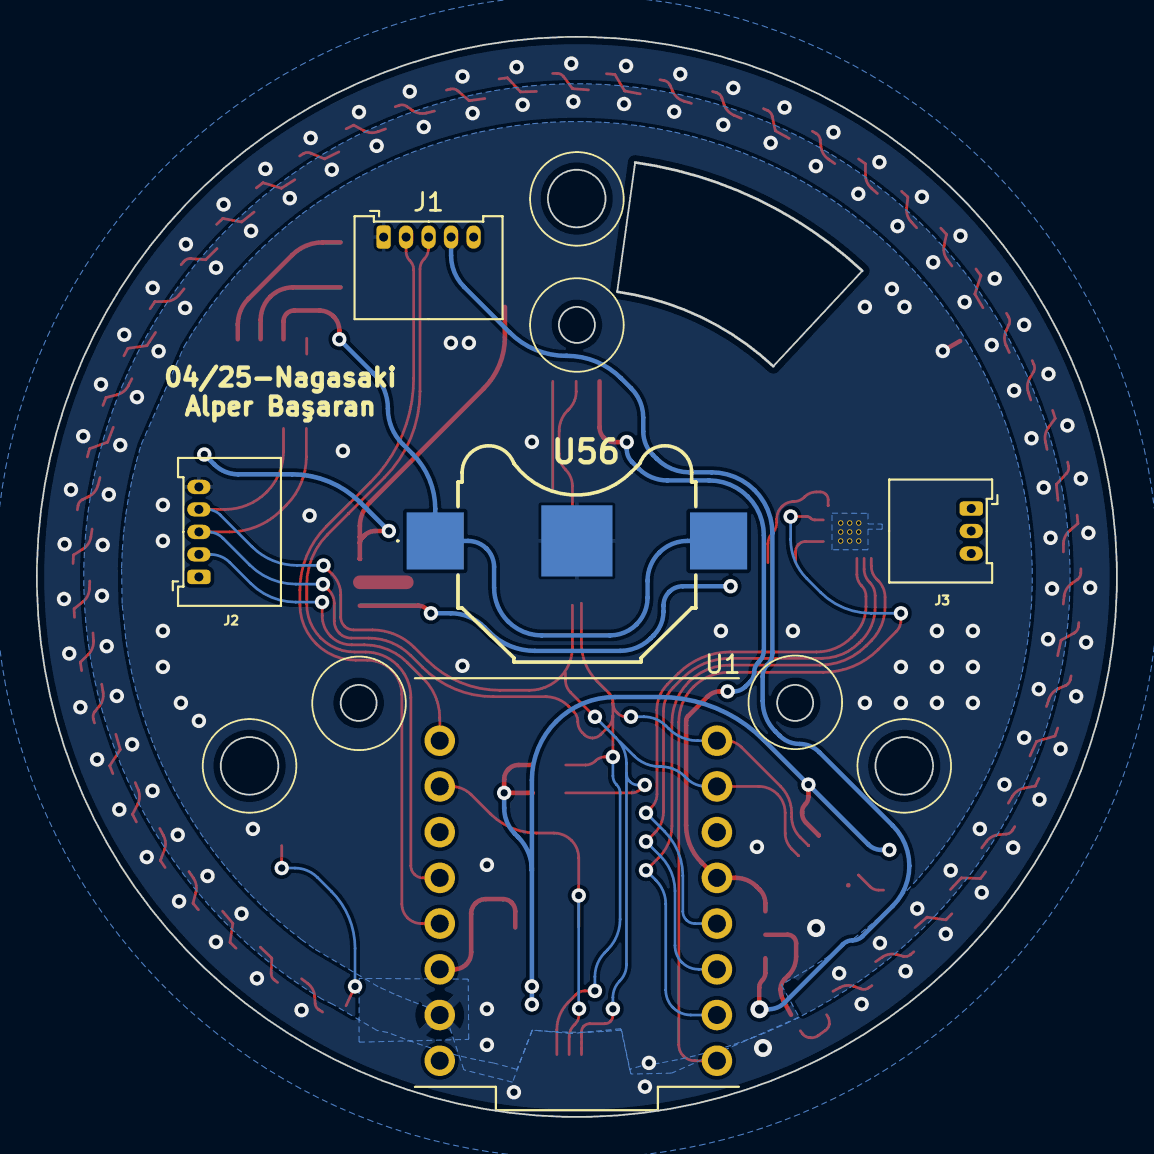
[picture p69: board PCB/V3/QNOB_V5/QNOB_V5.kicad_pcb from below]

Board: 2 copper layers, 60.0 x 60.0 mm, 144 parts (5 on the bottom side), 83 nets.
