alperbasarn/QNOB/PCB/V6/QNOB_V6/QNOB_V5.kicad_pcb

## KiCad design PCB/V6/QNOB_V6/QNOB_V5.kicad_pcb (2025-05-01)

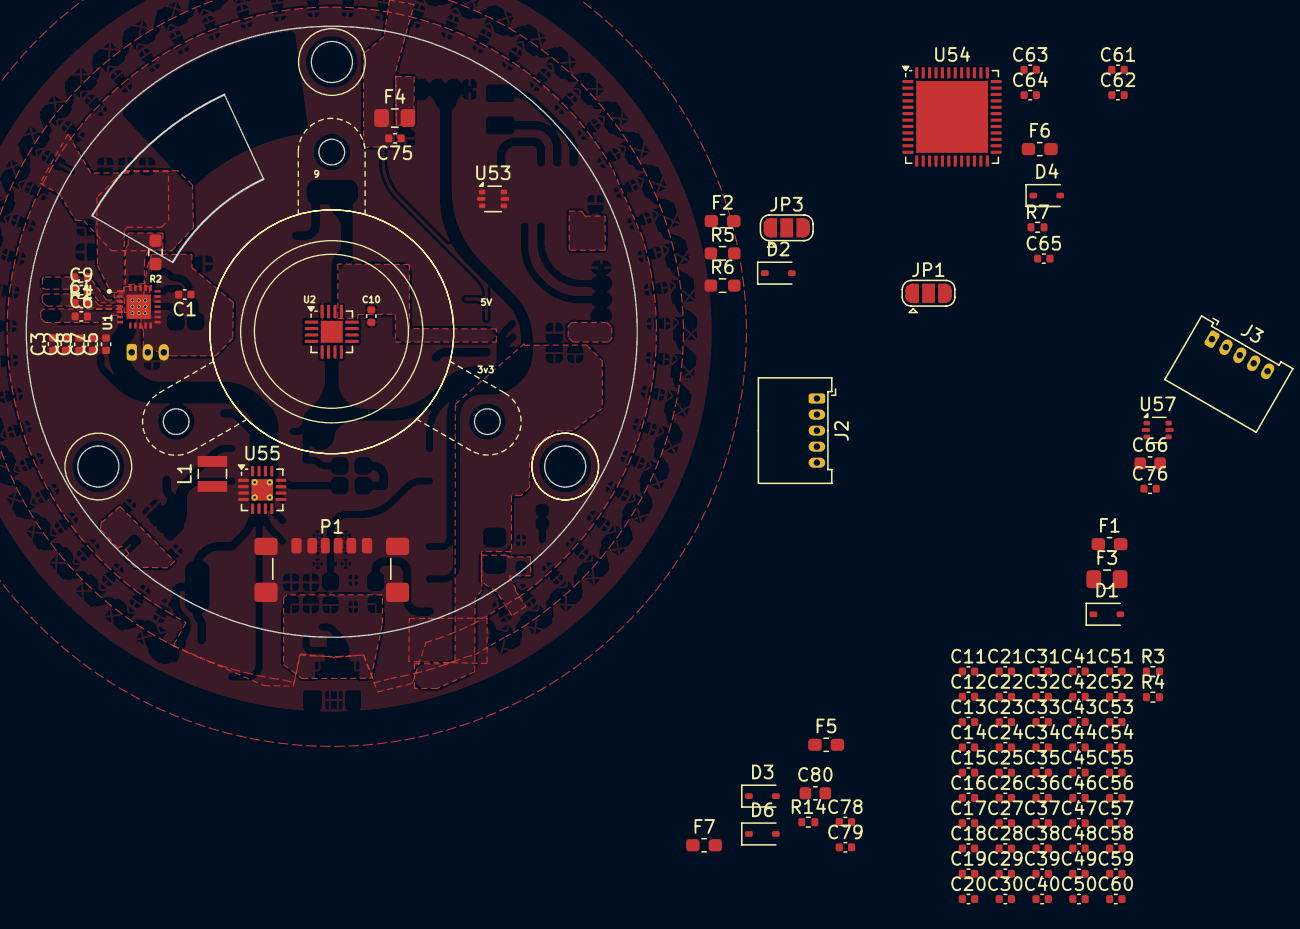
[picture p70: board PCB/V6/QNOB_V6/QNOB_V5.kicad_pcb from above]

Board: 2 copper layers, 47.6 x 47.6 mm, 104 parts (1 on the bottom side), 31 nets, no tracks yet.

Parts:
C1, C2, C4, C5, C6, C7, C64, C75, C76, C78: 10u; C_0402_1005Metric
C3, C8, C9, C10, C12: 100n; C_0402_1005Metric
C11: 4.7u; C_0402_1005Metric
C13, C14, C15, C16, C17, C18, C19, C20, C21, C22, C23, C24, C25, C26, C27, C28, C29, C30, C31, C32, C33, C34, C35, C36, C37, C38, C39, C40, C41, C42, C43, C44, C45, C46, C47, C48, C49, C50, C51, C52, C53, C54, C55, C56, C57, C58, C59, C60, C61, C62: 100n 10V; C_0402_1005Metric
C63: 1u; C_0402_1005Metric
C65, C79: 3.3n; C_0402_1005Metric
C66, C80: 22u; C_0603_1608Metric
D1, D2, D3, D4, D6: ESD5Zxx; D_SOD-323
F1, F2, F5: 500m; Fuse_0603_1608Metric_Pad1.05x0.95mm_HandSolder
F3: 2.5A; Fuse_0805_2012Metric_Pad1.15x1.40mm_HandSolder
F4: 1A; Fuse_0805_2012Metric_Pad1.15x1.40mm_HandSolder
F6, F7: 200mA; Fuse_0603_1608Metric_Pad1.05x0.95mm_HandSolder
J1: Conn_01x03; Molex_PicoBlade_53048-0310_1x03_P1.25mm_Horizontal
J2, J3: Conn_01x05; Molex_PicoBlade_53048-0510_1x05_P1.25mm_Horizontal
JP1, JP3: SolderJumper_3_Open; SolderJumper-3_P1.3mm_Open_RoundedPad1.0x1.5mm
L1: 2.2u; L_Wuerth_MAPI-2506
P1: USB_C_Plug_USB2.0; USB_C_Receptacle_GCT_USB4135-GF-A_6P_TopMnt_Horizontal
R1: 4.7k; R_0402_1005Metric
R2: 0; R_0603_1608Metric_Pad0.98x0.95mm_HandSolder
R3, R4: 500; R_0402_1005Metric
R5, R6: 4.7k; R_0603_1608Metric_Pad0.98x0.95mm_HandSolder
R7, R14: 100k; R_0402_1005Metric
U1: IC_DRV8311HRRWR
U2: MT6701QT; QFN-16-1EP_3x3mm_P0.5mm_EP1.7x1.7mm
U53, U57: USBLC6-2P6; SOT-666
U54: STM32F401CBUx; QFN-48-1EP_7x7mm_P0.5mm_EP5.6x5.6mm
U55: TPS62130; VQFN-16-1EP_3x3mm_P0.5mm_EP1.68x1.68mm_ThermalVias

Connections:
3V3: F6.2, F7.2
3V3_Protected: D3.1 (K), F5.2, R5.2, R6.2
5V: C2.2, C76.2, F1.1
/DRV8311_3v3: C3.2, C11.2, R1.2, R2.2, U1.2 (CS_A_REF), U1.17 (AVDD), U1.18 (INLA), U1.19 (INLB), U1.20 (INLC), U1.22 (SLEW), U1.23 (MODE)
/ENC_POWER: C12.2, U2.13 (VDD)
/GPIO9: JP1.1 (A), JP3.1 (A)
/GPIO20: J2.4, U2.7 (B)
/GPIO21: J2.3, U2.6 (A)
/LED_CTRL: J3.4, JP1.3 (B), JP3.3 (B)
/MCU/D+: U53.4 (I/O2), U57.4 (I/O2)
/MCU/D-: U53.6 (I/O1), U57.6 (I/O1)
/Motor drive/CP: C6.2, C8.2, U1.6 (CP)
/leds/LED_Din: JP1.2 (C), JP3.2 (C), R3.2
GND: C1.1, C2.1, C3.1, C4.1, C5.1, C7.1, C9.1, C10.1, C11.1, C12.1, C13.1, C14.1, C15.1, C16.1, C17.1, C18.1, C19.1, C20.1, C21.1, C22.1, C23.1, C24.1, C25.1, C26.1, C27.1, C28.1, C29.1, C30.1, C31.1, C32.1, C33.1, C34.1, C35.1, C36.1, C37.1, C38.1, C39.1, C40.1, C41.1, C42.1, C43.1, C44.1, C45.1, C46.1, C47.1, C48.1, C49.1, C50.1, C51.1, C52.1, C53.1, C54.1, C55.1, C56.1, C57.1, C58.1, C59.1, C60.1, C61.1, C62.1, C63.1, C66.2, C75.1, C76.1, C80.2, D1.2 (A), D2.2 (A), D3.2 (A), D4.2 (A), D6.2 (A), J2.5, J3.1, P1.A12 (GND), P1.B12 (GND), P1.S1 (SHIELD), R7.1, R14.1, U1.9 (PGND), U1.16 (AGND), U1.25 (GND), U2.16 (GND), U2.17 (GND), U53.2 (GND), U55.4 (PG), U55.5 (FB), U55.6 (GND), U55.15 (GND), U55.16 (GND), U55.17 (GND), U57.2 (GND)
unnamed: C63.2, D1.1 (K), F3.2, U53.5 (VBUS)
unnamed: C66.1, D4.1 (K), F6.1, L1.2, R7.2, U55.14 (VOS)
unnamed: C80.1, D6.1 (K), F7.1, R14.2
unnamed: F1.2, J2.1
unnamed: F2.2, J3.5
unnamed: L1.1, U55.1 (SW), U55.2 (SW), U55.3 (SW)
unnamed: U53.3 (I/O2), U57.3 (I/O2)
unnamed: U53.1 (I/O1), U57.1 (I/O1)
unnamed: R2.1, U1.21 (CS_GAIN)
unnamed: R1.1, U1.1 (nFault)
unnamed: U54.23 (VSS), U54.35 (VSS), U54.47 (VSS), U54.49 (VSS)
unnamed: C64.1, C65.2, U55.7 (FSW), U55.8 (DEF)
unnamed: C64.2, U55.10 (VIN), U55.11 (VIN), U55.12 (VIN), U55.13 (EN)
unnamed: C65.1, U55.9 (SS/TR)
unnamed: C78.1, C79.2
VBUS: F3.1, P1.A9 (VBUS), P1.B9 (VBUS)
VSYS_PROTECTED: C1.2, C4.2, C5.2, C6.1, C7.2, C8.1, C9.2, C10.2, C13.2, C14.2, C15.2, C16.2, C17.2, C18.2, C19.2, C20.2, C21.2, C22.2, C23.2, C24.2, C25.2, C26.2, C27.2, C28.2, C29.2, C30.2, C31.2, C32.2, C33.2, C34.2, C35.2, C36.2, C37.2, C38.2, C39.2, C40.2, C41.2, C42.2, C43.2, C44.2, C45.2, C46.2, C47.2, C48.2, C49.2, C50.2, C51.2, C52.2, C53.2, C54.2, C55.2, C56.2, C57.2, C58.2, C59.2, C60.2, C61.2, C62.2, C75.2, D2.1 (K), F2.1, F4.2, U1.7 (VIN_AVDD), U1.8 (VM)
