alperbasarn/QNOB/screen/SW/esp-idf/components/display/DisplayController.cpp

#include "DisplayController.h"
#include "esp_log.h"
#include "freertos/FreeRTOS.h"
#include "freertos/task.h"
#include "driver/gpio.h"
#include "esp_timer.h"


static const char *TAG = "DisplayController";

// Stubs for other controllers
class TouchPanel {
public:
    TouchPanel(int sda, int scl, int rst, int irq) {}
    void initialize() {}
    void handleTouchPanel() {}
    bool isPressed() { return false; }
    bool getHasNewPress() { return false; }
    bool getHasNewRelease() { return false; }
    bool getHasNewHoldRelease() { return false; }
};

// Add stubs for all other classes used by DisplayController
class WiFiTCPClient {
public:
    bool isWiFiConnected() { return false; }
    bool isMQTTConnected() { return false; }
    void* getMQTTHandler() { return nullptr; }
};
class KnobController {
public:
    void sendCommand(const char* cmd) {}
    bool getHasNewMessage() { return false; }
    void update() {}
};
class InitializationScreen {
public:
    InitializationScreen(LGFX* gfx) {}
    void setWiFiStatus(bool connected, int strength) {}
    void setMQTTStatus(bool connected) {}
    void setProgress(int progress) {}
    void updateScreen() {}
    void reset() {}
};
class InfoScreen {
public:
    InfoScreen(LGFX* gfx, TouchPanel* tp, WiFiTCPClient* tcp) {}
    void resetLastActivityTime() {}
    void update() {}
    bool isPageBackRequested() { return false; }
    void resetPageBackRequest() {}
    void resetScreen() {}
    void setTCPClient(WiFiTCPClient* client) {}
};
class SoundController {
public:
    SoundController(LGFX* gfx, TouchPanel* tp, void* mqtt) {}
    void updateScreen() {}
    bool isPageBackRequested() { return false; }
    void resetPageBackRequest() {}
    void updateSetpoint(int level) {}
    void incrementSetpoint() {}
    void decrementSetpoint() {}
    void setMQTTHandler(void* handler) {}
};
class LightController {
public:
    LightController(LGFX* gfx, TouchPanel* tp, void* mqtt) {}
    void updateScreen() {}
    bool isPageBackRequested() { return false; }
    void resetPageBackRequest() {}
    void incrementSetpoint() {}
    void decrementSetpoint() {}
    void setSetpoint(int setpoint) {}
    void setMQTTHandler(void* handler) {}
};
class ModeController {
public:
    ModeController(LGFX* gfx, TouchPanel* tp, WiFiTCPClient* tcp) {}
    void setActive(bool active) {}
    void updateScreen() {}
    bool isSoundModeActive() { return false; }
    bool isLightModeActive() { return false; }
    void nextMode() {}
    void previousMode() {}
    void setTCPClient(WiFiTCPClient* client) {}
};
class AnimationHelper {
public:
    enum TransitionType {
        NONE,
        FADE,
        ZOOM_IN,
        ZOOM_OUT,
        WIPE_UP,
        WIPE_DOWN,
        WIPE_LEFT,
        WIPE_RIGHT
    };
    static void performTransition(LGFX* gfx, TransitionType type, int duration = 500) {}
};


DisplayController::DisplayController(LGFX* graphics, int sda, int scl, int rst, int irq, WiFiTCPClient* tcpClient)
  : gfx(graphics), tcpClient(tcpClient), displayIsOn(true), soundController(nullptr),
    modeController(nullptr), lightController(nullptr), knobController(nullptr),
    initializationScreen(nullptr), infoScreen(nullptr), currentMode(INITIALIZATION),
    lastActivityTime(0), screenPressed(false), screenReleased(false) {

  // Initialize touch panel first
  touchPanel = new TouchPanel(sda, scl, rst, irq);

  void* mqttHandler = nullptr;
  if (tcpClient) {
      mqttHandler = tcpClient->getMQTTHandler();
  }
  lightController = new LightController(gfx, touchPanel, mqttHandler);
  soundController = new SoundController(gfx, touchPanel, mqttHandler);
  modeController = new ModeController(gfx, touchPanel, tcpClient);
  initializationScreen = new InitializationScreen(gfx);
  infoScreen = new InfoScreen(gfx, touchPanel, tcpClient);
}

void DisplayController::initScreen() {
  gfx->begin();
  gfx->invertDisplay(true);
  gfx->fillScreen(TFT_BLACK);

#if defined(LCD_BL_PIN) && (LCD_BL_PIN != -1)
  gpio_set_direction((gpio_num_t)LCD_BL_PIN, GPIO_MODE_OUTPUT);
  gpio_set_level((gpio_num_t)LCD_BL_PIN, 1);
#endif

  // Start with initialization screen
  setMode(INITIALIZATION);
  touchPanel->initialize();

  // Initialize activity timestamp
  resetActivityTime();
}

void DisplayController::registerKnobController(KnobController* knob) {
  knobController = knob;
}

void DisplayController::setTCPClient(WiFiTCPClient* client) {
  tcpClient = client;

  // Update TCP client in controllers that use it directly
  if (modeController) modeController->setTCPClient(client);
  if (infoScreen) infoScreen->setTCPClient(client);

  // Update MQTTHandler in controllers that use it directly
  if (client) {
    void* mqttHandler = tcpClient->getMQTTHandler();
    if (soundController) soundController->setMQTTHandler(mqttHandler);
    if (lightController) lightController->setMQTTHandler(mqttHandler);
  }
}

void DisplayController::updateInitProgress(int progress) {
  if (initializationScreen && currentMode == INITIALIZATION) {
    if (tcpClient) {
      bool wifiConnected = tcpClient->isWiFiConnected();
      bool mqttConnected = tcpClient->isMQTTConnected();

      initializationScreen->setWiFiStatus(wifiConnected, wifiConnected ? 3 : 0);
      initializationScreen->setMQTTStatus(mqttConnected);
    }
    initializationScreen->setProgress(progress);
  }
}

bool DisplayController::getHasNewEvent() {
  if (isPressed() || (knobController && knobController->getHasNewMessage())) {
    resetActivityTime();
    return true;
  }
  return false;
}

void DisplayController::resetActivityTime() {
  lastActivityTime = esp_timer_get_time() / 1000;

  if (infoScreen && currentMode == INFO) {
    infoScreen->resetLastActivityTime();
  }

  if (!displayIsOn) {
    turnDisplayOn();
  }
}
//... (The rest of the file will be updated in subsequent steps)
