alperbasarn/QNOB/(commit log)

2025-05-01 add pcb's
    [BOM.xlsx, BaseCap v17.stl, Connectors.kicad_sch, LiPoBase.kicad_pcb, LiPoBase.kicad_sch, MCU.kicad_sch, MotorDrive.kicad_sch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]
2026-09-12 Reference the firmware repository as a submodule; drop the moved firmware paths
    The screen firmware lives in alperbasarn/homio-round-hmi and has been checked
    out at screen/SW/ESP as an independent repository since the re-root; QNOB
    still tracked the pre-move screen/SW/esp-idf and screen/SW/arduino trees.
    - Add homio-round-hmi as the submodule at screen/SW/ESP, pinned to its
    p0-baseline commit (6392ed6).
    - Remove the stale screen/SW/esp-idf, screen/SW/arduino, screen/SW/HW and
    screen/SW/.claude paths from the index (they no longer exist on disk).
    - Replace the dangling LovyanGFX .gitmodules entry (its path never existed
    in this tree; the library was vendored as plain files and is now g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
2026-09-12 Bump the firmware submodule to the Phase 0 docs follow-up (8e1cc22)
    Keeps the QNOB checkout on the firmware branch tip so submodule update does
    not detach it from codex/multi-board-support. p0-baseline itself is 6392ed6.
2026-09-12 screen/SW/ESP: WP1.2 domain rules lifted into the model (homio-round-hmi a8424e7)
    Bumps the firmware submodule to the WP1.2 commit: model/Bands, ColorMath, DateFormat, RateLimit, PowerRules, the CommandParsers leaf and the PC media protocol module with their host suites.
2026-09-12 screen/SW/ESP: WP1.3 the eight models (homio-round-hmi d6436ba)
    Bumps the firmware submodule to the WP1.3 commit: ModelBase, AppScreen, the Media/Light/Climate/Environment/Connectivity/Power/Navigation/Knob models and the AppModel that routes to them, with nine new host suites.
2026-09-12 screen/SW/ESP: WP1.4 shadow population and ownership fixes (homio-round-hmi 94edfec)
    Bumps the firmware submodule to the WP1.4 commit: the model root is live, three pollers feed it, one internet owner, no blocking call on the network task, weather key and clock config out of the sources. The Motor Driver sketch edit (last_setPoint removed) is left uncommitted in this tree for the owner.
2026-09-13 Point the firmware submodule at the LED/OTA planning commit (D20, D21)
2026-09-13 Point the firmware submodule at WP2.2 (knob line assembler, LED contract notes)
2026-09-13 Point the firmware submodule at the stage-3 sleep gate
2026-09-13 Point the firmware submodule at the verified stage-3 gate
2026-09-13 Point the firmware submodule at the LED host half (registry, light model, codec)
2026-09-13 Point the firmware submodule at the LED device bridge
2026-09-13 Point the firmware submodule at the LIGHT screen on the registry (LED-05)
2026-09-13 Point the firmware submodule at the LED strip review and the wrong-code rule
2026-09-13 Point the firmware submodule at the threading audit fixes
2026-09-15 Firmware: DEVICE_INFO split into a view and a controller
